felcoslop/LAB_III_Grupo_D_UFMG_2026_2/README.md

# Robô Sumô 1 kg com ESP32









Firmware e painel de telemetria do robô sumô autônomo da classe de 1 kg do **Grupo D**, desenvolvido na disciplina ELE635 Laboratório de Sistemas III da UFMG. O ESP32 lê cinco ou sete sensores de distância VL53L0X e quatro sensores de linha TCRT5000, estima onde está o oponente com um filtro bayesiano em grade, estima onde fica o centro do dojô com um filtro de partículas e decide o movimento com uma máquina de estados de três estratégias, escolhidas na chave DIP. Um painel web, que abre direto no navegador e conversa com o robô pela USB ou, opcionalmente, pelo Wi-Fi do próprio robô, mostra sensores, mapa de probabilidade, rumo e estado em 2D e 3D, e um simulador com o firmware de verdade roda lutas inteiras no GitHub Pages.

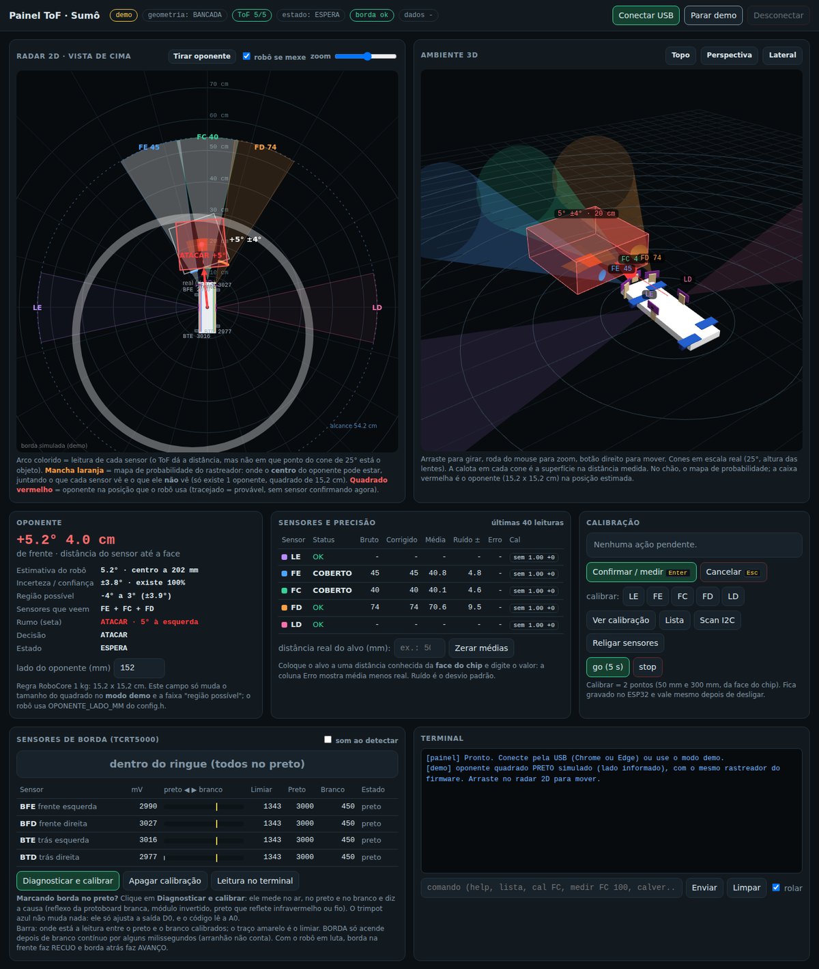
[picture p1: doc/img/painel_demo.jpg]
Painel do robô em modo demo, com radar 2D, ambiente 3D, tabela de precisão e sensores de borda


## Sumário

- [Contexto](#contexto)
- [Funcionalidades](#funcionalidades)
- [Hardware](#hardware)
- [Cinemática das rodas](#cinemática-das-rodas)
- [Estratégias e chave DIP](#estratégias-e-chave-dip)
- [Localização no dojô](#localização-no-dojô)
- [Lutas simuladas](#lutas-simuladas)
- [Combate com dois firmwares](#combate-com-dois-firmwares)
- [Montagem 3D](#montagem-3d)
- [Instalação](#instalação)
- [Uso](#uso)
- [Arquitetura](#arquitetura)
- [Mapa do código](#mapa-do-código)
- [Configuração](#configuração)
- [Estrutura de pastas](#estrutura-de-pastas)
- [Integração contínua](#integração-contínua)
- [Equipe](#equipe)
- [Referências](#referências)

## Contexto

O projeto faz parte da disciplina ELE635 Laboratório de Sistemas III, do curso de Engenharia de Sistemas da UFMG, no semestre 2026/2, com o Prof. Gustavo Medeiros Freitas. A disciplina cobre o ciclo completo de um projeto de engenharia, da concepção até a competição, e o robô segue a classe de 1000 g (Lego/Vex Sumô) das regras de sumô da RoboCore [ROBOCORE, s.d.a]: massa de até 1000 g, base de 15,2 x 15,2 cm, dojô (no código, dohyo) preto de 77 cm de diâmetro com borda branca de 2,5 cm, controle totalmente autônomo e início obrigatório 5 s depois do comando.

A versão atual é o robô montado no chassi de dois andares, sem protoboard: a extensora do ESP32 recebe os sete VL53L0X, os quatro TCRT5000, a ponte H, o botão de início e a chave DIP, a bateria 3S alimenta os motores e uma célula 18650 sozinha alimenta a lógica, com uma chave liga e desliga. A página [Montagem Grupo D](https://felcoslop.github.io/LAB_III_Grupo_D_UFMG_2026_2/montagem.html) mostra cada componente e cada fio, e o CAD final do projeto mecânico está dividido em um STL por peça na pasta [`cad/`](cad/README.md).

O `config.h` vem com `GEOMETRIA_BANCADA 0` (a tabela da bancada só é lida pelos geradores dos PDFs e não é mais usada no robô), `QTD_TOF 5` e `USAR_MOTORES 0`. Com os motores desligados no firmware, o ESP32 fica ligado ao computador pela USB, que alimenta a placa e leva a telemetria, a máquina de estados roda normalmente e o painel mostra o comando que iria para cada roda. Para o robô andar, o `config.h` precisa de `USAR_MOTORES 1` (e `USAR_WIFI 1` para o painel sem cabo). A quantidade de ToF (5 ou 7), o modo autônomo, a posição dos sensores de linha da frente e as outras opções mudam pelo painel e ficam gravadas no robô (seção [Opções do robô](#opções-do-robô-gravadas-pelo-painel)); `QTD_TOF` e `AUTO_START` do `config.h` são só o valor de fábrica. O CI compila o firmware com 5 e com 7 sensores de fábrica, com e sem motores.

## Funcionalidades

- Identificação dos VL53L0X (5 ou 7, escolhidos no painel) pelo pino XSHUT, com endereço I2C próprio para cada sensor e nova tentativa automática quando algum para de responder.
- Leitura escalonada e sem bloqueio dos ToF, com mediana de 3 leituras e calibração de 2 pontos gravada na memória do ESP32.
- Rastreador bayesiano em grade polar, que aproveita também a informação dos sensores que não veem nada e reconhece a arena vazia. A leitura dos ToF e o rastreador rodam no núcleo 0, e o loop com a borda, a localização e a estratégia roda no núcleo 1.
- Perfil de oponente escuro na DIP 4: sensores com mais tempo de medida e limiar de sinal menor para robôs pretos e foscos, e o rastreador com o modelo de ruído desse perfil. O perfil claro continua igual ao de antes.
- Localização no dojô sem encoder: um filtro de partículas estima onde fica o centro do dojô a partir do modelo das rodas e dos sensores de borda. A fuga da borda termina virada para o centro, a busca volta para o meio e leituras de pessoas e objetos fora do dojô não viram oponente.
- Três estratégias na chave DIP (Rush, Flank e Fan out), com resposta de frente a investidas rápidas, empurrão de ré com o oponente colado atrás e reconhecimento do oponente encostado na lateral.
- Rumo (a seta do painel) até o oponente ou até os pontos cegos, usado pela máquina de estados na busca.
- Leitura analógica da linha branca, com confirmação por tempo e calibração guiada em três medidas (ar, preto e branco).
- Máquina de estados com contagem obrigatória de 5 s, busca, mira, ataque, flanco, ataque de ré e fuga da borda em quatro direções, sem nunca girar para trás quando a borda está atrás.
- Reconhecimento de travamento sem encoder: o giro preso pelo oponente encostado na lateral vira uma manobra curta de soltura, e o empurrão longo em contato aparece no painel, reconhecido também pela caixa do rastreador parada, com cinco manobras experimentais de saída que se desligam no `config.h`; um modelo térmico de cada motor limita o PWM das manobras se o motor travado esquentar demais.
- Cinemática das duas rodas com o modelo do motor JGB37-520 e da ponte H: cada estado pede avanço em mm/s e giro em graus/s, a fuga da borda usa a tensão toda na hora e o firmware não compila se a distância de parada não couber na margem até as rodas. Os comandos `pwm` e `mov` testam os motores com o robô parado.
- Painel 2D e 3D em um único arquivo HTML, sem internet, ligado ao robô pela USB ou pelo Wi-Fi, com dados a 50 Hz e comandos pelo navegador.
- WiFi opcional, com a chave `USAR_WIFI` do `config.h` (0 por padrão): com 0 o firmware não tem uma linha do rádio, sem WiFi e sem Bluetooth, o que deixa o núcleo 0 livre para os sensores e o rastreador, e com 1 o painel funciona sem cabo.
- Simulador de lutas (software in the loop): o firmware compilado no computador luta contra seis tipos de oponente, com pessoas paradas em volta do dojô, e o CI roda uma bateria de lutas em todo pull request.
- Combate em 3D com o mesmo firmware nos dois robôs, na física de Belo Horizonte (gravidade e ar do lugar, pneu de silicone na madeira pintada, choque com restituição), e montagem 3D com cada jumper do esquema, as duas em páginas versionadas no repositório.
- Calibração da pista no painel (preto do dojô e faixa branca de 2,5 cm, com pares de sensores) que grava um limiar com margem dos dois lados para cada sensor de linha, contra a borda "alucinada" por arranhão, reflexo ou sujeira.
- Demonstração sem botão, sem chave e sem modo autônomo, só com o painel: "Alinhar com o oponente" (o robô fica no mesmo lugar e só gira, em pulsos, até ficar de frente para o oponente que os sensores da frente veem) e controle remoto WASD, pela USB ou pelo Wi-Fi, valendo com o sensor de linha marcando ou não.
- Opções do robô no painel, gravadas na memória do ESP32 sem regravar o firmware: modo autônomo, sensores de linha da frente de lado, 5 ou 7 sensores de oponente, contagem de 5 s com giro até alinhar (o botão BOOT reinicia a contagem), Wi-Fi ligado na luta e telemetria leve pelo Wi-Fi (só o essencial pelo rádio, para o controle remoto e os ajustes responderem rápido).
- Terminal de comandos pela USB ou pelo painel para teste, calibração e diagnóstico.
- Página de controle dos motores pelo teclado (`site/controle_motores.html`), para o teste do robô parado pela USB, sem os sensores ligados (o mesmo controle também está no painel, pela USB ou pelo Wi-Fi).

## Hardware

| Componente | Qtd. | Uso no projeto |
|---|---|---|
| ESP32 DevKit V1 (ESP32-WROOM-32D, 30 pinos) | 1 | microcontrolador de dois núcleos, com ADC (o rádio só liga com `USAR_WIFI 1`) |
| Extensora (expansion board) do ESP32 de 30 pinos | 1 | recebe o ESP32 e dá um trio S, V e G por GPIO, no lugar da protoboard |
| VL53L0X (placas CJVL53L0XV2 / GY-530) | 7 | distância até o oponente: LE, FE, FC, FD, LD, TE e TD (o firmware também compila com 5, sem TE e TD) |
| TCRT5000 com comparador LM393 | 4 | linha branca da borda, lida pela saída analógica A0 |
| Motor JGB37-520, 12 V, 319 rpm (redução de 18,8:1) | 2 | tração, com pneu StickyMAX S20 de 32 mm [ROBOCORE, s.d.b] |
| Células 18650 (LG 3200) | 3 | bateria 3S, que alimenta os motores pela ponte H |
| BMS 3S de 20 A | 1 | proteção e carga da bateria 3S |
| Célula 18650 sozinha, da lógica | 1 | alimenta o ESP32 e os sensores, pelo regulador TPS63070 |
| Regulador TPS63070 (saída de 3,3 V) | 1 | 3,3 V da lógica, ligado nos pinos V e G da extensora |
| Chave liga e desliga KCD1 | 1 | liga e desliga a célula da lógica (furo C da tampa de trás) |
| Módulo HW-956 de ponte H dupla de 10 A (3 a 18 V, entradas IN1 a IN4) | 1 | ponte H de MOSFET dos dois motores, com PWM de até 2 kHz (desativada na bancada) |
| Botão de início de 12 x 12 mm | 1 | start, ligado entre o GPIO 0 e o GND, em paralelo com o botão BOOT da placa (furo B da tampa de trás) |
| Chave DIP de 4 vias | 1 | ligada nos GPIOs 12, 14, 2 e 15: estratégia (DIP 1 a 3) e perfil do oponente escuro (DIP 4) (furo A da tampa de trás) |
| Jumper fêmea-fêmea | 38 | sensores, ponte H e emendas do I2C (lista completa na página Montagem 3D) |
| Fio soldado com ponta fêmea, com termorretrátil nas emendas | 23 | duas emendas do SDA e do SCL, chave DIP e TPS63070 |
| Fio 22 AWG | 17 | motores, bateria 3S, BMS e alimentação da ponte H, soldados nos bornes e terminais |
| Peças impressas em PLA | 17 | Base, Frente1 e Frente2, Laterais, Hastes, Topo, suportes dos motores e sete suportes de sensor SS_* ([`cad/`](cad/README.md)) |

Os interruptores são três: a chave DIP (estratégia e perfil), a chave liga e desliga KCD1 (só a lógica) e o botão de início. O ramo dos motores não tem chave própria.

| Função | GPIO | Observação |
|---|---|---|
| I2C SDA / SCL | 21 / 22 | barramento comum dos ToF, a 100 kHz |
| XSHUT LE / FE / FC / FD / LD | 17 / 23 / 19 / 18 / 5 | um fio por sensor, define o nome de cada um; o 5 é pino de boot e precisa de nível alto, o mesmo do XSHUT ligado |
| XSHUT TE / TD (só com 7 sensores) | 16 / 4 | sem restrição de boot |
| Borda BFE / BFD (frente) | 34 / 35 | ADC1, pinos só de entrada |
| Borda BTE / BTD (trás) | 32 / 33 | ADC1 |
| Ponte H IN1 / IN2 | 25 / 26 | motor esquerdo, com o PWM de 1 kHz no próprio IN |
| Ponte H IN3 / IN4 | 27 / 13 | motor direito |
| Botão de start | 0 | `INPUT_PULLUP`, nível baixo indica botão apertado; não pode estar apertado na hora de ligar. Sem o botão, o modo autônomo (opção do painel, ou `AUTO_START 1` de fábrica) faz o start sozinho (veja "Teste da máquina de estados") |
| Chave DIP 1 a 4 | 12 / 14 / 2 / 15 | cada via liga o pino no 3V3 |

A pinagem segue o documento de ligação da placa nova (Lab3-Liga) e o esquema do Fritzing. Todos os sensores ficam no 3V3 do ESP32. As placas clone do VL53L0X puxam SDA e SCL para 2,8 V, nível que o ESP32 entende como 1, e o firmware nunca coloca nível alto no XSHUT: para desligar um sensor o pino vira saída em LOW e, para ligar, vira entrada com o pull-up interno. Os sensores de borda usam os pinos 34, 35, 32 e 33 do ADC1 e precisam do fio na saída A0 dos módulos; no esquema atual o fio sai do D0, que só entrega 0 ou 3,3 V e não separa arranhão de linha.

A chave DIP pede três cuidados. A DIP 1, no GPIO 12, precisa estar desligada na hora de ligar o ESP32, porque nível alto nesse pino durante o boot muda a tensão da memória flash e a placa não liga. A DIP 3, no GPIO 2, precisa estar desligada na hora de gravar o firmware. E o GPIO 2 deixou de acender o LED de status (`PINO_LED -1`): com a chave ligada e o pino em LOW, o 3V3 ficaria em curto com o pino. Como o firmware lê a chave o tempo todo e trava a escolha só no start, a DIP 1 pode ser ligada depois do boot, com o robô já no dojô. Outra saída para o GPIO 12 é gravar os eFuses da tensão da flash em 3,3 V (`espefuse.py set_flash_voltage 3.3V` no esptool 4, `espefuse set-flash-voltage 3.3V` no esptool 5), que fazem o ESP32 ignorar o pino no boot; a gravação é permanente e só serve para módulos com flash de 3,3 V, como o ESP32-WROOM-32 do DevKit [ESPRESSIF SYSTEMS, s.d.b].

Na bancada (`GEOMETRIA_BANCADA 1`, que não é mais usada no robô e só alimenta os geradores dos PDFs), a origem do referencial é o centro da protoboard, com x para a frente e y para a esquerda, em milímetros:

| Sensor | XSHUT | Endereço | x | y | Ângulo |
|---|---|---|---|---|---|
| LE | 17 | 0x30 | -1 | 30 | 90° |
| FE | 23 | 0x31 | 73 | 27 | 20° |
| FC | 19 | 0x32 | 87 | -1 | 0° |
| FD | 18 | 0x33 | 73 | -27 | -20° |
| LD | 5 | 0x34 | -2 | -30 | -90° |
| TE (7 sensores, posição prevista) | 16 | 0x35 | -80 | 25 | 160° |
| TD (7 sensores, posição prevista) | 4 | 0x36 | -80 | -25 | -160° |

No robô montado (`GEOMETRIA_BANCADA 0`), a origem fica no meio do eixo das rodas, no chão, e as posições saem do chassi de dois andares do editor 3D v11 (a página `montagem.html` confere esta tabela contra o editor): FE, FC e FD na face inclinada da frente, LE e LD na lateral à frente do eixo, retos, e TE e TD em suportes angulares atrás da roda, a ±160° para trás e para fora:

| Sensor | XSHUT | Endereço | x | y | Ângulo |
|---|---|---|---|---|---|
| LE | 17 | 0x30 | 46 | 70 | 90° |
| FE | 23 | 0x31 | 77 | 32 | 17° |
| FC | 19 | 0x32 | 83 | 0 | 0° |
| FD | 18 | 0x33 | 77 | -34 | -17° |
| LD | 5 | 0x34 | 46 | -70 | -90° |
| TE (7 sensores) | 16 | 0x35 | -30 | 66 | 160° |
| TD (7 sensores) | 4 | 0x36 | -30 | -66 | -160° |

Os PDFs da pasta `doc/pdf/` são da bancada com protoboard: trazem os gabaritos em escala 1:1 da bancada e do robô, o mapa de ligação na protoboard e uma lista de conferência antes de energizar. O `guia_montagem_sensores_7.pdf` faz o mesmo para a versão de 7 sensores e traz também a pinagem completa do ESP32. Para o robô montado, sem protoboard, o guia de ligação é a página Montagem 3D (seção Montagem 3D, abaixo) e a lista de jumpers e fios dela.

### Posição dos sensores: 5 ou 7

A quantidade de ToF em uso (5 ou 7) é uma opção do painel, gravada no robô, que escolhe entre os 5 sensores originais e a versão de 7, com um par atrás do eixo (TE e TD); a constante `QTD_TOF` do `config.h` é só o valor de fábrica, e as duas tabelas do `config.h` sempre trazem os 7 sensores. Na bancada e na previsão do estudo abaixo o par fica nas quinas de trás, a ±160°; no robô montado o par fica atrás das rodas, em suportes angulares (x = -30 mm, y = ±66 mm), também a ±160° (o `config.h` do robô tem essa posição). O LE e o LD continuam retos, a ±90°, na lateral à frente do eixo. A pendência do chassi é a inclinação dos três sensores da frente, que apontam uns 27° para cima (veja a seção Montagem 3D). Os 5 sensores de antes não mudam: FC no centro, que é quem decide o ataque, FE e FD a ±20° na bancada (±17° no robô montado) e LE e LD a ±90°. O par novo fica no fim da tabela, então os 5 sensores de antes mantêm XSHUT, endereço, cor no painel e calibração gravada; com 5 sensores em uso, o XSHUT do TE e do TD fica em LOW e os dois não são usados.

O capítulo 2 do Sumo Robot Blackbook pede número ímpar de sensores, com um no centro para centralizar o oponente, e diz que os sensores precisam vigiar todas as áreas por onde o oponente pode atacar, principalmente os cantos [DEDE, s.d.]. O exemplo de 7 do livro acrescenta duas diagonais na frente, mas o livro não trata de sensores atrás. Com os 5 sensores de hoje, a frente já enxerga bem: o buraco entre FE e LE (de 32,5° a 77,5°) só existe a mais de uns 25 cm, porque os cones se cruzam perto do robô, e o oponente que vem por ali entra em algum cone antes de encostar. A traseira, de 115° a 180°, não tem nenhum sensor. Com o par atrás, o total continua ímpar, o FC continua sozinho no centro e a área sem cobertura passa a ser vigiada.

A escolha saiu de uma simulação com o rastreador do firmware compilado no computador, robô de 152 mm e oponente preto de 15,2 cm: 500 ataques em linha reta a 0,4 a 1,2 m/s com o robô parado, 300 buscas seguindo o rumo do firmware a partir de posições sorteadas dentro do dojô e 240 sequências de rastreio com o oponente andando.

| Robô de 152 mm | 5 (hoje) | 7, par na frente a ±45° | 7, par atrás a ±160° |
|---|---|---|---|
| Ataques que chegam sem ser vistos | 36% | 36% | 8% |
| Ataques por trás que chegam sem ser vistos | 83% | 82% | 9% |
| Tempo médio de busca com o oponente parado (90% dos casos) | 206 ms (700 ms) | 185 ms (660 ms) | 35 ms (140 ms) |
| Tempo médio de busca com o oponente andando (90% dos casos) | 317 ms (922 ms) | 268 ms (880 ms) | 34 ms (120 ms) |
| Erro de ângulo na frente, 90% dos casos | 7,5° | 6,1° | 7,5° |
| Posições do dojô dentro de algum cone | 58% | 64% | 88% |

O par na frente melhora um pouco a mira nas diagonais, mas não muda o que passa sem ser visto. O par atrás reduz os ataques sem aviso de 36% para 8% e deixa a busca cerca de 6 vezes mais rápida, sem mudar a precisão na frente. O ângulo de ±160° veio de uma varredura: com o par a ±140°, ±150°, ±160° e ±170°, os ataques por trás sem aviso ficaram em 17%, 12%, 9% e 8%, e a ±170° o ganho é pequeno e o aviso chega mais tarde. Os pontos sem cobertura que restam são o buraco diagonal a mais de 25 cm e uma faixa estreita bem atrás a mais de 30 cm. Esses números valem para o par a ±160°, que é o do robô montado. Com o par reto a ±90° (a primeira versão do chassi), os dois ToF de cada lado olhavam para a mesma direção e a faixa de trás (de 115° a 180°) ficava sem cobertura, e dois ToF olhando para o mesmo lado somavam a plateia em volta do dojô: na bateria com pessoas em volta, o robô chegou a ficar 45 s mirando uma pessoa e a vitória sobre o oponente parado passou de 2,5 s para 13 s. O par de trás a ±160° também enxerga a plateia: com o alcance inteiro de 600 mm ele mirou uma pessoa por até 53 s em 11 de 540 lutas. O `TOF_ALCANCE_LATERAL_MM` limita o alcance dos laterais (LE e LD) e o `TOF_ALCANCE_TRAS_MM`, o do par de trás (TE e TD). O valor dos laterais saiu da bateria de 540 lutas com pessoas em volta (15 largadas): o maior tempo mirando uma pessoa foi de 49,7 s com 180 mm, 29,8 s com 150 mm, 5,9 s com 120 mm, 29,6 s com 100 mm e 1,0 s com 80 mm, com 347 a 355 vitórias em todos. O padrão ficou em 80 mm: o lado só enxerga o oponente encostado ou quase, e a frente cuida do resto. Para o par de trás, a mesma bateria com o par a ±160° deu 350 vitórias com 80 mm e 352 com 200 mm (351 com o par reto), e o maior tempo mirando uma pessoa foi de 0,5 s e de 0,7 s; o padrão ficou em 200 mm, o que deixa o robô ver por trás o oponente que chega a 20 cm. As vitórias não separam as quatro configurações; o ganho do par a ±160° está na cobertura por trás do estudo acima, que a bateria de lutas não mede sozinha. Esses números são de simulação, e o oponente que passa pela lateral a mais de 8 cm só aparece para os sensores da frente; o teste na bancada com o painel é o que confirma o ganho.

Radar 2D do painel com 7 sensores e o oponente atrás, visto só pelo TE

Com a pinagem da placa nova, os únicos GPIOs livres são o 36 e o 39, que servem só como entrada e não podem acionar um XSHUT. Um 8º sensor precisaria de um pino da chave DIP ou de um expansor I2C, como o PCF8574, e ainda deixaria o número de sensores par, o que o livro desaconselha [DEDE, s.d.].

## Cinemática das rodas

O robô tem duas rodas de tração, uma de cada lado, e anda como um robô diferencial: com as duas rodas na mesma velocidade ele segue reto, com velocidades diferentes ele faz curva e com velocidades opostas ele gira no eixo. A máquina de estados não trabalha com PWM. Cada estado pede um avanço `v`, em mm/s, e um giro `w`, em graus/s (positivo para a esquerda, o mesmo sentido dos ângulos dos sensores), e o módulo `cinematica.cpp` transforma o pedido no PWM de cada lado da ponte H. A origem do referencial fica no meio do eixo das rodas, então o ângulo do oponente que sai do rastreador já é o giro que o robô precisa fazer.

```mermaid
flowchart LR
    EST["estados.cpp<br/>v em mm/s, w em graus/s"] --> DES["desaturação<br/>prioridade para o giro"]
    DES --> LIM["limitador de aceleração<br/>(fora no perfil da borda)"]
    LIM --> CI["cinemática inversa<br/>vE = v - w.B/2<br/>vD = v + w.B/2"]
    CI --> FF["feed-forward<br/>kS + kV.v + kA.a"]
    FF --> MOT["motores.cpp<br/>PWM na ponte H"]
    FF --> EST2["modelo ao contrário<br/>velocidade estimada das rodas"]
    EST2 --> RAS["rastreador<br/>gira o mapa junto"]
    EST2 --> GIR["GIRO_BORDA<br/>mede os 135 graus"]
```

### Simulador na web

A página [https://felcoslop.github.io/LAB_III_Grupo_D_UFMG_2026_2/](https://felcoslop.github.io/LAB_III_Grupo_D_UFMG_2026_2/) roda no navegador as mesmas contas do `cinematica.cpp` e da máquina de estados: o dojô aparece visto de cima, o oponente pode ser arrastado com o mouse e o botão Rodar mostra, a cada instante, o pedido do estado, a desaturação, o limitador, a cinemática inversa, o feed-forward e o PWM de cada roda, junto com o caminho do robô e a fuga da borda. Embaixo, a página refaz a conta da distância de parada para qualquer tensão de bateria e qualquer atrito. O código da página fica em `site/index.html`; o workflow `pages.yml` publica a página no GitHub Pages a cada mudança na `main`, e o CI roda o `ferramentas/confere_site.py` em todo pull request para garantir que as constantes da página continuam iguais às do `config.h`.

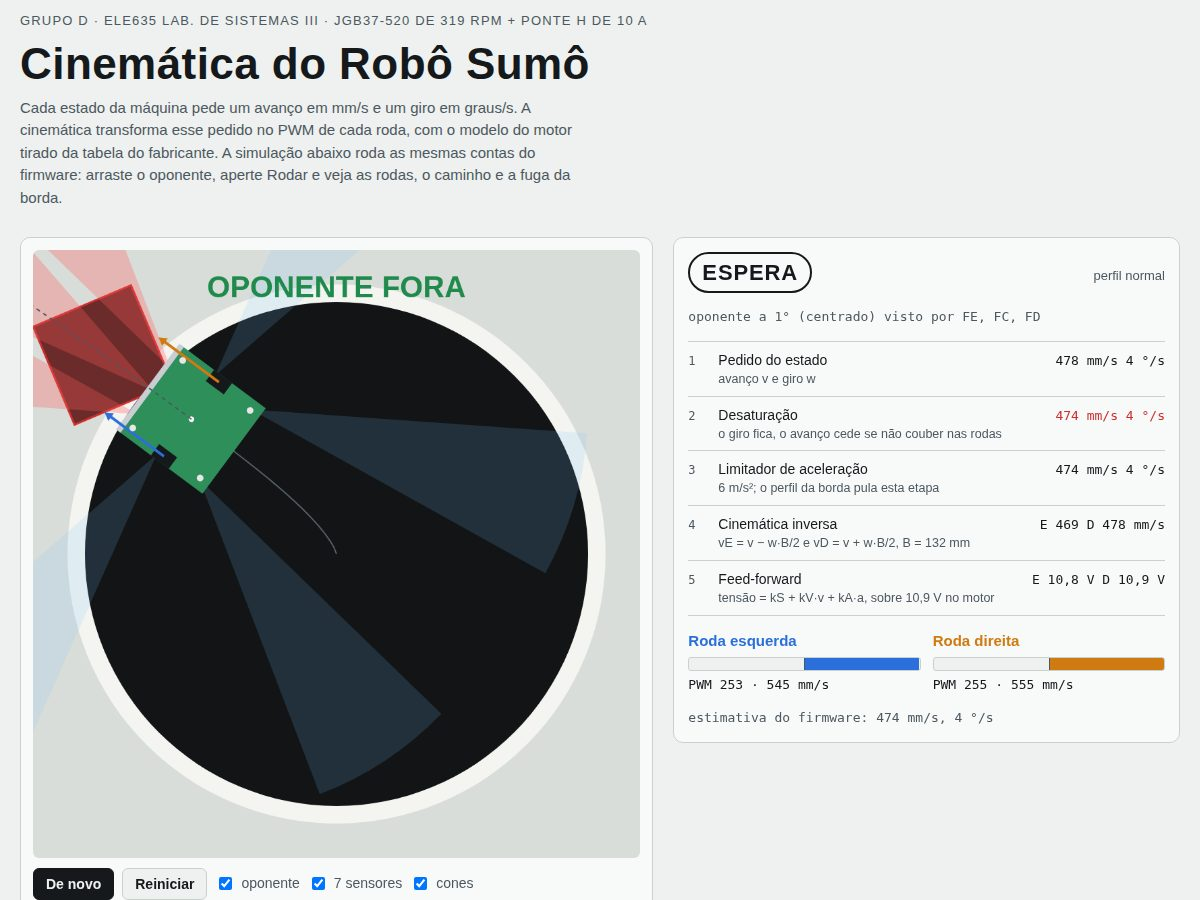
[picture p2: doc/img/simulador_cinematica.jpg]
Simulador da cinemática no navegador, com o robô empurrando o oponente para fora do dojô (https://felcoslop.github.io/LAB_III_Grupo_D_UFMG_2026_2/)


### Modelo do motor

A base do modelo é a tabela do fabricante para a linha de 12 V e 319 rpm do JGB37-520 [RCDRONE, s.d.] e a medida do pneu [ROBOCORE, s.d.b]. O esquema da placa mostra um L298N, mas a ponte usada é um módulo de 10 A com transistores MOSFET, que perde só alguns décimos de volt; um L298N perderia de 1,8 a 3,2 V com 1 A [STMICROELECTRONICS, s.d.a]. O anúncio do motor fala em 21 kgf.cm, valor que não fecha com a corrente de 1,2 A nem com a redução de 18,8:1 e por isso ficou de fora.

| Dado | Valor | Origem |
|---|---|---|
| Rotação livre a 12 V | 319 rpm | tabela do motor |
| Redução | 18,8:1 | tabela do motor |
| Corrente livre e com o eixo travado | 0,1 A e 1,2 A | tabela do motor |
| Torque com o eixo travado | 1,9 kgf.cm (0,19 N.m) | tabela do motor |
| Tensão de partida | 1,5 V | tabela do motor |
| Queda na ponte H | cerca de 0,2 V | estimada para a ponte de MOSFET, precisa de medida |
| Diâmetro da roda | 32 mm | pneu StickyMAX S20 |
| Bitola (centro a centro das rodas) | 126,8 mm | STEP LAB3-Modelagem do projeto mecânico (10/2026); medir no chassi |

O modelo do motor é uma reta de tensão por velocidade que passa pelos dois pontos da tabela: 1,5 V para sair do lugar e 319 rpm livre com 12 V. Com a bateria 3S em 11,1 V e 0,2 V perdidos na ponte H, o motor recebe 10,9 V com PWM de 100%:

| Resultado do modelo | Valor |
|---|---|
| Velocidade máxima em linha reta | 478 mm/s (cerca de 555 mm/s com a bateria cheia) |
| Giro máximo no eixo | 417 graus/s, meia volta em 0,43 s |
| kS, kV e kA de cada roda | 1,5 V; 19,6 mV por mm/s; 1,25 mV por mm/s² |
| Força no chão na partida, por roda | 3,9 N, no limite dos 3,9 N que o atrito permite com atrito 1 |
| Distância de parada na borda, no pior caso | 38 mm |

Esses números corrigem três valores antigos do `config.h`, que estavam marcados como "precisa ser medido". O rastreador girava o mapa a 600 graus/s com PWM máximo, quase 45% acima do giro real, e andava com ele a 1500 mm/s, mais de três vezes a velocidade real. E o giro de fuga da borda, de 250 ms com PWM 200, dava só uns 80 graus, e não os 135 graus do comentário.

### Do pedido ao PWM

Cada volta do loop passa o pedido da máquina de estados por quatro etapas:

1. Desaturação com prioridade para o giro. Quando avanço e giro juntos passam da velocidade máxima de uma das rodas, o avanço diminui e o giro fica. O linorobot2_hardware reduz os dois na mesma proporção [JIMENO, 2021]; no sumô a mira vale mais que a velocidade, porque um robô que chega rápido e torto entrega a lateral para o oponente.
2. Limitador de aceleração, no estilo do SpeedLimiter do diff_drive_controller [ROS-CONTROLS, s.d.], com 6 m/s², perto do limite de tração. O limite segura as reversões bruscas, quando a corrente do motor chega a 2 A e a roda patina, e também a partida, que com a ponte de MOSFET fica no limite da tração. O perfil da fuga da borda não passa por ele.
3. Cinemática inversa do diff_drive_controller [ROS-CONTROLS, s.d.]: a roda esquerda anda `v - w.B/2` e a direita `v + w.B/2`, com B a bitola.
4. Feed-forward do SimpleMotorFeedforward do WPILib [WPILIB, s.d.]: a tensão de cada roda é `kS.sinal(v) + kV.v + kA.a`, dividida pela tensão que chega no motor. O kS vence o atrito de partida; sem ele, um pedido de 5 mm/s viraria PWM 2 e a roda nem sairia do lugar.

O JGB37-520 deste projeto não tem encoder. Por isso o mesmo modelo, rodado ao contrário, estima a velocidade real de cada roda a partir do PWM aplicado, com o atraso de 60 ms do motor. A estimativa entra no rastreador, que gira o mapa de probabilidade junto com o robô, e mede o giro de recuperação na borda.

### Cada estado em avanço e giro

| Estado | Avanço `v` | Giro `w` | Perfil |
|---|---|---|---|
| BUSCA sem pista | 0 | 200 graus/s para o lado do rumo | normal |
| BUSCA com o oponente provável à frente, ou no avanço curto | 240 mm/s | 0 | normal |
| MIRA até 40 graus | `VEL_MAX.cos(ângulo)` | `6.ângulo`, até 370 graus/s | normal |
| MIRA acima de 40 graus | 0 | 370 graus/s para o lado do oponente | normal |
| ATAQUE | `VEL_MAX` | `6.ângulo` (correção) | normal |
| RECUO | `-VEL_MAX` | 0 | borda |
| AVANCO_BORDA | `VEL_MAX` | 0 | borda |
| GIRO_BORDA | 0 | 370 graus/s, até 135 graus estimados | normal |

A mira é proporcional: o giro pedido é 6 graus/s para cada grau de erro, e o erro cai a 37% em cerca de 0,17 s. Com o oponente a 20 graus para a esquerda, por exemplo, a mira pede 120 graus/s de giro e 450 mm/s de avanço. Os dois juntos não cabem nas rodas, então a desaturação baixa o avanço para 340 mm/s e as rodas ficam em 202 mm/s (esquerda) e 478 mm/s (direita): uma curva fechada para o oponente, sem perder a mira. No ataque, a mesma correção mantém o oponente no centro enquanto o robô empurra.

### A borda vem antes de tudo

O RECUO e o AVANCO_BORDA usam o perfil da borda: sem limitador e com a tensão toda no sentido da fuga já na primeira volta do loop. No pior caso, com a bateria cheia e o robô a 555 mm/s, o robô percorre uns 3 mm durante os 6 ms de confirmação da borda e da volta do loop e mais 35 mm freando com a roda patinando para trás (atrito 0,7 e 80% do peso nas rodas), cerca de 38 mm no total. A margem é a faixa branca de 25 mm somada à distância entre o sensor de borda e o eixo das rodas, 60 mm no robô, ou seja, 85 mm. O `cinematica.cpp` faz essa conta durante a compilação (`static_assert`): um motor mais rápido, uma roda maior ou uma bateria com mais tensão que quebrem a margem param a compilação com uma mensagem de erro. Na frenagem mais longa, a ponta da lâmina pode passar da borda do dojô por um instante, mas as rodas ficam sempre a mais de 45 mm dela.

O giro de recuperação (GIRO_BORDA) também mudou. Antes ele durava um tempo fixo e ignorava a borda; agora ele termina quando a cinemática estima 135 graus, com 900 ms como limite de segurança, e continua vigiando a borda: uma quina que volta ao branco no meio do giro, ou um empurrão do oponente, leva o robô de novo ao RECUO ou ao AVANCO_BORDA.

### Acerto do modelo com o robô montado

Os valores marcados com "medir" no `config.h` ficam certos só com o robô montado. O capítulo 11 do Blackbook manda medir as primitivas de movimento antes de montar qualquer tática: a distância percorrida em um tempo fixo e o tempo de uma volta completa no eixo [DEDE, s.d.]. O comando `cin` mostra os números do modelo, e o comando `mov V W MS` faz o robô parado em ESPERA andar com avanço V e giro W por MS milissegundos e, no fim, mostra a distância e o giro estimados. Com `mov 300 0 1000`, a distância medida com a régua, comparada com a estimada, acerta o `MOTOR_RPM_LIVRE` ou a `PONTE_QUEDA_V`; com `mov 0 300 1000`, o giro medido no chão acerta a `BITOLA_MM`. Qualquer borda vista interrompe o teste na hora. Antes disso, o comando `pwm E D MS` confere os fios: cada roda recebe a porcentagem de PWM pedida (de -100 a 100, positivo para a frente), sem passar pela cinemática. Com `pwm 30 0 1000` só a roda esquerda precisa girar, para a frente; roda ao contrário se corrige com `INVERTE_ESQ` ou `INVERTE_DIR` e rodas trocadas com `TROCA_MOTORES`. Os dois testes funcionam com os ToF desligados, porque rodam no estado ESPERA, e durante eles o firmware não tenta religar os ToF.

A página [Controle dos motores](https://felcoslop.github.io/LAB_III_Grupo_D_UFMG_2026_2/controle_motores.html) (`site/controle_motores.html`) faz esses testes com as teclas W, A, S e D ou com as setas, em vez de digitar os comandos, e a barra de espaço para o robô. Ela conversa com o ESP32 pela porta USB (Web Serial, no Chrome ou no Edge do computador) e envia `mov` ou `pwm` a cada 120 ms, cada um válido por 250 ms, e `stop` ao soltar a tecla. Por isso o robô para sozinho quando a página perde o foco ou o cabo sai. A página precisa do firmware com `USAR_MOTORES 1`. Sem os TCRT5000 ligados, `USAR_BORDA` também precisa ficar em 0, porque um pino solto do ADC pode ler abaixo de 600 mV, contar como linha branca e interromper o teste na hora. Na primeira vez, com as rodas fora do chão, o modo PWM acerta `INVERTE_ESQ`, `INVERTE_DIR` e `TROCA_MOTORES`.

## Estratégias e chave DIP

As três estratégias da proposta do Grupo D [GRUPO D, 2026a] ficam nas vias 1 a 3 da chave DIP, e a via 4 escolhe o perfil do oponente. O firmware lê a chave com um filtro de 30 ms contra trepidação e trava a escolha no start: mexer na chave durante a luta não muda nada. Sem nenhuma via de estratégia ligada vale o Rush, e com mais de uma ligada vale a de menor número (o comando `lista` avisa o conflito). Os comandos `estrategia` e `perfil` passam por cima da chave para testes na bancada.

Na simulação de combate com os motores de 319 rpm, a escolha para a competição é o Rush (nenhuma via ligada), com o robô sempre colocado de frente para a metade do oponente: de frente, o Rush fez 119 vitórias, 0 derrotas e 42 empates em 161 lutas, o Fan out 52 vitórias e 0 derrotas em 114, e o Flank 39 vitórias e 28 derrotas em 125 (seção "Otimização do ataque com os motores de 319 rpm").

| DIP 1 | DIP 2 | DIP 3 | Estratégia | Busca sem pista | Chegada no oponente |
|---|---|---|---|---|---|
| ligada | desligada | desligada | Rush | giro no eixo para o lado do rumo, com avanços curtos | mira em curva e ataque com o torque todo |
| desligada | ligada | desligada | Flank | igual ao Rush | na largada, arco largo, mirando 75° ao lado do oponente mesmo com ele vindo rápido; depois, espiral que fecha na lateral dele |
| desligada | desligada | ligada | Fan out | leque: o rumo oscila 45° para cada lado e o robô avança devagar | zigue-zague (estado LEQUE): o rumo vai 30° para cada lado do oponente, trocando a cada 200 ms, e perto dele o ataque é direto |

| DIP 4 | Perfil | Sensores | Rastreador |
|---|---|---|---|
| desligada | oponente claro | o perfil de sempre: 20 ms por medida, limite de sinal 0,25 MCPS | o modelo de sempre |
| ligada | oponente escuro | 33 ms por medida, limite de sinal 0,10 MCPS e pulsos longos (VCSEL 18 e 14), alcance de 700 mm no preto | 15% de chance de não ver o oponente dentro do cone, 2,5 vezes mais leituras falsas, 1,5 vez mais ruído e 180 ms até perder o alvo |

O perfil escuro troca velocidade e limpeza da medida por sensibilidade. Um robô preto e fosco devolve pouca luz ao VL53L0X, e no perfil claro ele some antes do fim do dojô; com mais tempo de medida e um limite de sinal menor, o sensor enxerga mais longe, ao custo de uma medida a cada 33 ms e de mais leituras falsas, que o rastreador absorve com o modelo de ruído do perfil. Nas lutas simuladas contra oponentes escuros e furtivos (240 lutas, Rush, com e sem a DIP 4), o perfil escuro baixou o tempo até achar um oponente furtivo parado de 1,0 s para 0,5 s e o tempo até vencer o oponente errante escuro de 8,6 s para 4,4 s; as 240 lutas terminaram em vitória nos dois perfis.

No dojô de 77 cm, cada robô vê o outro assim que os 5 s acabam, e antes das aberturas as três estratégias faziam a mesma coisa na largada: a investida do outro robô cancelava o flanco, e o leque só valia na busca sem pista. Agora cada uma tem a sua abertura, com o oponente a até 60° da frente quando os 5 s acabam. O Rush vai direto. O Flank sai num arco largo, mirando 75° ao lado do oponente por até 0,7 s, mesmo com ele vindo rápido, e vira para ele quando o oponente fica a 75° da frente. O lado do arco é o que tem mais espaço até a borda pela localização, quando ela já é confiável. O Fan out chega em zigue-zague (estado LEQUE) e ataca direto a 14 cm. No combate com o mesmo firmware nos dois robôs (180 lutas, 10 largadas por combinação, contra os adversários de 1000, 600 e 319 rpm), o Rush venceu 25, perdeu 16 e empatou 19 de 60 lutas; o Flank, 24, 18 e 18; o Fan out, 16, 20 e 24. Com 60 lutas por estratégia, a diferença entre o Rush e o Flank fica dentro do erro da amostra (uns 5 pontos) e só o Fan out aparece atrás. O arco tira o robô da linha da investida, mas o adversário com o mesmo firmware vira para ele e às vezes encontra a lateral exposta. O ângulo do arco saiu de uma comparação com o Flank largando de frente (40 lutas por versão): com 60° e 1 s, 30 derrotas; com 75° e 0,7 s, 12; com 80°, 5, mas numa luta do `teste/sim` o arco deixou o robô na borda de frente para uma pessoa, e ele passou 4,7 s mirando nela, acima do limite de 3 s do CI. Nas lutas do `teste/sim`, o Flank venceu as 48 lutas contra o parado, o pesado e o rápido.

Depois da largada, no Flank, com o oponente à vista a mais de 24 cm e sem investida, o robô mira 35° ao lado dele; com o desvio constante, o caminho vira uma espiral que termina na lateral do oponente. O lado é o que tem mais espaço até a borda, pela localização no dojô. A 18 cm do oponente, com ele aberto mais de 75°, depois de 1,5 s ou se ele investir, o robô ataca direto. No Fan out, o leque só avança com pelo menos 20 cm livres à frente.

Algumas regras valem nas três estratégias. Um oponente que vem de frente a mais de 300 mm/s (investida) é recebido de frente, e o robô empurra com o torque todo: o JGB37-520 tem redução de 18,8:1, e um robô rápido costuma ter pouco torque, então oferecer a lateral numa curva é o pior caso. Com o oponente colado na frente, o ToF pode perder a leitura por estar perto demais, e o ataque continua por 400 ms sem confirmação. Com o oponente colado atrás (versão de 7 sensores), o robô empurra de ré em vez de girar 180° na frente dele. Uma leitura abaixo de 15 mm, o mínimo do VL53L0X, conta como oponente encostado naquele lado: o rastreador recebe essa posição, e o robô vira para ele em vez de perseguir outra coisa. E a busca sem pista começa voltando para o meio do dojô, quando a localização mostra o robô a mais de 15 cm do centro.

### Travamento

Sem encoder e sem medida de corrente, o firmware não vê a roda parada, mas reconhece dois travamentos pelo que a cinemática estima e pelo que os sensores veem.

O giro preso acontece com o oponente encostado na lateral: a mira pede giro, a cinemática estima mais de 90° de giro em 0,6 s, e o ângulo do oponente melhora menos de 15°, porque a quina dele segura a quina do robô. O robô entra no estado DESTRAVA: ré reta por 250 ms quando existe espaço atrás (sem branco atrás há pouco e, com a localização confiável, mais de 14 cm até a borda), ou avanço reto por 250 ms sem espaço atrás, e volta a mirar com a quina livre. Uma ré que termina na borda de trás faz as manobras dos 5 s seguintes usarem o avanço.

O empurrão travado é o ataque em contato que passa de 1,6 s sem a luta acabar. Nesse caso o robô continua empurrando, e o travamento só aparece no log e no painel. A decisão saiu das lutas simuladas: com 360 lutas por versão (3 estratégias, 6 oponentes, claro e escuro, 10 largadas), soltar o empurrão travado com ré e curva derrubou as vitórias contra o errante de 56 para 28 a 33 e transformou 49 empates contra o espelho em derrotas, com o limite de 1,6 s, 2,5 s ou 4 s; girar sob pressão (uma roda no máximo e a outra a 20%), girar no eixo ou dar ré em curva também perderam. Contra um oponente que empurra de volta, qualquer soltura entrega o lugar, e o empurrão mais longo que dá certo nessas lutas, contra o oponente pesado, passa de 5 s.

O módulo `antitrava.cpp` (experimental, fora com `ANTI_TRAVA 0` no `config.h`) reconhece o empurrão travado pela caixa do rastreador bayesiano, sem encoder: a caixa do oponente fica parada no referencial do robô, com a distância dentro de 25 mm e o lado dentro de 12°, por 1,2 s, com o robô no ATAQUE e o oponente encostado (ou a menos de 60 mm). Um salto da estimativa mais curto que 150 ms, comum com a leitura colada no contato, não zera a janela. Um empurrão que funciona também deixa a caixa parada, mas leva o oponente para fora do dojô de 77 cm em pouco mais de 1 s; passado esse tempo, os dois robôs estão empatados na força. Depois da detecção vem a manobra escolhida em `ANTI_TRAVA_MANOBRA`, ou pelo comando `trava N`, sem gravar:

| N | Manobra | O que o robô faz | Contra o robô igual (319 rpm, 60 lutas) | Contra o de 1000 rpm (60 lutas) |
|---|---|---|---|---|
| 0 | nenhuma | só avisa no log e no painel | 12 vitórias, 19 derrotas, 29 empates | 44, 14, 2 |
| 1 | lateral | ré em arco por 200 ms para o lado com mais espaço e volta em arco pela lateral do oponente (sem espaço atrás, vira a 2) | 12, 29, 19 | 45, 14, 1 |
| 2 | torque | 500 ms de empurrão com giro de 150°/s para o lado com mais espaço | 12, 19, 29 | 45, 14, 1 |
| 3 | zigue | o mesmo da 2, trocando o lado a cada 125 ms | 12, 19, 29 | 45, 14, 1 |
| 4 | giro | giro no eixo por 200 ms, com tensão toda desde o primeiro instante (perfil da borda, sem a rampa de aceleração), e volta a mirar | 13, 38, 9 | 44, 14, 2 |
| 5 | pulso | rodas soltas por 20 ms e empurrão de novo, três vezes | 12, 19, 29 | 44, 14, 2 |

Contra o robô igual, que continua empurrando, a ré com volta pela lateral trocou 10 dos 29 empates por derrotas e o giro trocou 20, porque o adversário com o mesmo motor empurrou o Grupo D para fora durante a manobra, como a equipe previa; o giro ganhou uma luta a mais (13 vitórias contra 12), e as outras manobras, nenhuma. Com o chassi novo, o torque, o zigue-zague e o pulso não mudaram nenhuma luta contra o igual. Com o chassi anterior (ponta da rampa a 117,7 mm e os sensores de trás a ±160°), o torque e o zigue-zague tinham trocado 66 e 92 empates por derrotas, então esse resultado depende da geometria e do rastreador, e as três só valem a pena depois do teste no dojô. A versão do pulso com ré de 50 ms perdeu 92 empates no chassi anterior; com as rodas soltas por 20 ms, ela não muda nenhuma luta. Com o oponente empurrando, o giro não passa de uns 10° em 200 ms, com ou sem a rampa de aceleração, e o robô é levado uns 10 cm para trás: sem avanço, as duas rodas em sentidos opostos não resistem ao empurrão. Variantes com solta de 60 a 200 ms, giro de 60 e 100 ms, ré de 60 e 100 ms e curva de 40 a 250°/s também foram testadas contra o igual, no chassi anterior: todas as que soltam por 100 ms ou mais perderam 11 a 12 das 12 lutas de cada teste, as de 60 ms perderam 10 ou 11, e só as que mantêm o empurrão (curva de até 80°/s, solta de até 60 ms) mantiveram o empate, sem nenhuma vitória. Girar o próprio robô também expõe a lateral dele à rampa do oponente. Por isso o firmware sai com `ANTI_TRAVA_MANOBRA 0`, e as manobras ficam para o teste no dojô de verdade, onde a deformação do pneu, a folga das caixas de redução e o piso irregular, que a simulação não tem, podem desempatar. Na página do combate, o seletor "Empurrão travado" liga cada manobra no robô do Grupo D, e um alerta piscante "Robô travado" mostra quem está travado e em que nível: empurrão travado (1,6 s), ré da DESTRAVA ou manobra da caixa parada. Para apagar o módulo de vez: os arquivos `antitrava.h` e `antitrava.cpp`, as linhas com `ANTI_TRAVA` no `estados.cpp` e no `debug.cpp` e o nome `antitrava` nas listas de compilação dos testes.

O cuidado com a sobrecarga fica com o modelo térmico de cada motor no `cinematica.cpp`. A corrente sai da tensão aplicada menos a força contraeletromotriz, sobre a resistência de 10 Ω (12 V e 1,2 A com o eixo travado, pela tabela do motor), e com a roda travada a força contraeletromotriz é zero. O calor entra num modelo de primeira ordem, com capacidade e resistência térmicas estimadas para um motor de 37 mm. Pelo modelo, um round inteiro de 90 s com o motor travado no máximo esquenta o motor uns 22 K, e o limite de 70% do PWM só liga com 60 K, depois de uns 7 minutos travado, como numa bancada com o robô preso contra a parede; a fuga da borda nunca é limitada. A ponte H HW-956 aguenta 10 A por canal, bem acima dos 1,2 A do motor travado, e a bateria 3S entrega os 2,4 A dos dois motores sem esforço. A capacidade e a resistência térmicas do modelo precisam de medida com um termômetro no motor, com o robô montado.

### Fuga da borda

A borda vem antes de qualquer estratégia. Cada sensor de borda confirmado no branco diz de que lado está a faixa, e a manobra depende da combinação:

| Sensores no branco | Estado | Manobra |
|---|---|---|
| só os da frente | RECUO | ré com a tensão toda até o branco sumir, mais 10 ms; um recuo que não tira a frente do branco em 300 ms (robô preso entre a borda e o oponente) vira uma curva de ré que desencaixa a traseira |
| só os de trás | AVANCO_BORDA | avanço com a tensão toda, sem nenhum giro para trás |
| frente e trás do mesmo lado | SAIDA_LATERAL | curva para dentro com a roda de dentro parada, o movimento que menos joga o canto de trás para fora |
| frente e trás em lados opostos | GIRO_BORDA | giro direto para o centro do dojô |

Depois do recuo, o GIRO_BORDA vira o robô de frente para o centro do dojô, pela localização, e a busca leva o robô de volta para o meio, já de frente para a outra metade do dojô; sem localização confiável, o giro é de 135° para longe da borda. O giro continua vigiando o oponente e a borda. Com a borda de trás no branco, girar para olhar para trás não faz sentido, porque atrás da faixa só existe o lado de fora e nenhum oponente: o robô avança, e por 400 ms os ToF de trás ignoram qualquer coisa a mais de 120 mm.

## Localização no dojô

O JGB37-520 não tem encoder e o robô não tem IMU, então a posição no dojô sai do modelo das rodas (`cinematica.cpp`) e dos quatro sensores de borda. O dojô é um círculo: o rumo absoluto não importa, basta saber onde fica o centro do dojô visto do robô. O `arena.cpp` guarda 600 hipóteses desse ponto em um filtro de partículas [THRUN; BURGARD; FOX, 2005]. A cada 5 ms o centro de cada hipótese anda ao contrário do movimento estimado do robô; cada partícula tem o próprio erro de escala do avanço e do giro, porque o erro do modelo das rodas é sistemático (bateria, atrito, pneu). Um sensor no branco diz que ele está na faixa, um sensor no preto diz que ele não está, e as rodas precisam estar dentro do dojô, senão o robô já teria caído. O modelo do branco tem um pico estreito onde o sensor deve estar e uma cauda larga, que puxa a nuvem para a explicação certa quando nenhuma hipótese bate com a borda.

Em contato com o oponente, ou com algo encostado num ToF, o modelo das rodas deixa de valer: o robô pode estar travado, patinando ou sendo empurrado de lado. Nesse caso cada partícula sorteia quanto do movimento pedido aconteceu e uma velocidade de empurrão, e guarda esse sorteio enquanto o contato dura; a borda escolhe as hipóteses certas. O mesmo modelo entra quando o branco que continua aparece onde o filtro confiante esperava preto, sinal de que o movimento real fugiu do modelo.

A localização tem três usos. O GIRO_BORDA termina de frente para o centro e a busca volta para o meio do dojô. O Flank e o Fan out medem o espaço livre até a borda em cada direção. E a percepção descarta o que cai fora do dojô: uma leitura de ToF só é descartada quando as 64 hipóteses da amostra colocam o ponto a mais de 30 mm além da borda, e o mapa do rastreador apaga, em cada direção, só os anéis que ficam fora em todas elas. O alcance dos ToF, de 600 mm, vem do pior caso dentro do dojô (o robô do Grupo D numa borda e o oponente encostado na borda oposta), então o oponente em qualquer ponto do dojô fica dentro do alcance.

O teste `teste/unidade/teste_arena.cpp` roda 150 lutas de um robô de mentira que larga como manda a CoRA, anda até a borda, recua, gira para o centro estimado e repete cinco vezes, com o modelo das rodas certo ou errado em 15%. Com 12 sementes e as duas geometrias (9000 medidas):

| Medida | Resultado |
|---|---|
| Erro do centro depois de 5 toques na borda, mediana | 19 a 23 mm |
| Erro do centro depois de 5 toques, 90% das lutas | 46 a 60 mm |
| Incerteza coerente com o erro (erro abaixo de 2,5 sigma + 2 cm) | 99% a 100% |
| Localização marcada como confiável com erro acima de 10 cm | 1,2% a 4,5% |
| Leitura do oponente a 6 cm da borda descartada como fora | 3 em 9000 (0,03%) |
| Pessoa a 12 cm além da borda descartada | 45% a 51% |

Os três descartes errados aconteceram com o filtro confiante e errado por mais de 30 cm, caso que o motor sem encoder não permite eliminar; uma leitura descartada vira "sem informação", e as leituras seguintes, de outros sensores ou de mais perto, continuam valendo. O descarte das pessoas não precisa ser completo: o que escapa dele bate no alcance de 600 mm, na regra da borda de trás e no rastreador, e nas lutas simuladas o robô mirou objetos de fora do dojô por no máximo 2,5 s numa luta inteira, numa luta de 36 s com o oponente encostado na lateral. O comando `arena` mostra o centro estimado, a incerteza, o espaço livre em 8 direções e o tempo do passo do filtro, que no computador leva uns 20 µs.

## Lutas simuladas

A pasta `teste/sim` compila o firmware de verdade (percepção, ToF, rastreador, localização, borda, estados, cinemática e motores) junto com um mundo simulado: física das rodas com atrito e tração, VL53L0X com cone, sinal, ruído e leituras falsas, TCRT5000 com o analógico do preto, do branco e do chão de fora, e um oponente com inteligência própria. Os robôs largam como manda a CoRA, cada um na sua metade, atrás da linha Shikiri e virado para qualquer lado, e a luta dura até alguém sair do dojô ou 90 s. Com a opção `-f`, pessoas paradas a 12 a 80 cm da borda entram na cena, visíveis para os ToF.

| Oponente | Comportamento |
|---|---|
| parado | caixa parada, com os motores desligados e a redução travada |
| pesado | parado, com pneu mais grudento e lâmina melhor |
| rápido | ataca a 1,3 m/s, com motor de alta rotação e pouco torque |
| lento | ataca a 0,2 m/s, com redução alta, muito torque, pneu grudento e lâmina melhor |
| errante | anda sem rumo pelo dojô e ataca só de perto |
| espelho | o mesmo motor, a mesma roda e a mesma lâmina do robô do Grupo D, atacando do mesmo jeito |

O robô do Grupo D tem as medidas do STEP do projeto mecânico (LAB3-Modelagem): rampa 118 mm à frente do eixo das rodas, traseira 31 mm atrás, 149 mm de largura, 980 g e o centro de massa 26,9 mm à frente do eixo. Na bateria com pessoas em volta do dojô (3 estratégias, 6 oponentes, claro e escuro, 15 largadas cada, 540 lutas), o robô venceu 351 lutas, perdeu 121 e empatou 68, e nunca saiu do dojô sozinho: 90 de 90 contra o parado e contra o pesado, 87 contra o rápido e 84 contra o errante. O lento, com mais torque e uma lâmina melhor, ganhou as 90 lutas, e o espelho, de força igual, terminou empatado em 66 de 90; nos dois casos o robô fica travado empurrando um oponente que não cede, e a seção [Travamento](#travamento) mostra por que soltar o empurrão piora o resultado. Sem as pessoas e com o oponente furtivo, que quase não reflete, a bateria de 810 lutas também terminou sem nenhuma queda própria.

A página [Lutas simuladas](https://felcoslop.github.io/LAB_III_Grupo_D_UFMG_2026_2/lutas.html) mostra as lutas no navegador: escolha de estratégia, oponente, cor e largada, com os dois robôs, o caminho, o dojô que a localização estima, o oponente que o rastreador estima, o estado e o PWM de cada roda a cada instante. O workflow da página gera os rastros e o placar com o firmware da `main` a cada publicação.

Luta simulada na página: Flank contra o oponente errante e escuro, com o dojô estimado pela localização e as pessoas em volta

No computador, a mesma bateria roda com:

```
bash teste/sim/compila.sh
python teste/sim/roda_lutas.py teste/sim/luta --dips 1,2,4 --fora --perfil-pela-cor --sementes 15
```

## Combate com dois firmwares

A pasta `teste/combate` coloca dois robôs com o mesmo firmware no mesmo dojô: o do Grupo D e um adversário igual, com motores de 1000, 600 ou 319 rpm. Cada módulo do firmware entra duas vezes no mesmo programa, uma no namespace `fa` e outra no `fb` (`fw_modulo.cpp`), sem nenhuma linha do firmware mudar, e o Arduino de mentira (`hal_combate.cpp`) atende o robô da vez com o relógio, a chave DIP, o botão de start, os quatro TCRT5000, os sete VL53L0X e o PWM da ponte H. O mesmo código vira um executável para a bateria de lutas e um módulo WebAssembly para a página [Combate Grupo D](https://felcoslop.github.io/LAB_III_Grupo_D_UFMG_2026_2/combate.html), compilado com o Zig 0.14 [ZIG SOFTWARE FOUNDATION, 2025].

A página mostra a luta em 3D com as peças do STL do projeto mecânico (base, corpo, suporte da eletrônica, abraçadeiras, JGB37-520, cubos e pneus), numa sala em Belo Horizonte às 20h00 de 2 de setembro, só com a lâmpada de LED do teto acesa. Na tela entram a estratégia do Grupo D, a cor e os motores do adversário, a estratégia dele e a posição na largada de cada um dos dois robôs; o placar mostra o estado de cada firmware, e a telemetria mostra velocidade, PWM, corrente, bateria e o peso em cada apoio. A camada de detecção mostra só o que o firmware do Grupo D enxerga, como no painel: o cone de cada VL53L0X com a calota na distância medida, o mapa de probabilidade do rastreador, a caixa vermelha do oponente na posição estimada e um círculo embaixo de cada TCRT5000. Cada cone tem o alcance que o firmware aceita para aquele sensor: 600 mm na frente, `TOF_ALCANCE_LATERAL_MM` (80 mm) no LE e no LD e `TOF_ALCANCE_TRAS_MM` (200 mm) no par de trás. Um oponente além do cone curto não é lido, não entra no rastreador e por isso não ganha a caixa vermelha, mesmo que esteja na direção do sensor; o `confere_site.py` compara essas três constantes da página com o `config.h`. No controle manual, as setas (ou W A S D) dirigem o robô do Grupo D ou o adversário depois dos 5 s parados.

### Física

| Item | Valor | Origem |
|---|---|---|
| Massa | 980 g em cada robô | pedido da equipe |
| Centro de massa | 26,9 mm à frente do eixo, 24 mm acima do chão | balanço de massa do projeto mecânico |
| Apoios | pneus com 77% do peso, ponta da rampa com 23% | estática com a ponta a 118 mm do eixo (STEP LAB3-Modelagem) |
| Pneu StickyMAX S20 (silicone de 20 Shore A, pegajoso, 32 x 20 mm, 10 g) na madeira pintada | atrito 1,15 parado e 1,30 escorregando, com a transição em 5 cm/s | borracha macia em superfície lisa: 1,2 a 2,0 parado e atrito escorregando maior que o parado, subindo com a velocidade [ROTH; DRISCOLL; HOLT, 1942; GROSCH, 1963]; perto do mínimo dessas medidas por causa da tinta e do pó; medir com o robô de rodas travadas puxado por um dinamômetro; medidas do pneu [ROBOCORE, 2024] |
| PLA arrastando no dojô e PLA contra PLA | 0,35 e 0,30 | estimativa |
| Choque entre os robôs | modelo contínuo de contato com restituição de 0,4 e rigidez de 30 N/mm | [FLORES et al., 2011]; restituição estimada para corpos de PLA com parafusos e placas, conferida com 0,2 e 0,6 |
| Gravidade | 9,7847 m/s² | gravidade normal do GRS80 na latitude da UFMG (-19,87°) com as correções de ar livre e de Bouguer para 830 m [MORITZ, 2000; HOFMANN-WELLENHOF; MORITZ, 2006] |
| Ar | 1,065 kg/m³, arrasto de caixa (Cd de 1) na frente de 14,9 x 5,15 cm | atmosfera padrão a 830 m (91,7 kPa) com 25 °C e 50% de umidade [ISO, 1975; HOERNER, 1965]; 0,009 N a 1,5 m/s |
| JGB37-520, 319 rpm | 18,8:1, 1,9 kgf.cm e 1,2 A travado | [RCDRONE, s.d.] |
| JGB37-520, 600 rpm | o mesmo motor com redução de 10:1, 1,1 kgf.cm e 1,2 A travado (motor de linha, à venda) | [RCDRONE, s.d.] |
| JGB37-520, 1000 rpm | o mesmo motor com redução de 6:1, 0,6 kgf.cm e 1,2 A travado | [RCDRONE, s.d.] |
| Bateria 3S | 12,0 a 12,5 V sem carga, 0,15 ohm com o BMS e os fios | estimativa |
| Dojô | madeira pintada de 77 cm, 2,5 cm de altura, faixa de 2,5 cm, Shikiri de 1 x 10 cm afastadas 10 cm | [ROBOCORE, s.d.a]; regulamento da CoRA 2026 |

A carga em cada apoio sai do equilíbrio de momentos com o peso, a aceleração e a força do contato, e o pneu sem peso não tem tração. O choque entre os corpos usa a força de Flores e coautores, k.d.(1 + 8(1 - e)/(5e) . d'/v0), com a penetração d, a taxa de penetração d' e a velocidade v0 do começo do choque: a força começa em zero, nunca puxa os robôs um para o outro e tira no choque a energia que o coeficiente de restituição e manda [FLORES et al., 2011]. O ar entra como arrasto no centro de massa de cada robô; na velocidade máxima ele fica abaixo de 0,1% do atrito do pneu, e a gravidade de Belo Horizonte é 0,26% menor que os 9,81 m/s² de antes. Quando a frente de um robô encosta na lateral ou na traseira do outro, a rampa de 17,7 graus transforma o empurrão em força vertical (1,46 vez a horizontal) até o pneu mais próximo do outro ficar sem peso. Com as duas frentes encostadas, entrar por baixo não dá vantagem a quem entra: a ponta da rampa do outro robô sobe e o peso dela passa para os pneus dele, que passam a tracionar mais, enquanto quem levanta carrega o peso tirado na própria ponta, que arrasta no dojô. Os VL53L0X lançam raios no cone de 25 graus contra as faces do outro robô: a face da frente inclinada devolve menos luz, os pneus pretos quase nada e as caixas de redução metálicas aparecem com qualquer cor de PLA [STMICROELECTRONICS, s.d.b]. Na sala à noite, só com a lâmpada de LED, quase não existe infravermelho de fundo, e as leituras falsas ficam na metade do modelo da bancada.

### Resultado

Na bateria de 180 lutas (3 estratégias, adversário preto e branco, 1000, 600 e 319 rpm, 10 largadas sorteadas cada, estratégia do adversário sorteada), com a física de Belo Horizonte e a geometria do chassi de dois andares (posições dos sensores do `config.h`, TE e TD a ±160° olhando para trás), o Grupo D venceu 59, perdeu 56 e empatou 65, sem nenhuma queda própria.

| Adversário | Vitórias | Derrotas | Empates |
|---|---|---|---|
| 1000 rpm | 41 | 10 | 9 |
| 600 rpm | 10 | 22 | 28 |
| 319 rpm, igual | 8 | 24 | 28 |

| Estratégia do Grupo D | Vitórias | Derrotas | Empates |
|---|---|---|---|
| Rush | 22 | 17 | 21 |
| Flank | 19 | 18 | 23 |
| Fan out | 18 | 21 | 21 |

| Largada do Grupo D | Vitórias | Derrotas | Empates |
|---|---|---|---|
| de frente para o adversário | 27 | 1 | 26 |
| de lado | 12 | 14 | 10 |
| de costas | 20 | 41 | 29 |

O motor de 1000 rpm tem um terço do torque: travado, ele empurra com uns 7,4 N (0,6 kgf.cm em cada roda de 16 mm de raio), abaixo dos 8,5 a 9,6 N que os pneus do Grupo D aguentam com 77% dos 980 g em cima deles (atrito de 1,15 parado e 1,30 escorregando). As vitórias contra ele levam 4,5 s, em média. O motor de 600 rpm, de linha e à venda, empurra com 13,5 N travado (1,1 kgf.cm), acima do limite de tração do pneu: ele esbarra no mesmo limite do de 319 rpm e só chega mais rápido, então o resultado fica perto do robô igual. Contra os dois, os robôs encostam 0,6 s depois dos 5 s parados e ficam empurrando de frente até o fim dos 90 s. As derrotas vêm da largada de costas, em que o robô gasta o começo da luta girando e recebe o adversário na traseira, que é o ponto fraco (41 das 56 derrotas); entre as estratégias a diferença é pequena (17 derrotas do Rush, 18 do Flank e 21 do Fan out) e a bateria não mostra o motivo. O motor mais quente chegou a 21,6 K acima do ambiente no modelo térmico do firmware, longe do limite de 60 K.

O atrito do pneu e a restituição do choque são as estimativas com mais incerteza, então a mesma bateria rodou com cada um mudado. A tabela é da rodada anterior à troca do chassi (240 lutas cada, 20 largadas, só 1000 e 319 rpm); com o chassi novo e o atrito 20% menor, as 180 lutas deram 65 vitórias, 53 derrotas e 62 empates (contra o de 1000 rpm, 44 vitórias, 16 derrotas e nenhum empate), e o empurrão de 1000 rpm levou uns 13 s:

| Física | Contra o de 1000 rpm | Tempo da vitória | Contra o de 319 rpm |
|---|---|---|---|
| atrito 1,15 e 1,30, restituição 0,4 (padrão) | 101 V, 18 D, 1 E | 2,2 s | 11 V, 16 D, 93 E |
| atrito 20% menor (pó no dojô) | 93 V, 25 D, 2 E | 20,0 s | 13 V, 13 D, 94 E |
| atrito 20% maior | 95 V, 20 D, 5 E | 2,0 s | 7 V, 14 D, 99 E |
| restituição 0,2 | 101 V, 18 D, 1 E | 2,3 s | 12 V, 18 D, 90 E |
| restituição 0,6 | 100 V, 19 D, 1 E | 2,2 s | 10 V, 16 D, 94 E |
| física antiga (9,81 m/s², sem ar, atrito 1,10, mola amortecida) | 99 V, 19 D, 2 E | 13,5 s | 10 V, 12 D, 98 E |

O resultado contra o robô igual quase não muda com a física: os dois têm o mesmo pneu e o mesmo limite de tração. Contra o de 1000 rpm, o atrito decide o tempo do empurrão: com pó no dojô, a sobra de tração cai e o empurrão leva uns 13 s.

Com as rodas atrás e o centro de massa 26,9 mm à frente do eixo, 23% do peso fica na ponta da rampa, que arrasta no dojô e não traciona; com o centro de massa sobre o eixo, esse peso iria para os pneus e o empurrão máximo subiria uns 30%. A rampa do outro robô que entra por baixo da frente levanta só a ponta: o peso dela passa para os pneus de quem foi levantado, e por isso encaixar a lâmina por baixo da lâmina do adversário, entre robôs de mesmo torque, ajuda o adversário a empurrar e não ajuda quem encaixou. A lateral e a traseira são os pontos fracos: ali a rampa do outro tira o peso do pneu mais próximo. O par de sensores de borda "de trás" fica 54 mm à frente do eixo, então, andando de ré, a roda chega à borda antes do sensor.

No computador:

```
bash teste/combate/compila.sh
python teste/combate/bateria.py teste/combate/combate --sementes 30 --csv combate.csv   # --motores 1000,600,319 por padrão
teste/combate/combate -s 7 -a rush -c preto -m 1000 -v      # uma luta, com o Log dos dois firmwares
python teste/combate/varre.py NOME --def K_ATAQUE=2.0f --base COPIA --n 1000 --tempo 20 --estrategias rush   # varredura (ver Otimização do ataque)
pip install ziglang==0.14.0
ZIG="python -m ziglang" bash teste/combate/compila.sh wasm  # módulo da página
python teste/combate/bateria.py teste/combate/combate --sementes 10 --json doc/combate/bateria.json
python ferramentas/gera_combate.py --wasm teste/combate/combate.wasm  # refaz site/combate.html
```

A página do combate fica no repositório (`site/combate.html`), como o painel: depois de mudar o firmware, o simulador ou a página, rode as três últimas linhas e faça o commit da página e do `doc/combate/bateria.json`. O CI compila o WebAssembly de novo e falha se a página versionada for diferente da gerada. O `--fragmento` gera a mesma página sem o `<head>`, para publicar como artefato.

A física à mão deixa de fora a rampa entrando fundo embaixo do outro robô (o ponto de apoio não anda), o tombamento, a deformação do pneu, a poeira no dojô e o feixe do VL53L0X batendo no chão. O atrito real do pneu e o centro de massa medido na balança (robô apoiado numa régua, até equilibrar) deixam o resultado mais perto da luta de verdade. A seção seguinte traz a segunda física, que resolve em 3D o encaixe da rampa e o tombamento, mas continua dependendo dos mesmos números estimados.

### Otimização do ataque com os motores de 319 rpm

Com os motores mantidos, o que o firmware ainda pode mudar é a estratégia, a colocação do robô na largada e o ganho de alguns parâmetros. O `teste/combate/varre.py` compara uma variante do firmware (o Grupo D) com o firmware atual congelado numa cópia (`FW_B` no `compila.sh`, que compila o adversário do diretório da cópia), nas mesmas lutas sorteadas: cada luta sorteia a estratégia do Grupo D, a cor e o motor do adversário (319, 600 e 1000 rpm), a estratégia e o rumo de largada dele. As lutas da varredura duram 20 s, porque nas 210 vitórias da bateria de referência todas saíram em até 5,7 s depois da contagem (mediana de 1,4 s) e o que passa disso é um impasse de empurrão; as comparações finais usam 90 s. O resultado de cada variante vem com o placar pareado (lutas em que melhorou e em que piorou), porque a diferença entre ajustes é de 1% a 2% e o erro padrão de 1000 lutas é de 1,5%.

```
python teste/combate/varre.py NOME --def K_ATAQUE=2.0f --base COPIA_DO_FIRMWARE --n 1000 --tempo 20 --estrategias rush --largada frente --contra REFERENCIA
```

**A colocação decide mais que qualquer parâmetro.** O regulamento deixa livre o rumo do robô atrás da linha Shikiri. Com 400 lutas sorteadas de 90 s, o Rush largando de frente para o adversário fez 119 vitórias, 0 derrotas e 42 empates (161 lutas); com o rumo sorteado entre frente, lados e costas, 74, 38 e 49. O Flank de frente perdeu 28 de 125 lutas e o Fan out ganhou 52 de 114 sem perder, então a escolha é o Rush (chave DIP toda desligada) e o robô vai sempre de frente. Largando de lado, a esquerda rende bem menos que a direita (Rush, 300 lutas de 20 s: 87 vitórias e 95 derrotas contra 138 e 36): os ToF laterais só leem até 80 mm, o robô só encontra o oponente girando, e o sentido que a busca escolhe favorece a largada virada para a direita: o primeiro contato sai em 0,86 s (mediana) contra 0,61 s. Dar alcance inteiro aos laterais e ao par de trás subiria o saldo de +21% para +51% nas largadas livres, mas com pessoas a 5 a 40 cm da borda o ganho some (362 vitórias com o limite atual, 335 com 600 mm e 342 com 300 mm), então `TOF_ALCANCE_LATERAL_MM` e `TOF_ALCANCE_TRAS_MM` ficam como estão. Colocar o robô torto não custa: com o desvio do rumo sorteado em torno de 8° ou de 15° (no lugar de 1,7°), o Rush de frente fez 555 e 532 vitórias em 800 lutas, contra 704 em 1000 no padrão.

**Parâmetros.** Rush de frente, 1000 lutas de 20 s, referência com 704 vitórias, 1 derrota e 295 empates:

| Variante | Vitórias | Derrotas | Pareado (melhorou / piorou) |
|---|---|---|---|
| velocidade de ataque em 85% da máxima | 688 | 1 | 5 / 21 |
| velocidade de ataque em 70% da máxima | 628 | 1 | 9 / 85 |
| `K_MIRA` 4 / 9 | 697 / 681 | 5 / 1 | 16 / 24 e 7 / 30 |
| `CENTRO_DEG` 4 / 12 | 704 / 703 | 1 / 1 | 2 / 2 e 1 / 2 |
| `ANG_MIRA_CURVA` 25 / 60 | 704 / 704 | 1 / 1 | sem diferença |
| `GIRO_MIRA_MAX_DPS` 300 / 415 | 705 / 704 | 1 / 1 | 1 / 0 e 0 / 0 |
| `APROX_RAPIDA_MMS` 200 / 450 | 704 / 704 | 1 / 1 | sem diferença |
| `ACEL_MAX_MMS2` 4000 / 9000 | 709 / 709 | 1 / 1 | 11 / 6 e 7 / 2 |
| mira do ataque deslocada de +8° / -8° do centro do oponente (K_ATAQUE 3) | 713 / 708 | 2 / 1 | 13 / 4 e 10 / 6 |
| **ganho de giro só no ataque (`K_ATAQUE`)** 10 / 4 / 3 / 2 / 1,5 / 1 / 0 (com `K_MIRA` 6 na mira) | 684 / 708 / 715 / 715 / 712 / 719 / 721 | 1 / 1 / 1 / 1 / 5 / 2 / 3 | 3 / 23, 6 / 2, 14 / 3, 14 / 3, 13 / 7, 18 / 3 e 22 / 5 |

A velocidade máxima de ataque é a melhor (85% dela tira 16 vitórias e 70% tira 76: quem chega primeiro bate antes de o oponente virar). A aceleração maior piora as outras largadas (800 lutas com o rumo livre: 177 derrotas contra 163 com `ACEL_MAX_MMS2` 9000 e `K_ATAQUE` 2), então fica em 6000. A mira não muda com ângulos e limites, porque de frente o oponente quase sempre já está no cone do sensor central. O único ajuste que ganha de forma consistente é o giro de correção menor no ataque: com o oponente centrado, o giro pedido tira avanço das rodas (a cinemática dá prioridade ao giro), e com `K_MIRA` 6 o ataque a 10° de erro sai uns 14% abaixo da velocidade máxima. O `K_ATAQUE` ficou em 2 (a mira continua com `K_MIRA` 6; com 0 o robô não corrige nada e perdeu 3 lutas).

Condições de robustez, Rush de frente, referência contra `K_ATAQUE` 2:

| Condição | Lutas | Referência (V / D) | `K_ATAQUE` 2 (V / D) | Pareado |
|---|---|---|---|---|
| padrão | 1000 | 704 / 1 | 715 / 1 | 14 / 3 |
| rumo desalinhado, desvio de 8° | 800 | 555 / 7 | 558 / 7 | 8 / 5 |
| rumo desalinhado, desvio de 15° | 800 | 532 / 12 | 543 / 12 | 14 / 3 |
| atrito 20% menor (pó) | 800 | 519 / 2 | 528 / 5 | 16 / 7 |
| atrito 20% maior | 800 | 572 / 1 | 593 / 1 | 26 / 5 |
| 90 s, sementes novas | 600 | 418 / 0 | 424 / 1 | 7 / 1 |

O ganho é de 1% a 2%, no limite do que a simulação resolve, e as vitórias ficam uns 6% mais rápidas (contra o de 1000 rpm, 2,65 s para 2,49 s na bateria de 180 lutas), o que ajuda no critério de menor tempo nas partidas vencidas. O placar da bateria padrão de 180 lutas não mudou (59 vitórias, 56 derrotas e 65 empates), porque ela sorteia só 10 cenários e nenhum deles trocou de resultado.

**O que não sai por ajuste.** Dos 295 empates de 1000 lutas, 283 são contra os motores de 319 e 600 rpm: é o impasse com o oponente de força igual. Com os dois robôs largando de frente um para o outro, os 24 casos da bateria de 180 lutas contra esses motores terminam empatados, com os robôs quase parados, porque os dois empurram com a tração toda e a força líquida é zero. As cinco manobras de saída do empurrão travado, o desvio da mira e a velocidade de ataque não quebram esse impasse (seção Travamento). O regulamento da CoRA desempata o round parado ou orbitando por 5 s com um round extra e, se todos os rounds empatarem, dá a vitória ao robô de menor peso aferido na balança: cada grama a menos conta, e o Grupo D está em 980 g. Os adversários da simulação rodam o mesmo firmware, e os da competição vão se comportar de outro jeito; os números valem como comparação entre variantes, e o dojô de verdade é quem confirma.

### Física do MuJoCo

A física do `fisica.cpp` é escrita à mão: cada robô apoia em três pontos e a rampa do outro só tira peso de um deles. O MuJoCo [TODOROV; EREZ; TASSA, 2012] é um motor de física de código aberto que resolve o contato em 3D entre corpos rígidos, e entra como segunda física do mesmo simulador, escolhida pela opção `-F mujoco`. O firmware dos dois robôs, o Arduino de mentira, os sensores (ToF e TCRT5000) e a regra de quem saiu do dojô são os mesmos; muda só quem calcula como os corpos se movem e se tocam. A física à mão continua como padrão, porque roda no CI sem nenhuma dependência, vai para o WebAssembly da página 3D e é mais rápida. O MuJoCo é a ferramenta de validação: a mesma bateria nas duas físicas mostra o que o modelo à mão não enxerga.

```
pip install mujoco==3.16.0
MUJOCO=1 bash teste/combate/compila.sh nativo teste/combate/combate_mj
teste/combate/combate_mj -s 7 -a rush -c preto -m 319 -F mujoco -v           # uma luta
python teste/combate/bateria.py teste/combate/combate_mj --sementes 10 --extra "-F mujoco" --json mj.json
MUJOCO=1 bash teste/combate/compila.sh empurrao                              # só a física, sem firmware
python teste/combate/compara_fisicas.py teste/combate/empurrao --lutas 100   # empurrão nas duas físicas
python teste/combate/mujoco/prepara_malhas.py PASTA_DO_CHASSI teste/combate/mujoco/malhas   # refaz as malhas do STEP
```

| Item | Física à mão | MuJoCo |
|---|---|---|
| Corpo | três apoios (dois pneus e a ponta), carga por equilíbrio de momentos, inclinação só no desenho | corpo rígido de seis graus de liberdade, com as malhas do STEP (base, duas peças da rampa, tampa e duas laterais, cada uma em casca convexa), 980 g, centro de massa 26,9 mm à frente do eixo e 24 mm acima do chão |
| Pneu | curva de Stribeck, 1,15 parado e 1,30 escorregando | cilindro de 32 x 20,2 mm, com um atrito só (o MuJoCo tem um valor por par): a média, 1,225 |
| Ponta da rampa | altura sorteada de 0,1 a 0,6 mm, atrito de 0,35 | a do STEP: a base fica 3 mm acima do dojô e a ponta toca o chão quando o nariz desce uns 1,5°; atrito de 0,35 |
| Choque entre os robôs | força de Flores, restituição 0,4, atrito de 0,30 | contato do MuJoCo (solref de 4 ms, solimp de 0,95 a 0,99), atrito de 0,30 entre os PLA |
| Motor, bateria e ponte H | `forcasRobo` | as mesmas contas (tensão do PWM, força contraeletromotriz, queda da bateria e da ponte H, atrito do rotor), com o torque aplicado nas rodas; inércia do eixo na armadura da junta |
| Passo | 0,125 ms | 0,5 ms (o firmware roda a cada 1 ms) |
| Saída do dojô | roda, centro de massa ou ponta com a quina atrás do centro de massa | roda ou centro de massa fora do círculo de 77 cm, ou corpo 2 cm abaixo do dojô |
| Sensores | `tofMede` e `bordaMv` na pose do Robo | os mesmos, com a pose lida do MuJoCo (posição do eixo e rumo) |

O MuJoCo desempata contatos pela ordem e pela posição dos corpos. Na primeira versão, dois robôs idênticos (319 rpm contra 319 rpm) davam 84 a 16 para o que largava em +x. Agora cada luta gira a cena inteira de um ângulo sorteado (o dojô é redondo) e sorteia qual robô entra primeiro no modelo, voltando ao referencial do mundo na saída; com isso os robôs iguais ficam perto de 50 a 50.

**Empurrão frente a frente** (`empurrao.cpp`, sem firmware, PWM em 100% nos dois, a 40 cm um do outro, com o desalinhamento de até 30 mm, o giro de até 3° e o lado de largada sorteados; 100 empurrões por linha, até 15 s):

| Física | Adversário | Decididos | Tempo médio | Grupo D (319 rpm) vence | Perde o robô levantado |
|---|---|---|---|---|---|
| à mão | 319 rpm | 0 de 100 | sem decisão | 0 | |
| à mão | 600 rpm | 0 de 100 | sem decisão | 0 | |
| à mão | 1000 rpm | 100 de 100 | 1,76 s | 100 | |
| MuJoCo | 319 rpm | 100 de 100 | 0,95 s | 46 | 99 de 100 |
| MuJoCo | 600 rpm | 100 de 100 | 0,90 s | 70 | 99 de 100 |
| MuJoCo | 1000 rpm | 100 de 100 | 0,92 s | 60 | 100 de 100 |

"Levantado" é o robô com a maior arfagem, quando as duas diferem em mais de 5°. Na física à mão, os robôs com o mesmo torque ou com um torque maior que o limite de tração ficam empurrando de frente até o fim: nada quebra a simetria. No MuJoCo a rampa de um robô entra por baixo da do outro, levanta o nariz do outro até uns 12° e o resultado sai em menos de 1 s. O robô que fica levantado perde quase sempre (a explicação em detalhe, com a força em cada pneu, ainda não foi extraída do MuJoCo). Isso vale também quando a altura da ponta muda: com a ponta a 3 mm (STEP), a 1,5 mm e a 0,3 mm, o robô levantado perdeu 59, 60 e 52 de 60 empurrões contra o de 319 rpm (variável de ambiente `CB_PONTA_MM`); com a ponta encostada no chão (0 mm) o levantamento quase não acontece e o empurrão ainda é decidido, em 1,5 s. O resultado não mudou com o atrito do pneu de 1,0 a 1,5, o atrito do PLA de 0,2 a 0,45, a altura do centro de massa de 14 a 34 mm, a rigidez do contato nem o passo de 0,25 ms (varredura de 60 empurrões contra os motores de 319 e 600 rpm, feita na primeira versão do teste, em Python).

**Bateria de combate com o firmware** (180 lutas, 3 estratégias, preto e branco, 1000, 600 e 319 rpm, 10 largadas, mesmo sorteio da bateria à mão):

| Física | Vitórias | Derrotas | Empates | Quedas próprias | Tempo médio da vitória |
|---|---|---|---|---|---|
| à mão | 59 | 56 | 65 | 0 | 3,8 s |
| MuJoCo | 94 | 86 | 0 | 0 | 1,9 s |

A linha do MuJoCo é da rodada anterior à troca do chassi (a linha da física à mão já é a do chassi de dois andares); a física dos dois ainda usa as medidas de massa e de apoio do STEP anterior (o STEP final, dividido em `cad/`, ainda não entrou), e o MuJoCo precisa rodar de novo com as do chassi novo.

Por adversário, no MuJoCo: 32 vitórias e 28 derrotas contra o de 319 rpm, 27 e 33 contra o de 600 rpm, 35 e 25 contra o de 1000 rpm; por largada: de frente 38 e 16, de lado 21 e 15, de costas 35 e 55; por estratégia: Rush 34 e 26, Flank 33 e 27, Fan out 27 e 33. Não há empate, porque todas as lutas se decidem em uns 2 s, a mais longa em 16 s. A física à mão deixa 58 das 180 lutas empatadas por tempo, quase todas contra os motores de 319 e 600 rpm. Nas duas, o robô do Grupo D nunca saiu do dojô sozinho.

O que isso mostra e o que não mostra:

- O MuJoCo desfaz o empate e é robusto aos números que ele usa, mas prevê que **entrar por baixo da lâmina do outro ajuda quem entra**, e o dojô real mostrou o contrário (o de 319 rpm tirava o Grupo D com facilidade). A física à mão concorda com o dojô nesse ponto, mas só porque não tem como representar o encaixe. Então a divergência está aberta, e o que falta é medida: o atrito do pneu na madeira (dinamômetro com as rodas travadas), a altura real da ponta da rampa impressa, o centro de massa pesado (robô apoiado numa régua) e um vídeo de luta no dojô com os dois robôs.
- O teste do empurrão é em malha aberta, sem firmware, e o MuJoCo guarda um único atrito por par de superfícies, sem a curva de Stribeck.
- As malhas são cascas convexas: janelas, rasgos e o suporte dos sensores não entram, e o motor e a caixa de redução ficam como massa no centro de massa, sem forma.
- O CI roda o empurrão (40 por motor) e uma bateria pequena com o MuJoCo, só para o código não quebrar; os números de cima valem para esta versão e mudam se os parâmetros estimados mudarem.

## Montagem 3D

A página [Montagem Grupo D](https://felcoslop.github.io/LAB_III_Grupo_D_UFMG_2026_2/montagem.html) mostra o robô montado em 3D no chassi de dois andares do editor 3D v11, com cada componente no lugar e cada fio do esquema elétrico, e marca a ponta de cada jumper: fêmea nos pinos machos dos módulos e da extensora, soldado nas duas emendas do barramento de I2C. O chassi é o do grupo (base, rampa da frente, laterais, hastes, tampas, suportes dos motores, prateleira, calço em V e suportes de 160°, com os STL em `doc/montagem/modelos/chassi/`), e os componentes são os do editor (ESP32 e extensora, ponte H, BMS, células, TPS63070, chave DIP, chave KCD1, botão, TCRT5000 e os sete VL53L0X em seus suportes). Embaixo ficam a ponte H, os motorredutores, os TCRT5000 e os sensores; na prateleira, a extensora do ESP32 e o ESP32; por cima da tampa de trás, a célula da lógica, o TPS63070, a chave DIP (furo A), o botão de início (furo B) e a chave liga e desliga (furo C); por cima da tampa da frente, as três células da bateria 3S, e o BMS. Não há protoboard. A página vem de quatro arquivos:

- o `config.h`, que dá o GPIO de cada fio e a tabela de posições `TOF` e `BORDA`, que o gerador confere contra a posição e o ângulo de cada sensor no editor (com 2 mm e 1 grau de tolerância; se discordarem, a geração para e mostra a diferença);
- o `doc/montagem/montagem.json`, com as peças, os pinos de cada modelo, as duas emendas do I2C, os passa-fios propostos, o contorno do chassi e as diferenças do esquema;
- o `doc/montagem/pecas.js` e o `doc/montagem/editor.json`, que o `exporta_pecas.py` gera a partir do HTML do editor (malhas com a cor de cada peça e a matriz de cada peça repetida);
- o `doc/montagem/rotas_fios.json`, que o `roteia_fios.py` gera: o caminho de cada fio no volume das peças, com folga de 1,5 mm.

Não há protoboard. O SDA e o SCL dos sete VL53L0X se juntam em duas emendas soldadas, com termorretrátil, no vão atrás da fileira de trás da extensora, e um jumper curto leva cada emenda ao pino S do GPIO 21 ou 22. Todo o resto vai nos trios S, V e G da extensora, um trio por GPIO, e a ponte H, o botão e a chave DIP ligam direto nela ou no ESP32. As ligações seguem o firmware e o documento de ligação (Lab3-Liga):

| Ligação | Jumper | Pontas |
|---|---|---|
| XSHUT, VIN e GND de cada VL53L0X | fêmea-fêmea | pino do sensor e trio S, V e G do GPIO 17, 23, 19, 18, 5, 16 ou 4 |
| A0, VCC e GND de cada TCRT5000 | fêmea-fêmea | pino do módulo e trio S, V e G do GPIO 34, 35, 32 ou 33 (o D0 fica sem fio; com o fio no D0 o sinal é digital e o trimpot azul decide a borda, ver Calibração da pista) |
| SDA e SCL de cada VL53L0X | jumper cortado ao meio, soldado | fêmea no pino do sensor e ponta soldada na emenda do SDA ou do SCL |
| Emenda do SDA e do SCL até o ESP32 | jumper curto, soldado | ponta soldada na emenda e fêmea no pino S do GPIO 21 ou 22 |
| GND, IN1, IN2, IN3 e IN4 da ponte H | fêmea-fêmea | pino da ponte, pino G do GND e pino S do GPIO 25, 26, 27 e 13 |
| Chave DIP | fio soldado com ponta fêmea | quatro pernas do lado A unidas por fio nu e um fio para o pino V; cada perna do lado B no pino S do GPIO 12, 14, 2 e 15 |
| Botão de início | fio soldado | as duas pernas do botão nas do BOOT do DevKit (GPIO 0 e GND) |
| Motores, bateria 3S, BMS e alimentação da ponte H | fio 22 AWG soldado | bornes da ponte H e terminais soldados |
| Bateria 18650 da lógica, chave KCD1 e TPS63070 | fio soldado | o 3,3 V e o GND do TPS63070 vão com ponta fêmea nos pinos V e G da extensora |

São 38 jumpers fêmea-fêmea e 23 fios soldados com ponta fêmea (16 das duas emendas do I2C, 7 da DIP e do TPS63070), mais 17 fios soldados nos bornes e terminais, e a página soma o comprimento de cada caminho para a lista de compra. O start continua no botão BOOT (GPIO 0): o DevKit de 30 pinos não leva o GPIO 0 para a barra, então o botão de início é soldado em paralelo com o BOOT.

O esquema do Fritzing (`SUMO_Esquemático` e `SUMO_bb`) difere do firmware em cinco pontos, e a página mostra os cinco: os sensores de borda saem do D0 nos GPIO 36, 39, 34 e 35, mas o firmware lê o A0 nos 34, 35, 32 e 33; a chave DIP vai nos GPIO 15, 14, 33 e 32 com o comum no GND, mas o firmware lê os 12, 14, 2 e 15 com o pull-down interno e o comum no 3V3 (com o comum no GND a chave nunca muda a leitura); o botão S1 vai no GPIO 2, que é a via 3 da chave; a ponte H aparece como L298N; e o ESP32 vai na extensora, não numa protoboard. O ramo dos motores não tem chave liga e desliga no esquema.

O STEP final do projeto mecânico (`LAB3-Modelagem_2.step`) está dividido em um STL por objeto da árvore do CAD em [`cad/`](cad/README.md), feito pelo `ferramentas/step_por_objeto.py`: as 17 peças para impressão, com os sete suportes de sensor SS_*, e os componentes de referência (rodas com motor, quatro módulos TCRT5000, extensora e ESP32). Ele ainda não alimenta o `config.h` nem esta página, que seguem o chassi do editor 3D v11. Medido nos STL, o CAD final põe o TE e o TD juntos no centro da traseira (y de cerca de ±10 mm, e não ±66 mm), os dois TCRT5000 da frente a 71,4 mm do eixo (e não 96 mm) e as placas dos sete suportes na vertical, e o conjunto tem 149 mm de largura (151 mm no editor v11). A tabela completa está em `cad/README.md`.

O `doc/montagem/README.md` traz o espaço que sobra e o que falta no chassi, com as medidas. Quatro pontos pedem decisão do projeto mecânico: os três VL53L0X da frente apontam uns 27° para cima (a borda de baixo do cone passa a 49 mm de altura a 100 mm de distância), os conectores dos pinos de trás da extensora batem na cunha de apoio da tampa da frente, os fios entre os andares precisam de passa-fios (a página propõe um na tampa da frente), e a largura de 151 mm deixa só 1 mm de folga até o gabarito de 152 mm.

Com um editor 3D novo:

```
python ferramentas/exporta_pecas.py robo_3d_editor.html       # refaz o doc/montagem/pecas.js e o editor.json
python ferramentas/gera_montagem.py                            # confere o config.h contra o editor e refaz a página
python ferramentas/roteia_fios.py                              # refaz o caminho dos fios
python ferramentas/gera_montagem.py --interferencias           # refaz a lista de interferências
```

O `exporta_pecas.py`, o `roteia_fios.py` e a conferência de interferências precisam de `pip install trimesh fast-simplification networkx scipy scikit-image`; o resto do `gera_montagem.py` usa só o Python, com as contas em float do próprio Python, então a página sai igual em qualquer computador.

## Instalação

### Requisitos

| Item | Versão | Observação |
|---|---|---|
| Arduino IDE | 1.8.x ou 2.x | |
| Core ESP32 da Espressif | 2.x ou 3.x | Gerenciador de Placas, pacote "esp32 by Espressif Systems" |
| Biblioteca VL53L0X da Pololu | 1.3.1 | Gerenciador de Bibliotecas |
| Python 3 | 3.x | necessário só para gerar de novo o painel, as páginas e os PDFs |

O firmware usa o core do ESP32 [ESPRESSIF SYSTEMS, s.d.a] e a biblioteca VL53L0X da Pololu [POLOLU, s.d.]. As bibliotecas Preferences e Wire já vêm com o core.

### Passo a passo

1. Download do repositório (botão Code e depois Download ZIP, ou `git clone https://github.com/felcoslop/LAB_III_Grupo_D_UFMG_2026_2`) e extração em qualquer pasta. O firmware fica em `firmware/sumo_esp32/`, uma pasta com o mesmo nome do arquivo `.ino`, como a Arduino IDE exige; o nome da pasta de fora não faz diferença.
2. Abertura do `firmware/sumo_esp32/sumo_esp32.ino` na IDE. Os outros arquivos `.h` e `.cpp` da mesma pasta aparecem como abas.
3. Ajustes no menu Ferramentas, conforme a tabela abaixo.
4. Compilação e gravação pela USB, com o botão Carregar.
5. Monitor Serial em 115200 baud, com a opção "Nova linha".

| Opção em Ferramentas | Valor |
|---|---|
| Placa | ESP32 Dev Module |
| Partition Scheme | padrão (o firmware cabe com folga) |
| Porta | porta COM do ESP32 |

## Uso

### Primeiro teste pela USB

No boot, o terminal mostra a lista de comandos e a tabela de sensores. O comando `lista` deve mostrar todos os ToF como OK; com menos de três, o robô não inicia e o LED azul pisca rápido. O comando `scan` deve encontrar os endereços de 0x30 a 0x34 (até 0x36 com 7 sensores), e um endereço 0x29 indica um sensor sem o fio XSHUT. No modo `id`, a mão cobrindo um sensor por vez faz o terminal escrever o nome dele, o que ajuda a conferir as etiquetas e a cor de cada fio.

### Comandos

Os comandos funcionam no Monitor Serial e no terminal do painel.

| Comando | Descrição |
|---|---|
| `help` ou `?` | lista de comandos |
| `lista` | sensores configurados, calibração e status |
| `id` | modo de identificação: o nome do sensor coberto aparece no terminal |
| `ver` | leitura contínua de sensores, oponente, borda, rumo, estado e motores |
| `scan` | endereços I2C presentes no barramento |
| `cal NOME [P1 P2]` | calibração de 2 pontos do ToF (padrão 50 e 300 mm), gravada no ESP32 |
| `calver` | ganho e offset de cada ToF |
| `calzera NOME` ou `calzera todos` | remoção da calibração gravada |
| `medir NOME MM` | conferência da calibração: média, ruído e erro com o alvo a MM milímetros |
| `borda` | leitura contínua dos sensores de borda (mV e limiar) |
| `calborda` | diagnóstico e calibração da borda em três medidas |
| `bordazera` | remoção da calibração da borda |
| `calpista on` ou `off` | janelas de mínimo, máximo e média de cada sensor de borda (linha `J`) para a calibração da pista do painel; desliga sozinho ao sair da ESPERA |
| `bordalim NOME LIM [PRETO BRANCO]` | grava o limiar da borda (50 a 3300 mV) de um sensor (BFE, BFD, BTE ou BTD), calculado pelo painel; PRETO e BRANCO são os valores típicos |
| `init` | nova tentativa nos ToF que falharam, com o robô parado |
| `tempo` | duração do ciclo do loop, tempo do rastreador e linhas descartadas na USB (e no WiFi, com `USAR_WIFI 1`) |
| `cin` | números do modelo das rodas: velocidade e giro máximos, feed-forward e distância de parada |
| `mov V W MS [F]` | teste com o robô parado: avanço V mm/s e giro W graus/s por MS ms (até 3000), com a estimativa no fim. F opcional: 1 ignora a linha (o teste não para ao ver a borda), 2 não escreve as linhas `# mov` no terminal, 3 os dois (usado pelo controle WASD do painel) |
| `pwm E D MS [F]` | teste dos fios: PWM direto de E% na roda esquerda e D% na direita (-100 a 100) por MS ms; F como no `mov` |
| `alinha on [S]`, `alinha off` | demonstração: com o robô em ESPERA, gira no lugar, em pulsos, até o oponente da frente ficar a menos de `ALINHA_TOL_DEG` da frente, sem andar, sem buscar às cegas, no máximo `ALINHA_GIRO_MAX_DEG` para cada lado e sem olhar a linha; S segundos (padrão 60, máximo 600); `alinha` sozinho mostra o estado |
| `ajuste`, `ajuste NOME VALOR`, `ajuste padrao` | opções do robô gravadas na memória (NVS), só com o robô em ESPERA: `auto`, `linha`, `alinha`, `wifi` e `leve` aceitam 0 ou 1 e `tof` aceita 5 ou 7 (o robô reinicia em 1 s); `padrao` volta ao valor de fábrica; sem argumento mostra os valores. Veja [Opções do robô](#opções-do-robô-gravadas-pelo-painel) |
| `estrategia rush`, `flank`, `fan` ou `chave` | estratégia escolhida pelo terminal; `chave` volta a seguir a DIP |
| `perfil claro`, `escuro` ou `chave` | perfil do oponente pelo terminal; `chave` volta a seguir a DIP 4 |
| `arena` | localização no dojô: centro estimado, incerteza, espaço livre em 8 direções, leituras descartadas e tempo do filtro |
| `trava` ou `trava N` | manobra do empurrão travado (0 nenhuma, 1 lateral, 2 torque, 3 zigue, 4 giro, 5 pulso), sem gravar |
| `cin` | também mostra o aquecimento estimado dos motores e se o limite térmico está ligado |
| `go` e `stop` | início (contagem de 5 s) e parada da máquina de estados |
| `s1` e `s0` | stream de dados para o painel, ligado e desligado |
| `wifi` e `wifi off` | rede, endereço, painéis conectados e linhas descartadas; `wifi off` desliga o rádio na hora (com `USAR_WIFI 1`) |

### Painel pela USB ou pelo Wi-Fi

O arquivo `painel/painel_sumo.html` abre direto no Chrome ou no Edge do computador, sem internet, porque o three.js está embutido nele [THREE.JS, 2022]. Na barra do alto, a caixa de seleção escolhe o meio de conexão. Com "USB", o botão "Conectar" usa a Web Serial do navegador a 115200 baud; logo depois de abrir a porta, o painel envia `s1` e passa a receber os dados a 50 Hz. O Monitor Serial da IDE precisa estar fechado, porque só um programa por vez usa a porta. O botão "Modo demo" simula um oponente preto de 15,2 cm e roda em JavaScript o mesmo rastreador do firmware; o quadrado pode ser arrastado no radar 2D e, com a opção "robô se mexe", o robô simulado obedece à seta.

#### Wi-Fi

O painel funciona sem cabo quando o firmware é compilado com `USAR_WIFI 1` no `config.h`. O ESP32 cria a rede `SUMO-ROBO` (senha `sumo1234`, canais e nomes no `config.h`), o computador entra nela, o painel é aberto do disco (`painel_sumo.html`) e, na barra do alto, a seleção "Wi-Fi" mostra o campo do endereço, que já vem com `192.168.4.1`. O botão "Conectar" confere o robô em `/ping`, abre o fluxo `/stream` (Server-Sent Events, o mesmo protocolo de linhas da USB) e envia `s1`; os comandos digitados, as setas de controle e os botões saem por `/cmd?c=comando`, um por vez e na ordem, e um `mov` ou `pwm` que ainda não saiu é trocado pelo mais novo. Se o ESP32 reiniciar ou o sinal cair, o navegador reconecta sozinho e o painel pede o cabeçalho de novo. O firmware atende no máximo dois painéis ao mesmo tempo, não bloqueia o loop quando a rede engasga (a linha de dados é descartada, e o comando `tempo` conta quantas) e entrega inteiras as linhas de texto, como o resultado de um comando. Se o `config.h` tiver `WIFI_STA_SSID` preenchido, o ESP32 tenta entrar nesse roteador por até 8 s antes de criar a rede própria, e o endereço passa a ser o IP que o terminal mostra (ou `sumo.local`).

Detalhes que importam no uso:

- O painel precisa estar aberto do disco ou por `http`. Aberto por `https` (o GitHub Pages, por exemplo), o navegador bloqueia a conexão com o robô, que só fala `http`, e o painel avisa.
- Conforme a versão, o Chrome pergunta se a página pode acessar dispositivos da rede local; é preciso permitir.
- Com o computador na rede do robô não há internet; o painel não precisa dela.
- O custo do rádio é a pilha do WiFi disputando o núcleo 0 com o rastreador (foi o motivo de o WiFi ter sido removido uma vez). Com `USAR_WIFI 0` o código do rádio nem é compilado, então o firmware de competição fica igual ao que não tem WiFi. Para medir no robô, rode `tempo` com `USAR_WIFI 0` e depois com `USAR_WIFI 1` e compare o pior ciclo e o passo do rastreador.
- **Wi-Fi leve** (opção do painel, `ajuste leve 0|1`, de fábrica ligada): a telemetria completa leva uns 13 KB/s pelo rádio (`D`, `Q` e `A` a 50 Hz, mais o mapa `M` a 4 Hz) e disputa os buffers do lwIP e o ar com cada comando do `/cmd`; em teste no robô, o controle remoto e os ajustes ficaram lentos. No modo leve, só o rádio muda (a USB segue completa): a linha `D` (as leituras de todos os sensores) sai a cada 100 ms (`WIFI_LEVE_D_MS`), a `Q` e a `A` a cada 250 ms (`WIFI_LEVE_QA_MS`) e o mapa de probabilidade `M` a cada 500 ms (`WIFI_LEVE_M_MS`, 2 por segundo; 0 tira o mapa), o que dá uns 2 KB/s sem o mapa e uns 3,6 KB/s com ele. O mapa é uma linha de dados, então é descartada antes de qualquer comando quando a rede enche. Os textos, as linhas do cabeçalho, a `Z` do alinhamento e a `J` da calibração da pista passam como antes (a `J` só existe enquanto o assistente roda). O painel mostra "Wi-Fi leve · 10 Hz", sem a conta de perdas, e o radar e a vista 3D seguem com os cones de todos os sensores a 10 Hz e a mancha laranja do mapa a 2 Hz; para tudo a 50 Hz (mapa a 4 Hz), escolha "Completa" no cartão Opções do robô ou use a USB.
- O ponto de acesso trabalha com canal de 20 MHz (`esp_wifi_set_bandwidth` em HT20), que é mais estável que os 40 MHz numa sala cheia de redes de 2,4 GHz. Se mesmo assim o rádio engasgar, troque `WIFI_AP_CANAL` (1, 6 ou 11, o que estiver menos ocupado na sala), afaste a antena do ESP32 (a ponta da placa) de metal e de baterias e meça com o comando `wifi`, que mostra as linhas descartadas, e com o `tempo`.
- A linha `A` (a 50 Hz) agora conta como dado: antes, com a rede cheia ela era guardada como se fosse texto importante e travava o resto do stream; hoje é descartada como a `D` e a `Q`.
- `WIFI_DESLIGA_SEM_PAINEL 1` (padrão) desliga o rádio sozinho quando a máquina de estados sai da ESPERA (início da luta) sem nenhum painel conectado, e também quando o último painel sai durante a luta. O comando `wifi off` desliga na hora; para ligar de novo é preciso reiniciar o ESP32.
- O `teste/unidade/teste_wifi.cpp` roda o `telemetria.cpp` de verdade sobre sockets reais no CI (`/ping`, `/cmd`, `/stream`, rede cheia, envio parcial, desligamento sem painel, Wi-Fi leve com D a 10 Hz, Q e A a 4 Hz e sem mapa, USB completa e canal de 20 MHz), e o `teste/painel/smoke_wifi.mjs` abre o painel versionado num Chromium sem tela contra um robô de mentira e confere a conexão, os quadros, os comandos em ordem e a reconexão.

| Oponente à vista (rumo ATACAR) | Arena vazia (rumo PROCURAR) |
|---|---|
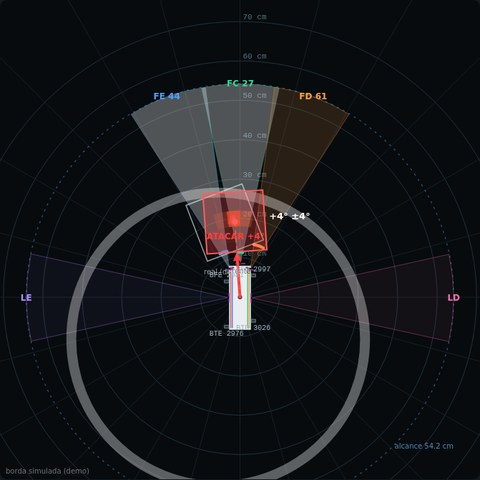
[picture p3: doc/img/radar_atacar.jpg]
Radar 2D com o oponente à frente e a seta vermelha de ataque
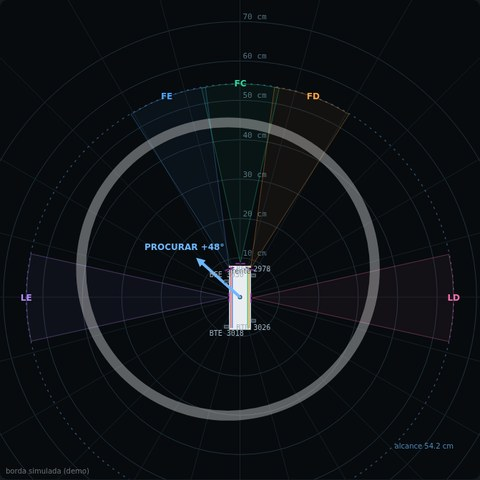
[picture p4: doc/img/radar_procurar.jpg]
Radar 2D sem oponente e a seta azul de busca apontando para o ponto cego
|  |  |

No radar, cada cone colorido é um sensor, a mancha laranja é o mapa de probabilidade do rastreador, o quadrado vermelho é o oponente na posição estimada e a seta é o rumo entregue para a máquina de estados. O comprimento do cone é o alcance daquele sensor, com os limites lateral e de trás que o firmware manda na linha `X`. O círculo cinza é a borda simulada do dojô no modo demo.

### Calibração

A distância do VL53L0X tem um erro fixo de fábrica que a biblioteca não corrige, e nas placas clone esse erro fica entre +10 e +30 mm. O comando `cal FC` pede um alvo plano e fosco a 50 mm e depois a 300 mm da face do chip; o ganho e o offset calculados ficam gravados na memória não volátil do ESP32 e continuam valendo depois de desligar. O comando `medir FC 100` confere o erro que sobrou.

Os sensores de borda passam pelo `calborda`. A medida no ar revela reflexo indesejado, como o da lateral branca da protoboard, e as medidas no preto e no branco definem a polaridade e o limiar. O limiar fica a 35% do caminho entre o branco e o preto, mais perto do branco, para arranhão e poeira não dispararem a borda [DEDE, s.d.]. Sem calibração vale o limiar fixo de 600 mV, e o `lista` avisa quando isso acontece.

#### Calibração da pista (borda que "alucina")

O `calborda` mede só um ponto no preto e um no branco, então um arranhão claro no dojô, um reflexo ou uma faixa estreita demais ainda podem enganar o sensor. A calibração da pista, no painel (cartão "Calibração da pista", pela USB ou pelo Wi-Fi), mede o preto do dojô inteiro e a faixa branca de 2,5 cm de verdade e grava um limiar com margem dos dois lados para cada sensor:

1. Com o robô parado (ESPERA), clique em **Iniciar calibração** (o painel manda `calpista on` e o firmware passa a mandar uma linha `J` a cada 20 ms com o mínimo, o máximo e a média de cada sensor).
2. **Preto**: ponha o robô sobre o preto, clique em **Gravar o preto** e desloque o robô por todo o interior do dojô, arranhões incluídos, por uns 5 s. O mínimo é de 100 janelas (2 s) por sensor.
3. **Faixa branca**: escolha um par de sensores (traseiros, frontais, esquerdos, direitos ou os quatro), ponha só esses dois sobre a faixa branca (os outros ficam no preto), clique em **Gravar um passe** e dê uma ou mais voltas pelo dojô com o par na faixa; depois **Fechar o passe**. Dois passes (traseiros e frontais, ou esquerdos e direitos) cobrem os quatro sensores; sensor sem passe fica sem dados e mantém o limiar que já tinha.
4. Confira a tabela e grave com **Gravar no robô** (o painel manda `bordalim NOME LIM PRETO BRANCO` para cada sensor com resultado; o limiar fica na memória e vale depois de desligar, e um ● marca o limiar vindo da pista na tabela de borda).

A conta (bloco `CAL_PISTA_MATEMATICA` do `painel/painel_src.html`) usa a escala em que o branco é a tensão baixa (módulo invertido é detectado) e acha o **pior preto** (quantil de 0,5% dos mínimos das janelas do preto, a leitura mais branca que o preto já deu) e o **pior branco** (quantil de 97% dos máximos das janelas sobre a faixa, a leitura mais escura que a faixa já deu). O limiar fica a uma fração desse vão, 50% por padrão (as duas margens ficam iguais) e ajustável de 25% a 75%. A tabela mostra, por sensor, o pior preto, o pior branco, o limiar, as margens, quantos trechos do preto ainda leem como branco com esse limiar (falso positivo, um limite superior, porque o firmware ainda exige branco contínuo por `BORDA_CONFIRMA_MS`), quantas janelas da faixa nunca leram branco, um histograma e o nível (boa, aceitável ou ruim). Sem folga entre o branco e o preto (menos de 150 mV) ou com contraste menor que 200 mV o nível é ruim e o painel explica a causa provável: arranhão claro, sujeira, sensor alto demais ou reflexo da protoboard.

**Fio no D0**: o módulo TCRT5000 tem o A0 (analógico) e o D0 (saída do comparador, ajustada pelo trimpot azul). Com o fio no D0 o ESP32 só lê 0 V ou 3,3 V, o painel reconhece o sinal digital e avisa que a calibração não refina nada: quem decide a borda é o trimpot (gire até o LED do módulo acender só sobre a faixa branca). Para a calibração da pista valer, ligue o fio no A0.

### Teste da máquina de estados

O comando `go` (ou o botão de start) inicia a contagem de 5 s e depois a luta, com a estratégia e o perfil da chave DIP naquele momento. Na bancada, com `USAR_MOTORES 0`, nenhum pino de motor muda, mas o modo `ver` e o painel mostram o estado atual, a estratégia, o PWM e a velocidade estimada de cada roda. O teste consiste em mover um objeto em volta dos sensores e acompanhar as trocas entre BUSCA, MIRA, FLANCO e ATAQUE. O comando `stop` volta para ESPERA.

Sem o botão de início, sem a chave DIP e sem a chave liga e desliga, o robô parte sozinho ao ligar com o modo autônomo ligado (opção do painel, que vale na próxima ligada, ou `AUTO_START 1` no `config.h` como valor de fábrica, ou `-DAUTO_START=1`). Depois de `AUTO_START_ESPERA_MS` (1 s) com os sensores de oponente prontos (pelo menos 3 funcionando) e o perfil do oponente já aplicado, a ESPERA pede o start e entra na contagem de 5 s da regra, como se o botão tivesse sido apertado. Só vale uma vez por ligada: depois de um `stop` o robô fica na ESPERA, e o `go` e o botão BOOT continuam funcionando. Sem a chave DIP, os quatro pinos ficam em LOW pelo pull-down interno e valem a estratégia Rush e o oponente claro. O valor de fábrica é `AUTO_START 0`, para o robô não andar sozinho quando liga na USB ou na bancada com os motores ativos; com o robô no chão, o tempo entre conectar a bateria e a primeira roda girar é o da inicialização (o `setup` liga os ToF um por um) mais 1 s de espera e 5 s de contagem. Um fio do GPIO 0 ao GND não serve de start, porque o GPIO 0 em LOW na hora de ligar põe o ESP32 em modo de gravação. O `teste/unidade/teste_autostart.cpp` confere no CI que o robô só parte com os sensores prontos, depois do tempo de espera, uma vez por ligada e nunca depois do `stop`.

### Demonstração com o painel (sem botão, sem chave, sem modo autônomo)

Para mostrar o robô funcionando sem botão de início, sem chave DIP e sem a partida automática, tudo sai do painel (`painel/painel_sumo.html`), pela USB ou pelo Wi-Fi. O robô fica em ESPERA e quem manda é o painel, com quatro cartões:

- **Alinhar com o oponente**: o botão manda `alinha on` (tempo escolhido, padrão 90 s). O robô só gira no eixo, em pulsos curtos de 40 a 220 ms separados por pausas de 160 ms em que os ToF medem sem o robô girando, e o pulso é proporcional ao erro (70% dele, sem passar do ponto). Com o oponente na frente, converge até o erro ficar a menos de `ALINHA_TOL_DEG` (3°) por `ALINHA_SEGURA_MS` (250 ms) e fica parado, **ALINHADO**. Como a linha é ignorada, o robô **não sai do lugar nem sai procurando**: ele só acompanha o oponente que os ToF da frente enxergam (e, por `ALINHA_SEGUE_MS`, 500 ms, a estimativa do rastreador depois de perdê-lo, no máximo um pulso). Com o oponente de lado ou de costas, onde os ToF da frente não veem (com 5 sensores não existe ToF atrás e o lateral só alcança `TOF_ALCANCE_LATERAL_MM`, 80 mm), ele fica parado em "SEM OPONENTE NA FRENTE", sem pulsos de busca. O giro total desde o rumo em que o robô foi colocado e ligado nunca passa de `ALINHA_GIRO_MAX_DEG` (90°) para cada lado: se o oponente passar disso, o robô fica parado e avisa no terminal (o giro é o estimado pelo modelo das rodas, sem encoder). Se o oponente andar dentro do campo, volta a girar. Não anda para a frente nem para trás (as duas rodas sempre com PWM opostos, o que o teste confere) e não consulta a linha. Termina sozinho no tempo escolhido, com **Parar** (`alinha off`), `stop` ou `go`. O painel mostra o estado (sem oponente na frente, virando com o erro em graus, alinhado), a barra com o ângulo do oponente, os pulsos, o tempo restante e o giro desde o rumo inicial com o limite ("giro +12° de ±90°"). O firmware manda a linha `Z` do protocolo. Um giro de verdade pode sair um pouco do lugar se uma roda largar antes da outra (atrito diferente): por isso os pulsos são curtos e o giro é limitado; se ainda sair do lugar, confira o sentido das rodas com `mov 0 300 1000` (tem que girar para a esquerda) e `INVERTE_ESQ`/`INVERTE_DIR`.
- **Controle remoto (WASD)**: **Ligar o teclado** libera `W`, `A`, `S`, `D` (ou as setas; duas juntas fazem a diagonal) e `espaço` para parar, além dos botões da tela (mouse e celular). Manda `mov V W 250 3` a cada 120 ms enquanto a tecla está apertada e `mov 0 0 60 3` ao soltar (o 3 = linha ignorada e terminal calado); `espaço`, o botão PARAR, a janela perder o foco e o painel desconectar mandam `stop`. Há o modo cinemática (velocidade 50 a 450 mm/s e giro 30 a 360 graus/s) e o modo PWM direto (10 a 100%), "inverter o giro" e "ignorar a linha (borda)" (ligado por padrão: o controle vale com o sensor de linha marcando ou não, então o robô pode sair do dojô se for deixado correr; sem esse flag a borda encerra o teste na hora). Digitar no terminal ou nos campos não dirige o robô, e o controle só manda movimento com o robô em ESPERA.
- **Opções do robô**: modo autônomo, linha da frente de lado, 5 ou 7 ToF, contagem de 5 s e Wi-Fi na luta, gravados no robô sem regravar o firmware (seção seguinte).
- **Configuração do robô (config.h)**: lê a linha `F` do firmware e compara cada chave com o que a situação pede (demonstração ou competição autônoma), dizendo o que mudar.

Chaves do `config.h` para cada situação (depois de mudar, grave de novo pela IDE do Arduino):

| Chave | Demonstração | Competição autônoma | Observação |
|---|---|---|---|
| `USAR_MOTORES` | 1 | 1 | com 0 o robô não move as rodas (mov, pwm, alinha e WASD não acionam os motores) |
| `USAR_WIFI` | 1 para usar sem cabo (0 se for pela USB) | 0 | com 1 a rede é `SUMO-ROBO` (senha `sumo1234`), endereço 192.168.4.1; o rádio desliga sozinho ao começar a luta sem painel |
| `AUTO_START` | **0** | **1** | valor de fábrica do modo autônomo, que o painel muda sem regravar (opção "Modo autônomo"); com 1 o robô larga sozinho para a luta 1 s depois de ficar pronto, com 0 espera o painel, o `go` ou o botão |
| `USAR_BORDA` | 1 | 1 | sensores de linha ligados |
| `QTD_TOF` | 5 | 5 | valor de fábrica da quantidade de ToF (5 ou 7); o painel muda sem regravar |
| `GEOMETRIA_BANCADA` | 0 | 0 | sempre 0: posições do robô montado (a tabela da bancada só serve aos geradores dos PDFs) |
| `ALINHA_*` | ajuste fino | não usados | tolerância, giro e pausa do alinhamento, ver a tabela de configuração |

Para voltar ao modo autônomo sem PC: no painel, ligue "Modo autônomo" (sem regravar o firmware), desligue o cabo, ligue a bateria e o robô faz a contagem de 5 s e luta sozinho. Antes disso, vale rodar a calibração da pista com o robô no dojô. O alinhamento também funciona com o modo autônomo ligado (o start automático fica suspenso enquanto ele roda), mas a demonstração pede o modo autônomo desligado para o robô não largar para a luta no meio da conversa.

### Opções do robô (gravadas pelo painel)

O cartão **Opções do robô** do painel muda seis comportamentos sem regravar o firmware. Cada botão manda `ajuste NOME VALOR` (só com o robô em ESPERA), e o robô grava o valor na memória não volátil do ESP32 (NVS, namespace `ajustes`), então ele continua valendo depois de desligar a bateria e de desconectar o cabo. O botão "Voltar ao padrão de fábrica" manda `ajuste padrao`. As chaves `QTD_TOF` e `AUTO_START` do `config.h` ficam como valor de fábrica, e `GEOMETRIA_BANCADA` fica sempre em 0.

| Opção do painel | Comando | Efeito | Quando vale |
|---|---|---|---|
| Modo autônomo | `ajuste auto 0\|1` | liga o `AUTO_START`: ao ligar a bateria, o robô espera os sensores ficarem prontos, faz a contagem de 5 s e luta sozinho, com os sensores de linha ativos desde o primeiro instante | na próxima vez que o robô for ligado (para largar agora, use **Iniciar** ou `go`) |
| Sensores de linha da frente | `ajuste linha 0\|1` | 0 = BFE e BFD como no CAD, virados para a frente; 1 = colados de lado, a 90° anti-horário do encaixe (BFE no lado esquerdo e BFD no lado direito do robô) | na hora |
| Sensores de oponente (ToF) | `ajuste tof 5\|7` | 5 (FE, FC, FD, LE e LD) ou 7 (com TE e TD atrás); o XSHUT dos que não estão em uso fica em LOW | o robô reinicia sozinho em 1 s, porque os ToF são configurados na inicialização, e o painel volta a conectar e pede `s1` de novo |
| Contagem de 5 s | `ajuste alinha 0\|1` | 0 = parado; 1 = "Gira até alinhar": durante a contagem o robô só gira em pulsos, sem andar, até ficar de frente para o oponente (a mesma rotina de pulsos da demonstração, mas, sem ver o oponente, ela procura em pulsos de 30°; a demonstração não procura) | na hora |
| Telemetria pelo Wi-Fi: completa ou leve | `ajuste leve 0\|1` | 0 = completa (`D`, `Q` e `A` a 50 Hz e o mapa); 1 = leve: pelo rádio, `D` a 10 Hz, `Q` e `A` a 4 Hz e o mapa a 2 Hz, para o controle remoto e os ajustes terem pouca latência; a USB é sempre completa | na hora; de fábrica leve (`WIFI_LEVE`) |
| Wi-Fi durante a luta | `ajuste wifi 0\|1` | 0 = o rádio desliga ao começar a luta sem painel (`WIFI_DESLIGA_SEM_PAINEL`); 1 = continua ligado, e o painel acompanha a luta, mesmo conectando depois do start | na hora; precisa de `USAR_WIFI 1` no `config.h` |

**Modo autônomo completo.** Com o modo autônomo ligado, os sensores de linha já estão ativos na contagem e na luta, o robô procura e derruba o oponente sozinho, e o painel continua monitorando pelo Wi-Fi (opção "Fica ligado"; `USAR_WIFI 1`). O botão BOOT da placa de extensão (GPIO 0) reinicia a contagem de 5 s, tanto na contagem quanto no meio da luta; com "Gira até alinhar", o robô fica girando sem se mover para o centro até apontar para o oponente à frente, e a luta só começa quando os 5 s terminam. O `go` do painel faz o mesmo que o BOOT. Sem o modo autônomo, o BOOT continua dando o start na ESPERA e reiniciando a contagem de 5 s, mas não interrompe uma luta em andamento.

**Regulamento da CoRA.** O robô precisa ficar parado nos 5 s depois do start, e a comunicação por rádio (Wi-Fi) é proibida durante as lutas. Por isso a contagem girando e o Wi-Fi na luta começam desligados, o painel mostra um aviso em amarelo ao ligar cada um e o uso deles é só para demonstração e testes; na competição, deixe "Parado" e "Desliga ao largar".

**Sensores de linha de lado.** A posição que o painel e a localização no dojô usam para o BFE e o BFD com a opção ligada vem do módulo TCRT5000 de 38 mm girado 90° em torno do centro da placa, e é uma estimativa: `BORDA_LATERAL_X_MM` 77 (para a frente do eixo) e `BORDA_LATERAL_Y_MM` 81 (para a esquerda no BFE e para a direita no BFD). Para ajustar, meça no robô a distância do centro do par infravermelho de cada sensor até o meio do eixo das rodas, na frente e para o lado, e mude as duas constantes no `config.h`. Essa opção só muda onde o painel e o filtro de partículas supõem o sensor; a leitura da linha e a fuga da borda não dependem dela. Com os sensores de lado, "borda de frente" passa a ser um sensor que enxerga a faixa um pouco antes da lateral do robô; vale conferir no dojô.

**Valor de fábrica e `F`.** Sem nenhum ajuste gravado, valem `QTD_TOF`, `AUTO_START` e as demais opções desligadas. A linha `F` do protocolo traz o que está valendo, e o painel atualiza o cartão ao recebê-la: `F,motores,wifi,auto,borda,tof,bancada,radio,linhaLateral,alinhaContagem,wifiLuta,wifiLeve`. Depois de `ajuste`, o robô reenvia o cabeçalho; depois de `ajuste tof`, o painel espera o reinício pela USB (o robô avisa com "o robô reinicia em 1 s" e o banner de inicialização) ou pelo Wi-Fi (reconexão do fluxo) e pede `s1` sozinho.

O `teste/unidade/teste_ajustes.cpp` confere a validação dos valores, a gravação na NVS de mentira, o reinício do ToF e o valor de fábrica; o `teste/unidade/teste_contagem.cpp` confere a contagem de 5 s com a máquina de estados de verdade (BOOT na contagem e na luta, giro sem andar, `go`, luta só depois dos 5 s e o modo autônomo ligado ou desligado); e o `teste/painel/smoke_opcoes.mjs` percorre o cartão no navegador contra o robô de mentira.

Antes do start, um ToF que lê menos de 15 mm com o robô parado aparece como OBSTRUIDO no `lista` (fio, lâmina ou poeira na frente da lente), e essa leitura deixa de contar como oponente encostado até o sensor ler normal de novo.

## Arquitetura

O firmware segue uma regra simples: a máquina de estados só conhece a struct `P` (percepção). Os módulos de sensores escrevem em `P`, a estratégia lê `P` e manda nos motores, e o debug e a telemetria mostram tudo. Com essa separação, um sensor novo entra sem mexer na estratégia, e a estratégia pode ser testada com `P` preenchida à mão.

```mermaid
flowchart LR
    subgraph N0["núcleo 0"]
        OPO["oponente.cpp<br/>leitura dos ToF"] <--> RAS["rastreador.cpp<br/>filtro bayesiano"]
    end
    TOF["5 ou 7 x VL53L0X<br/>I2C e XSHUT"] --> OPO
    TCRT["4 x TCRT5000<br/>ADC1"] --> BOR["borda.cpp<br/>limiar e confirmação"]
    DIP["chave DIP"] --> CHA["chave.cpp<br/>estratégia e perfil"]
    BOT["botão de start"] --> PER
    OPO --> PER["percepcao.cpp<br/>struct P e rumo"]
    BOR --> PER
    PER <--> ARE["arena.cpp<br/>centro do dojô"]
    ARE -. "hipóteses do centro" .-> OPO
    CHA --> EST
    PER --> EST["estados.cpp<br/>máquina de estados"]
    RAS -. "caixa do oponente" .-> ANT["antitrava.cpp<br/>empurrão travado"]
    ANT --> EST
    EST --> CIN["cinematica.cpp<br/>v e w para cada roda"]
    CIN --> MOT["motores.cpp<br/>ponte H"]
    CIN -. "giro e avanço estimados" .-> RAS
    CIN -. "giro e avanço estimados" .-> ARE
    PER --> DEB["debug.cpp<br/>comandos e stream"]
    DEB --> TEL["telemetria.cpp<br/>Log pela USB e pelo WiFi"]
    TEL --> USB["Monitor Serial"]
    TEL --> PAI["painel_sumo.html"]
    PAI -- "comandos pela USB ou pelo WiFi" --> TEL
```

Nenhum módulo usa `delay()` dentro do loop. Cada volta chama os módulos na ordem abaixo, e cada um faz uma parte pequena do trabalho e devolve o controle.

| Ordem | Chamada | Arquivo | Papel |
|---|---|---|---|
| 1 | `percepcao_atualiza()` | percepcao.cpp | chave DIP, estimativa do oponente, rumo, borda, localização no dojô e montagem de `P` |
| 2 | `estados_passo()` | estados.cpp e cinematica.cpp | decisão, cinemática das rodas e comando dos motores |
| 3 | `percepcao_manutencao()` | percepcao.cpp | nova tentativa nos ToF que caíram, só em ESPERA |
| 4 | `debug_passo()` | debug.cpp | comandos e envio de dados para o painel |

O ESP32 tem dois núcleos, e o trabalho fica dividido entre eles. No núcleo 0, uma tarefa do FreeRTOS lê os ToF, descarta as leituras de fora do dojô e roda o rastreador bayesiano, que leva alguns milissegundos por passo. No núcleo 1, o loop do Arduino lê a borda a cada volta, roda a localização no dojô, decide o estado e comanda os motores, então a reação à borda nunca espera um sensor I2C nem o rastreador. Com `USAR_WIFI 0` (padrão) o firmware não liga o rádio, e a pilha do WiFi não disputa o núcleo 0; com `USAR_WIFI 1` ela disputa, e o `tempo` mostra o custo. A troca de dados entre os núcleos acontece dentro de travas curtas (spinlock), e o I2C tem um mutex para os comandos do terminal que mexem nos sensores.

O referencial é o mesmo em todo o código: origem no centro de giro do robô, x para a frente, y para a esquerda e ângulo positivo para a esquerda. Com isso, o ângulo do oponente já é o quanto o robô precisa girar.

## Mapa do código

Todos os arquivos desta seção ficam em `firmware/sumo_esp32/`, a pasta do sketch. Os módulos ficam juntos, sem subpastas, porque a Arduino IDE só mostra como abas os arquivos da própria pasta do sketch e só compila, além dela, a subpasta `src/`.

### `sumo_esp32.ino`

Arquivo principal. O `setup()` configura primeiro os motores, para o robô nascer parado, cria um buffer de 4 KB na serial, lê as opções gravadas na NVS (`ajustes_carrega()`, antes de qualquer módulo usar a quantidade de ToF ou a posição dos sensores de linha) e inicializa percepção, máquina de estados e debug. O `loop()` apenas chama os módulos na ordem da tabela de arquitetura.

### `config.h`

Este arquivo concentra tudo o que depende do hardware: pinos, posição dos sensores, limiares, velocidades e tempos. As tabelas `TOF[]` e `BORDA[]` descrevem os sensores, e o tamanho delas sai de `sizeof`, então um sensor a mais é só uma linha a mais na tabela (até 16 ToF). A chave `GEOMETRIA_BANCADA` fica em 0 (a tabela da bancada só é lida pelos geradores dos PDFs), e a `QTD_TOF` é o valor de fábrica da quantidade de sensores (5 ou 7; qualquer outro valor interrompe a compilação). As duas tabelas `TOF[]` sempre trazem os 7 sensores: `TOF_MAX` é o tamanho delas, usado nos vetores, e `N_TOF` é a quantidade em uso, uma das opções do painel (`ajustes().tof`). A struct `Ajustes` (tof, autônomo, linha da frente de lado, contagem girando e Wi-Fi na luta) e as posições `borda_x(i)` e `borda_y(i)`, que trocam as dos sensores da frente quando a linha está de lado (`BORDA_LATERAL_X_MM` e `BORDA_LATERAL_Y_MM`), também ficam aqui. O alcance `TOF_ALCANCE_MM` vem da geometria do dojô: no pior caso, o centro do robô chega a uns 340 mm do centro do dojô (sensor de borda na faixa, que começa a 360 mm, mais a distância de parada), e o oponente, inteiro dentro do dojô, tem o centro a até 385 − 76 = 309 mm do centro. Em lados opostos, a face do oponente fica a 340 + 309 − 76 = 573 mm do centro do robô, e com 27 mm de folga o alcance fica em 600 mm. Qualquer leitura mais longe é parede, mesa ou pessoa e vale como "nada"; o que fica mais perto, mas cai fora do dojô pela localização, também não vira oponente.

### `percepcao.h` e `percepcao.cpp`

Estes arquivos definem a struct `P` e as partes dela: `op` (oponente), `rumo`, `borda`, `arena` (localização no dojô), `saude`, o evento `start` e o instante `t_ms`. A função `percepcao_atualiza()` mede a duração do ciclo, lê a chave DIP, pega a estimativa do oponente, calcula o rumo, lê a borda, atualiza a localização no dojô, atualiza a saúde dos sensores e trata o botão de start com debounce de 30 ms. O campo `op.aproximacao` dá a velocidade com que o oponente se aproxima (usada na resposta à investida), o `op.contato` indica o oponente colado na frente e o `op.colados` marca os ToF com algo encostado; com contato, oponente perto ou borda vista por mais de 150 ms, a localização trata o movimento das rodas como incerto. A `percepcao_manutencao()` tenta religar os ToF que falharam a cada 2 s, somente com o robô parado, porque essa operação bloqueia por alguns milissegundos.

O rumo é a direção que o robô deve seguir agora e aparece no painel como uma seta:

| Modo | Quando | Ângulo | Cor da seta |
|---|---|---|---|
| ATACAR | oponente visto e centrado | até o oponente | vermelha |
| MIRAR | oponente visto fora do centro | até o oponente | laranja |
| PROVÁVEL | oponente perdido há pouco, mapa ainda concentrado | até onde ele provavelmente está | amarela |
| PROCURAR | sem pista | giro que leva os cones aos pontos cegos | azul |

### `oponente.h` e `oponente.cpp`

Módulo dos VL53L0X, com quatro tarefas. A primeira é a inicialização: todos os sensores começam desligados pelo XSHUT, e cada um é ligado sozinho, responde no endereço de fábrica 0x29 e recebe o endereço da tabela. A segunda é a leitura, numa tarefa do FreeRTOS no núcleo 0: os sensores medem em modo contínuo (a cada 20 ms no perfil claro e 33 ms no escuro) e a tarefa só consulta cada um perto da hora de ter medida nova; a leitura passa pela calibração `ganho * bruto + offset`, pela mediana das 3 últimas medidas e pelo alcance de cada sensor. Uma leitura abaixo de 15 mm durante a luta vira o oponente encostado naquele lado; com o robô parado antes da luta, ela marca o sensor como obstruído. A terceira é o descarte: a leitura cujo ponto cai fora do dojô em todas as hipóteses da localização vira "sem informação", e por 400 ms depois da borda de trás os ToF de trás ignoram o que passa de 120 mm. A quarta é a fusão: com `FUSAO_BAYES 0` as leituras do mesmo objeto viram um ponto médio, e com `FUSAO_BAYES 1` (padrão) as medidas vão para o rastreador, rodado na mesma tarefa. A troca de perfil pedida pela DIP 4 também acontece nessa tarefa. Um sensor só é marcado como FALHOU depois de erros repetidos de I2C, então uma pausa longa não derruba um sensor bom.

### `rastreador.h` e `rastreador.cpp`

Filtro bayesiano em grade (filtro de histograma) para um único oponente quadrado de 15,2 cm [THRUN; BURGARD; FOX, 2005]. O mapa guarda a probabilidade de o centro do oponente estar em cada célula de uma grade polar de 120 direções de 3° por anéis de 20 mm, a partir de 150 mm do centro do robô. Tudo o que depende só da geometria (o que cada sensor deveria ler para cada célula) é calculado uma vez no boot, então durante a luta sobram multiplicações com tabelas, sem trigonometria. A cada medida nova o filtro passa por quatro etapas:

1. Predição: o mapa espalha um pouco, porque o oponente pode ter andado até 1,5 m/s e o robô pode ter girado; com o giro conhecido pelos motores, o mapa também gira junto.
2. Correção: cada sensor confirma as células em que a face do oponente ficaria na distância lida, e um sensor sem leitura desmente as células no meio do próprio cone (informação negativa).
3. Regra: células dentro do corpo do robô valem zero, células que ficam fora do dojô em todas as hipóteses da localização perdem a probabilidade (um oponente fora do dojô já perdeu a luta), e uma pequena mistura uniforme permite reencontrar o oponente se o mapa errar.
4. Existência: uma probabilidade separada indica se existe oponente no alcance, e ela só sobe quando as leituras aparecem repetidas e coerentes. Por isso a arena vazia quase nunca gera oponente falso.

A estimativa final traz ângulo, distância, posição, incerteza (sigma), concentração do mapa, chance de existir e o giro de busca. O giro de busca sai de uma avaliação de vários giros possíveis, de 6 em 6 graus para cada lado: para cada um, o código soma quanto do mapa os cones vão varrer e divide pelo tempo de girar, e o melhor vira o rumo PROCURAR. O resultado é que o robô olha primeiro os pontos cegos onde o oponente pode estar.

### `arena.h` e `arena.cpp`

Localização no dojô por filtro de partículas, descrita na seção [Localização no dojô](#localização-no-dojô). A `arena_atualiza()` roda no loop, no núcleo 1, com o avanço e o giro estimados pela cinemática, a borda crua e a confirmada e o aviso de movimento incerto; a `arena_le()` entrega uma cópia protegida para o outro núcleo. A `arena_limite()` dá, em cada direção, a distância além da qual um ponto fica fora do dojô em todas as hipóteses, e a `arena_fora()` usa esse limite no descarte das leituras. A `arena_livre()` dá o espaço até a borda numa direção, usado pelo Flank e pelo Fan out.

### `chave.h` e `chave.cpp`

Leitura da chave DIP de 4 vias, com `INPUT_PULLDOWN` nos quatro pinos e filtro de 30 ms. As vias 1 a 3 escolhem a estratégia e a via 4 o perfil do oponente escuro; os comandos `estrategia` e `perfil` passam por cima da chave.

### `borda.h` e `borda.cpp`

Leitura dos quatro TCRT5000 pela saída analógica, em milivolts, seguindo a recomendação de leitura analógica com limiar de tempo do Blackbook [DEDE, s.d.]. Cada sensor tem um limiar calculado a partir da calibração (o do `calborda`, o da calibração de pista gravado por `bordalim` ou o valor fixo do `config.h`) e um contador de leituras seguidas no branco. Com o `calpista` ligado, cada leitura também alimenta as janelas de mínimo, máximo e média que viram a linha `J`. A borda só é confirmada com branco contínuo por pelo menos 3 ms e duas leituras, o que descarta arranhões; a linha de 2,5 cm passa em uns 25 ms com o robô a 1 m/s, então sobra margem. No final, a máscara de sensores confirmados vira as informações de lado, frente e trás usadas pela máquina de estados.

### `estados.h` e `estados.cpp`

Máquina de estados da estratégia. Em ESPERA também ficam os testes `mov` e `pwm` (com os flags de linha ignorada e texto calado) e a demonstração de alinhamento (`alinha`, só giro no lugar em pulsos, sem busca às cegas e com limite de giro). Na CONTAGEM de 5 s, com a opção "Gira até alinhar", a mesma rotina de pulsos gira o robô até ficar de frente para o oponente, sem andar; o BOOT (ou o `go`) reinicia a contagem, também no meio da luta quando o modo autônomo está ligado, e o robô só luta quando os 5 s terminam. A borda tem prioridade sobre tudo durante a luta, e o ataque só acontece com o sensor central vendo o oponente centrado (até 7°), como recomenda o Blackbook [DEDE, s.d.]. A estratégia e o perfil saem da chave DIP e ficam travados no start, junto com o começo da localização, que usa o oponente visto na contagem para saber de que lado fica o centro. As regras da fuga da borda e de cada estratégia estão nas seções [Estratégias e chave DIP](#estratégias-e-chave-dip) e [Fuga da borda](#fuga-da-borda). Cada estado pede avanço e giro para a cinemática, como mostra a seção [Cinemática das rodas](#cinemática-das-rodas).

```mermaid
stateDiagram-v2
    [*] --> ESPERA
    ESPERA --> CONTAGEM: start com sensores OK
    CONTAGEM --> LUTA: 5 s
    state LUTA {
        [*] --> BUSCA
        BUSCA --> MIRA: oponente visto
        BUSCA --> ATAQUE: oponente centrado
        BUSCA --> FLANCO: Flank, oponente longe ou largada
        BUSCA --> LEQUE: Fan out, oponente à vista
        BUSCA --> ATAQUE_RE: oponente colado atrás
        MIRA --> ATAQUE: centrado
        MIRA --> BUSCA: perdido
        FLANCO --> ATAQUE: perto, aberto ou investida
        LEQUE --> ATAQUE: perto ou aberto
        ATAQUE --> MIRA: fora do centro
        ATAQUE --> BUSCA: perdido
        ATAQUE_RE --> MIRA: saiu de trás
        MIRA --> DESTRAVA: giro preso
        DESTRAVA --> MIRA: quina solta
    }
    LUTA --> RECUO: borda na frente
    LUTA --> AVANCO_BORDA: borda atrás
    LUTA --> SAIDA_LATERAL: borda num lado
    LUTA --> GIRO_BORDA: borda na frente e atrás
    RECUO --> GIRO_BORDA: branco sumiu ou traseira na borda
    RECUO --> ATAQUE_RE: recuo empurrando o oponente
    SAIDA_LATERAL --> GIRO_BORDA: lado limpo
    AVANCO_BORDA --> GIRO_BORDA: frente na borda
    AVANCO_BORDA --> LUTA: branco sumiu
    GIRO_BORDA --> LUTA: oponente visto ou de frente para o centro
    GIRO_BORDA --> RECUO: borda de novo na frente
    GIRO_BORDA --> AVANCO_BORDA: borda de novo atrás
    LUTA --> ESPERA: stop
```

No diagrama, LUTA agrupa BUSCA, MIRA, FLANCO, LEQUE, ATAQUE, ATAQUE_RE e DESTRAVA. A saída de GIRO_BORDA cai em ATAQUE_RE, FLANCO, LEQUE, ATAQUE, MIRA ou BUSCA, conforme a posição do oponente, e a saída de AVANCO_BORDA cai em BUSCA. O comando `stop` leva qualquer estado para ESPERA.

Na BUSCA, longe do centro do dojô, o robô volta para o meio procurando no caminho. Perto do centro, no Rush e no Flank, o robô gira no eixo a 200 graus/s para o lado do rumo; depois de 1,5 s girando sem pista (rumo PROCURAR), avança a 240 mm/s por 0,25 s para mudar o ponto de vista e volta a girar. No Fan out, o rumo oscila em leque. Quando o rumo é PROVÁVEL e o oponente deve estar bem à frente (até 12°), o robô avança em vez de girar. Com `MODO_DEFENSIVO 1`, o robô só gira e mira, sem avançar.

### `antitrava.h` e `antitrava.cpp`

Detecção do empurrão travado pela caixa do rastreador parada e manobras para sair dele, descritas em [Travamento](#travamento). O `estados_passo()` chama o `antitrava_passo()` depois da borda e do giro preso; quando uma manobra está em andamento, ela comanda as rodas e a máquina de estados não manda nada naquela volta, e a borda cancela a manobra. Com `ANTI_TRAVA 0` o módulo fica vazio.

### `motores.h` e `motores.cpp`

Controle do módulo HW-956 (ponte H dupla de 10 A), com valores de -255 a 255 por roda. O PWM vai no próprio pino IN: para a frente o IN1 recebe o PWM e o IN2 fica em LOW, e para trás o contrário. Com comando 0 os dois pinos ficam em LOW e o motor para. O PWM sai do periférico LEDC do ESP32 a 1 kHz (`PWM_MOTOR_HZ`), abaixo do limite de 2 kHz do módulo. A configuração do LEDC acontece uma vez só no `motores_init()`, e depois disso cada comando só troca o duty. O `analogWrite` ficou de fora porque, no core 2.x, cada chamada dele zera o contador do PWM, e com o loop rodando em microssegundos o sinal no pino deixa de seguir o comando. O anúncio do módulo pede parada antes de inverter o sentido, por causa do pico de corrente; com o JGB37-520 esse pico fica perto de 2,4 A por motor na inversão em velocidade máxima, bem abaixo dos 10 A do módulo, e a fuga da borda inverte na hora. As chaves `INVERTE_ESQ` e `INVERTE_DIR` corrigem um motor ligado ao contrário e a `TROCA_MOTORES` corrige os dois motores trocados de saída, sem mexer nos fios. Com `USAR_MOTORES 0`, o módulo só guarda o último comando, que aparece no debug.

### `cinematica.h` e `cinematica.cpp`

Cinemática das rodas e modelo do acionamento, descritos na seção [Cinemática das rodas](#cinemática-das-rodas). A função `cinematica_comanda(v, w, perfil)` recebe o avanço em mm/s e o giro em graus/s e manda o PWM para o `motores.cpp`; o perfil `PERFIL_BORDA` pula o limitador e usa a tensão toda. As funções `cinematica_v_mms()` e `cinematica_w_dps()` devolvem a velocidade estimada pelo modelo, usada pelo rastreador, e a `cinematica_giro()` devolve o giro acumulado, usado no GIRO_BORDA e no comando `mov`. As constantes derivadas do `config.h` (velocidade e giro máximos, kS, kV, kA e distância de parada) ficam no `cinematica.h`, e a conta da distância de parada é conferida na compilação.

### `ajustes.h` e `ajustes.cpp`

Opções do painel gravadas na NVS (namespace `ajustes`, chaves `tof`, `auto`, `blat`, `alin` e `wifi`). `ajustes_carrega()` lê tudo no começo do `setup`, `ajustes_define(nome, valor)` valida (`tof` só 5 ou 7, as outras 0 ou 1), aplica e grava, e devolve `AJUSTE_REINICIA` quando a quantidade de ToF muda, e `ajustes_padrao()` apaga tudo e volta ao valor de fábrica. O módulo só mexe na struct `Ajustes` do `config.h`; quem reinicia o robô é o `debug.cpp`, 1 s depois do comando, para a resposta chegar ao painel. Não entra nas listas de compilação do simulador de combate, que usa os valores de fábrica.

### `telemetria.h` e `telemetria.cpp`

Saída de texto e entrada de comandos pela USB e, com `USAR_WIFI 1`, também pelo WiFi. O objeto `Log` substitui o `Serial` em todo o projeto: cada linha sai inteira, o que deixa o painel ler sem pedaços misturados. As linhas de dados (`D`, `Q`, `A`, `M`, `J` e `Z`) são descartadas quando o buffer da serial (ou do socket do WiFi) está cheio, então o robô nunca fica esperando a USB nem a rede; o comando `tempo` mostra quantas linhas foram descartadas. A função `entrada_le()` entrega ao debug os caracteres que chegam do Monitor Serial ou do painel (USB, ou `/cmd` do WiFi, por um anel de 256 bytes). Com `USAR_WIFI 1`, `telemetria_init()` cria a rede e o servidor HTTP da porta 80 (`/stream`, `/cmd`, `/ping`, com CORS liberado e resposta ao `OPTIONS`), `telemetria_passo()` atende a rede a cada 3 ms no máximo e, com `WIFI_DESLIGA_SEM_PAINEL 1` (e a opção "Wi-Fi durante a luta" desligada), desliga o rádio na luta sem painel; no modo Wi-Fi leve filtra as linhas de dados que vão para o rádio (`D` a 100 ms, `Q` e `A` a 250 ms, sem `M`), e fixa o ponto de acesso em 20 MHz; com 0 as mesmas funções existem e não fazem nada.

### `debug.h` e `debug.cpp`

Comandos de teste e calibração, os modos contínuos (`ver`, `id`, `borda`) e o stream para o painel. Este módulo conversa com todos os outros, porque precisa mostrar tudo. Os dados para o painel seguem um protocolo de texto simples, com uma letra no início de cada linha:

| Linha | Conteúdo | Quando |
|---|---|---|
| `G`, `I`, `C` | geometria, status e calibração de cada ToF | comando `s1`, enviado pelo painel ao conectar |
| `R` | posição, limiar, preto, branco, calibração gravada, sentido do branco e se o limiar veio da calibração de pista, de cada sensor de borda | comando `s1` e depois de cada calibração |
| `B`, `E`, `K`, `X` | corpo do robô, nomes dos estados, alcance e parâmetros do rastreador (a `X` traz também `TOF_ALCANCE_LATERAL_MM` e `TOF_ALCANCE_TRAS_MM`) | comando `s1` |
| `F` | chaves em uso: `USAR_MOTORES`, `USAR_WIFI`, modo autônomo, `USAR_BORDA`, quantidade de ToF em uso, `GEOMETRIA_BANCADA`, se o rádio está ligado e as opções linha de lado, contagem girando, Wi-Fi na luta e Wi-Fi leve | comando `s1` e depois de cada `ajuste` |
| `D` | leituras, oponente, estado, saúde, incerteza, existência e rumo | a cada 20 ms |
| `Q` | borda confirmada, borda crua e mV de cada sensor | a cada 20 ms |
| `M` | mapa de probabilidade comprimido | a cada 250 ms |
| `J` | janela da calibração de pista: número, leituras e, por sensor de borda, mínimo, máximo e média em mV | a cada 20 ms, só com `calpista on` |
| `Z` | demonstração de alinhamento: fase (0 desligado, 1 sem oponente ao alcance, 2 virando, 3 alinhado), erro em décimos de grau (positivo à esquerda), segundos restantes, pulsos, giro desde o rumo inicial em décimos de grau e limite do giro de cada lado em graus (0 na contagem de 5 s, que busca em pulsos) | a cada 100 ms, só com `alinha on` |

### Painel

O `painel/painel_sumo.html` é o painel completo, com o three.js e o OrbitControls embutidos. O código fonte fica em `painel/painel_src.html`, e o script `ferramentas/gera_painel.py` junta o fonte com as bibliotecas de `painel/vendor/` e gera o `painel/painel_sumo.html`. Qualquer mudança no painel exige rodar `python ferramentas/gera_painel.py` e fazer o commit dos dois arquivos; o CI confere se eles estão iguais.

### Documentos de montagem

A pasta `doc/pdf/` traz o `gabarito_bancada.pdf` (bancada em escala 1:1, vista lateral, cotas e montagem dos sensores de borda), o `guia_montagem_sensores.pdf` (gabarito 1:1 do robô montado, com o corpo do chassi do STEP e a origem no eixo das rodas, mapa de ligação na protoboard e lista de conferência) e o `guia_montagem_sensores_7.pdf`, com a mesma estrutura para 7 sensores mais o gabarito da bancada com o par novo, a pinagem completa do ESP32 e o estudo de cobertura de 08/10. Os scripts `ferramentas/gera_bancada.py` e `ferramentas/gera_guia.py` geram esses PDFs a partir das tabelas do `config.h` com a biblioteca ReportLab (`python ferramentas/gera_guia.py --sensores 7` gera a versão de 7). Depois de qualquer mudança na posição de um sensor no `config.h`, os guias precisam sair de novo.

## Configuração

Os ajustes principais ficam no `config.h`:

| Constante | Valor | Efeito |
|---|---|---|
| `GEOMETRIA_BANCADA` | 0 | sempre 0 (posições do robô montado); 1 só para os geradores dos PDFs |
| `QTD_TOF` | 5 | valor de fábrica da quantidade de sensores de oponente, 5 ou 7; o painel muda sem regravar (também aceita `-DQTD_TOF=7` na compilação) |
| `BORDA_LATERAL_X_MM` e `BORDA_LATERAL_Y_MM` | 77 e 81 | posição estimada dos sensores de linha da frente quando a opção "de lado" está ligada; medir no robô |
| `I2C_CLOCK_HZ` | 100000 | velocidade do I2C; 400000 só com fios curtos |
| `TOF_TIMING_US` | 20000 | tempo de cada medida do ToF no perfil claro |
| `TOF_ALCANCE_MM` | 600 | alcance máximo a partir do centro do robô (pior caso dentro do dojô) |
| `TOF_ALCANCE_LATERAL_MM` | 80 | alcance dos ToF laterais (LE e LD, ângulo de 80° a 120°): evita que dois sensores do mesmo lado somem a plateia em volta do dojô; aumente para 100 a 150 se perder o oponente que passa pela lateral, diminua para 50 a 60 se ainda mirar a plateia (1000 ou mais desliga o limite) |
| `TOF_ALCANCE_TRAS_MM` | 200 | alcance do par que olha para trás (TE e TD, ângulo de 120° ou mais): com 600 mm o par de trás mirou a plateia por até 53 s; aumente se perder o oponente que chega por trás, diminua se mirar a plateia |
| `TOF_MINIMO_PARA_LUTAR` | 3 | quantidade mínima de ToF para o robô iniciar |
| `CENTRO_DEG` | 7 | ângulo máximo para o oponente contar como centrado |
| `FUSAO_BAYES` | 1 | 1 usa o rastreador e 0 a fusão simples |
| `OPONENTE_LADO_MM` | 152 | lado do oponente, pela regra da classe |
| `ALCANCE_PRETO_MM` | 550 | distância até onde o ToF vê um robô preto sem falhar |
| `OP_VEL_MAX_MMS` | 1500 | velocidade máxima considerada para o oponente |
| `SENSORES_NUCLEO` | 0 | núcleo da tarefa dos ToF e do rastreador; -1 roda dentro do loop |
| `PINO_DIP1` a `PINO_DIP4` | 12, 14, 2 e 15 | chave DIP: estratégia nas vias 1 a 3 e perfil escuro na via 4 |
| `ESCURO_TIMING_US`, `ESCURO_SINAL_MCPS` e `ESCURO_ALCANCE_MM` | 33000, 0,10 e 700 | perfil do oponente escuro nos ToF |
| `ESCURO_PD_MAX`, `ESCURO_FALSA_FATOR`, `ESCURO_RUIDO_FATOR` e `ESCURO_PERDE_MS` | 0,85, 2,5, 1,5 e 180 | modelo do rastreador no perfil escuro |
| `ARENA_N` e `ARENA_PASSO_MS` | 600 e 5 | partículas e intervalo do filtro da localização |
| `ARENA_SIGMA_OK` e `ARENA_MARGEM_MM` | 70 e 30 | incerteza abaixo da qual a localização guia o robô e folga além da borda no descarte |
| `APROX_RAPIDA_MMS` e `APROX_RAPIDA_DEG` | 300 e 45 | investida: velocidade e ângulo a partir dos quais o robô recebe de frente |
| `DIST_RE_MM` e `ANG_RE_DEG` | 260 e 35 | oponente colado atrás: distância e ângulo do ataque de ré |
| `RETORNO_DIST_MM` e `VEL_RETORNO_MMS` | 150 e 320 | volta ao centro na busca |
| `FLANCO_DESVIO_DEG`, `FLANCO_FECHA_MM` e `T_FLANCO_MAX_MS` | 35, 180 e 1500 | Flank: desvio da mira, distância de fechar e tempo máximo |
| `FAN_AMPL_DEG`, `FAN_GIRO_DPS` e `FAN_VEL_MMS` | 45, 260 e 140 | Fan out: amplitude, giro e avanço do leque |
| `T_RECUO_BLOQ_MS` | 300 | recuo preso no branco por esse tempo vira curva de ré |
| `T_GIRO_TRAVA_MS`, `GIRO_TRAVA_DEG` e `GIRO_TRAVA_GANHO_DEG` | 600, 90 e 15 | giro preso: janela, giro estimado e melhora mínima do ângulo do oponente |
| `T_DESTRAVA_RE_MS` e `T_DESTRAVA_AVANCO_MS` | 250 e 250 | ré (com espaço atrás) ou avanço da manobra DESTRAVA |
| `T_TRAVA_MS` | 1600 | empurrão em contato a partir do qual o travamento aparece no painel |
| `ANTI_TRAVA` | 1 | 1 liga o reconhecimento do empurrão travado pela caixa do rastreador; 0 apaga o módulo |
| `ANTI_TRAVA_MANOBRA` | 0 | o que fazer ao detectar o empurrão travado: 0 só avisa, 1 lateral, 2 torque, 3 zigue, 4 giro, 5 pulso (cada opção está comentada no `config.h`: descomente uma) |
| `PINO_LED_TRAVA` | -1 | GPIO de um LED que acende no empurrão travado; -1 sem LED (um LED com resistor de 330 ohms em qualquer GPIO livre de saída, que o DevKit de 30 pinos não deixa muitos) |
| `MOTOR_C_TERM_JK` e `MOTOR_R_TERM_KW` | 40 e 6 | capacidade (J/K) e resistência (K/W) térmicas de cada motor (estimadas; medir) |
| `MOTOR_QUENTE_K`, `MOTOR_FRIO_K` e `MOTOR_PWM_QUENTE` | 60, 45 e 0,7 | limite térmico: liga, desliga e PWM máximo das manobras normais |
| `BORDA_LIMIAR_MV` | 600 | limiar fixo da borda antes da calibração |
| `BORDA_FRACAO` | 0,35 | posição do limiar calibrado entre o branco e o preto |
| `BORDA_CONFIRMA_MS` | 3 | tempo mínimo de branco contínuo para confirmar a borda |
| `USAR_BORDA` e `USAR_MOTORES` | 1 e 0 | liga e desliga cada parte do hardware |
| `STREAM_MS` | 20 | intervalo dos dados enviados ao painel (USB e WiFi) |
| `USAR_WIFI` | 0 | 1 liga o WiFi opcional (rede própria ou roteador, painel sem cabo); 0 não compila nada do rádio (também aceita `-DUSAR_WIFI=1`) |
| `WIFI_AP_SSID`, `WIFI_AP_SENHA` e `WIFI_AP_CANAL` | "SUMO-ROBO", "sumo1234" e 6 | rede criada pelo ESP32 (senha com no mínimo 8 caracteres) |
| `WIFI_STA_SSID`, `WIFI_STA_SENHA` e `WIFI_NOME_MDNS` | vazios e "sumo" | roteador a procurar primeiro (vazio usa só a rede própria) e nome `sumo.local` |
| `WIFI_DESLIGA_SEM_PAINEL` | 1 | 1 desliga o rádio quando a luta começa (ou continua) sem nenhum painel conectado |
| `WIFI_LEVE`, `WIFI_LEVE_D_MS`, `WIFI_LEVE_QA_MS` e `WIFI_LEVE_M_MS` | 1, 100, 250 e 500 | valor de fábrica do Wi-Fi leve (o painel muda sem regravar) e o intervalo, em ms, das linhas `D`, das linhas `Q` e `A` e do mapa `M` pelo rádio nesse modo (`WIFI_LEVE_M_MS` 0 tira o mapa) |
| `MOTOR_RPM_LIVRE`, `MOTOR_V_PARTIDA` e `MOTOR_KA` | 319, 1,5 e 1,25 | modelo do motor (tabela do JGB37-520; o kA precisa de medida) |
| `BATERIA_V` e `PONTE_QUEDA_V` | 11,1 e 0,2 | tensão que chega no motor com PWM de 100% |
| `RODA_DIAMETRO_MM` e `BITOLA_MM` | 32 e 132 | roda e distância entre as rodas (a bitola precisa de medida) |
| `ACEL_MAX_MMS2` e `FREIO_MIN_MMS2` | 6000 e 4400 | limite de aceleração das manobras e pior frenagem na borda |
| `VEL_BUSCA_MMS` e `GIRO_BUSCA_DPS` | 240 e 200 | avanço curto e giro da busca |
| `K_MIRA`, `ANG_MIRA_CURVA` e `GIRO_MIRA_MAX_DPS` | 6, 40 e 370 | ganho da mira, ângulo até onde a mira é curva e giro máximo da mira |
| `K_ATAQUE` | 2 | ganho de giro no ataque, menor que o da mira para o robô não perder avanço (ver "Otimização do ataque") |
| `GIRO_BORDA_DPS`, `ANG_GIRO_BORDA` e `T_GIRO_BORDA_MAX_MS` | 370, 135 e 900 | giro de recuperação na borda (135° só sem localização) e limite de segurança |
| `T_CONTAGEM_MS` | 5000 | contagem obrigatória antes da luta |
| `AUTO_START` e `AUTO_START_ESPERA_MS` | 0 e 1000 | valor de fábrica do modo autônomo (o painel muda sem regravar): 1 faz o start sozinho, depois de 1 s com os sensores prontos, uma vez por ligada (robô sem botão de início) |
| `ALINHA_TOL_DEG` e `ALINHA_SEGURA_MS` | 3,0 e 250 | demonstração de alinhamento: erro máximo e tempo dentro dele para valer como alinhado (se oscilar, aumente a tolerância) |
| `ALINHA_W_MIN_DPS`, `ALINHA_W_MAX_DPS` e `ALINHA_K_DPS_GRAU` | 70, 180 e 5,0 | giro do pulso de acerto: mínimo (as rodas precisam vencer o atrito), máximo e graus/s por grau de erro |
| `ALINHA_PULSO_MIN_MS`, `ALINHA_PULSO_MAX_MS`, `ALINHA_FRACAO_PULSO` e `ALINHA_PAUSA_MS` | 40, 220, 0,7 e 160 | duração do pulso, fração do erro que cada pulso gira e pausa para os ToF medirem |
| `ALINHA_GIRO_MAX_DEG` e `ALINHA_SEGUE_MS` | 90 e 500 | demonstração: giro máximo para cada lado desde o rumo inicial (0 tira o limite) e quanto tempo segue a estimativa do rastreador depois de perder o oponente de vista |
| `ALINHA_BUSCA_W_DPS` e `ALINHA_BUSCA_PULSO_MS` | 130 e 230 | pulso de busca da contagem de 5 s com "Gira até alinhar", com o oponente fora da vista (30° por pulso); a demonstração não busca |
| `ALINHA_TEMPO_PADRAO_S` e `ALINHA_TEMPO_MAX_S` | 60 e 600 | duração do `alinha on` sem tempo e o máximo |
| `T_BUSCA_GIRO_MS` e `T_BUSCA_AVANCO_MS` | 1500 e 250 | tempo girando na busca e tempo do avanço curto |
| `MODO_DEFENSIVO` | 0 | 1 faz o robô só mirar, sem avançar |

### Distância da plateia ao dojô

Quanto o dojô precisa estar afastado da plateia para nenhum ToF ler uma pessoa depende do alcance de cada sensor, e por isso muda com `TOF_ALCANCE_MM`, `TOF_ALCANCE_LATERAL_MM` e `TOF_ALCANCE_TRAS_MM`. A conta (`python ferramentas/alcance_plateia.py`, que lê o `config.h`) trata a plateia como um plano paralelo à borda do robô que encosta na linha, e conta a distância a partir da ponta do robô, encostada na borda de fora da faixa branca. Um sensor lê o plano quando algum raio do cone (eixo mais ou menos 12,5°) chega nele dentro da leitura máxima do sensor, a mesma do `rastreador_alcance_sensor`: o círculo de 600 mm em volta do eixo das rodas, limitado a 80 mm nos laterais e a 200 mm no par de trás. Com os valores padrão:

| Robô na linha | Sensor que chega mais longe | Plateia fora do alcance a mais de |
|---|---|---|
| Ponta da rampa na linha, olhando para fora | FC (FE e FD: 47 cm) | 48 cm |
| Traseira na linha, de costas para a plateia | TE e TD | 13 cm |
| De lado, com o lado esquerdo ou direito na linha | FE ou FD, que apontam 17° para fora (TE: 11 cm, LE e LD: 8 cm) | 21 cm |

Os números são do desenho do cone, sem medida no dojô. Uma pessoa, mais estreita que um plano, é lida de menos longe, e um robô torto em relação à linha lê menos para fora. O regulamento da CoRA não foi conferido quanto a uma distância mínima da plateia. Com a localização do dojô válida, o firmware ainda ignora a leitura que cai mais de `ARENA_MARGEM_MM` (30 mm) além do raio do dojô, então esses números valem de verdade na largada, antes de a localização convergir, e se a incerteza passar de `ARENA_SIGMA_DESCARTE` (150 mm). Na bateria com pessoas em volta, elas ficam de 0,9 a 1,3 m da borda.

## Estrutura de pastas

```
LAB_III_Grupo_D_UFMG_2026_2/
  README.md                 este documento
  firmware/sumo_esp32/      firmware: abrir o sumo_esp32.ino na Arduino IDE
    sumo_esp32.ino          arquivo principal (setup e loop)
    config.h                pinos, sensores, limiares, velocidades e tempos
    percepcao.h / .cpp      struct P, rumo, saúde e botão de start
    oponente.h / .cpp       VL53L0X: endereço, leitura, calibração e fusão
    rastreador.h / .cpp     filtro bayesiano em grade (núcleo 0)
    arena.h / .cpp          localização no dojô: filtro de partículas do centro
    chave.h / .cpp          chave DIP: estratégia e perfil do oponente
    borda.h / .cpp          TCRT5000: leitura analógica, limiar e confirmação
    estados.h / .cpp        máquina de estados com as três estratégias
    antitrava.h / .cpp      empurrão travado pela caixa do rastreador e manobras (experimental)
    ajustes.h / .cpp        opções do painel gravadas na NVS (modo autônomo, linha de lado, 5 ou 7 ToF, contagem e Wi-Fi na luta)
    motores.h / .cpp        ponte H dupla de 10 A
    cinematica.h / .cpp     cinemática das rodas e modelo do motor
    telemetria.h / .cpp     Log e entrada de comandos pela USB e, com USAR_WIFI 1, pelo WiFi
    debug.h / .cpp          comandos, calibração e stream para o painel
  painel/
    painel_sumo.html        painel completo para abrir no computador (gerado, versionado)
    painel_src.html         código fonte do painel
    vendor/                 three.js r147, OrbitControls e licença MIT
  site/                     páginas publicadas no GitHub Pages
    index.html              simulador da cinemática
    lutas.html              lutas simuladas com o firmware (os rastros saem no workflow pages.yml)
    combate.html            combate 3D com o firmware nos dois robôs (gerado, versionado, conferido no CI)
    montagem.html           montagem 3D com os jumpers (gerado, versionado, conferido no CI)
    controle_motores.html   controle dos motores pelo teclado (Web Serial), para o teste do robô parado
  cad/                      CAD final do projeto mecânico
    README.md               objetos, referencial, correspondência com o firmware e diferenças para o config.h
    stl/                    um STL por objeto da árvore do CAD (STEP LAB3-Modelagem_2) e o indice.json
  doc/
    img/                    imagens deste README
    pdf/                    gabarito_bancada.pdf, guia_montagem_sensores.pdf e guia_montagem_sensores_7.pdf
    combate/                modelo da página do combate (combate_src.html), malhas do STL, textos e bateria.json
    montagem/               modelo da página da montagem, montagem.json, pecas.js, editor.json, rotas_fios.json, interferencias.json, os STL do chassi e README.md
      modelos/              suporte do VL53L0X (STL e .scad) e módulo CJVL53L0XV2
  ferramentas/              scripts em Python que geram os arquivos versionados
    gera_painel.py          painel/painel_src.html e painel/vendor/ -> painel/painel_sumo.html
    gera_combate.py         WebAssembly, doc/combate/ -> site/combate.html
    gera_montagem.py        config.h, doc/montagem/ -> site/montagem.html (e a lista de interferências)
    confere_site.py         confere as constantes do site/index.html e os alcances dos ToF da página do combate com o config.h
    alcance_plateia.py      distância da plateia ao dojô para nenhum ToF a ler (lê o config.h)
    gera_bancada.py         config.h -> doc/pdf/gabarito_bancada.pdf
    gera_guia.py            config.h -> doc/pdf/guia_montagem_sensores(_7).pdf
    step_para_stl.py        STEP do projeto mecânico -> um STL por peça (a montagem aberta até os parafusos)
    step_por_objeto.py      STEP final -> um STL por objeto da árvore do CAD (cad/stl/)
    exporta_pecas.py        HTML do editor 3D -> doc/montagem/pecas.js e editor.json
    roteia_fios.py          peças e ligações -> doc/montagem/rotas_fios.json (caminho de cada fio)
    exporta_malhas.py       STL do robô -> doc/combate/malhas.js
    gera_modulo_cj.py       módulo CJVL53L0XV2 -> doc/montagem/modelos/cj_vl53l0x.stl
  teste/
    unidade/                testes no computador (g++), com um Arduino.h de mentira em stub/
      teste_cinematica.cpp  cinemática das rodas
      teste_estados.cpp     máquina de estados com a cinemática, a localização e a chave
      teste_autostart.cpp   partida automática (AUTO_START 1), sem botão de início
      teste_arena.cpp       testes estatísticos da localização no dojô
      teste_motores.cpp     PWM da ponte H (API do LEDC dos cores 2.x e 3.x)
      teste_wifi.cpp        servidor WiFi (USAR_WIFI 1) sobre sockets reais, com o WiFi.h de mentira em stub_wifi/
      teste_alinha.cpp      demonstração de alinhamento (comando alinha) e flags de linha ignorada e texto calado do mov e do pwm, com um mundo mínimo em volta
      teste_ajustes.cpp     opções do robô: validação, NVS de mentira e reinício da quantidade de ToF
      teste_contagem.cpp    contagem de 5 s: BOOT, giro sem andar até alinhar e modo autônomo, com a máquina de estados de verdade
      teste_borda.cpp       borda: limiar explícito da calibração de pista, janelas de mínimo e máximo e a NVS de mentira (stub/Preferences.h)
    painel/                 painel no navegador (Chromium sem tela) contra um robô de mentira pelo WiFi
      robo_falso.mjs        servidor que imita /ping, /stream e /cmd do firmware
      smoke_wifi.mjs        conexão, quadros, comandos em ordem e reconexão do painel versionado
      teste_calibracao.mjs  conta da calibração de pista (pior preto, pior branco, limiar, polaridade, D0, dados de menos), sem navegador
      smoke_calibracao.mjs  o assistente de calibração no navegador: preto, passes, tabela, histogramas, bordalim, D0, cancelar e desconectar
      smoke_demo.mjs        os cartões Alinhar com o oponente, Controle remoto (WASD) e Configuração do robô, contra o robô de mentira
      smoke_opcoes.mjs      o cartão Opções do robô: cada botão, o reinício do ToF, os avisos do regulamento e o padrão de fábrica
    sim/                    simulador de lutas com o firmware de verdade
      compila.sh            compila o simulador (teste/sim/luta)
      luta.cpp              uma luta: firmware, mundo e oponente, com resultado em CSV e rastro em JSON
      mundo.h / .cpp        física, dojô, ToF, TCRT5000 e oponentes
      hal.h / .cpp          Arduino, I2C, VL53L0X e pinos de mentira ligados ao mundo
      roda_lutas.py         bateria de lutas em paralelo, com tabela e falha no CI
      gera_rastros.py       rastros das lutas para a página
      stub/                 cabeçalhos de mentira do simulador
    combate/                combate com o mesmo firmware nos dois robôs
      compila.sh            compila o executável (nativo, com MUJOCO=1 também a física do MuJoCo), o módulo WebAssembly (wasm) ou o empurrão (empurrao)
      fisica.h / .cpp       dojô da RoboCore, apoios, rampa, pneus, motores, bateria, ToF e TCRT5000
      hal_combate.h / .cpp  Arduino de mentira para dois robôs
      fw_pre.h              cabeçalhos incluídos fora do namespace de cada robô
      fw_modulo.cpp         um módulo do firmware dentro do namespace de um robô
      ponte.h / ponte_robo.cpp  funções de cada firmware chamadas pelo simulador
      combate.h / .cpp      largada, botões, loop dos firmwares e fim do round
      main_nativo.cpp       linha de comando (resultado em CSV e rastro em JSON)
      wasm_api.cpp          funções exportadas para a página 3D
      bateria.py            bateria de lutas em paralelo, com tabela e falha no CI
      varre.py              varredura de parâmetros: variante do firmware contra o firmware atual congelado, lutas sorteadas e placar pareado
      fisica_mujoco.cpp     segunda física (MuJoCo): malhas do STEP, pneus, motores e saída do dojô (só com MUJOCO=1)
      empurrao.cpp          empurrão frente a frente, sem firmware, nas duas físicas
      compara_fisicas.py    tabela do empurrão nas duas físicas, com limites no CI
      mujoco/               malhas convexas do chassi (malhas/*.stl) e prepara_malhas.py, que as refaz do STEP
      stub/                 Preferences.h de mentira para os dois robôs
  .github/workflows/
    compilacao.yml          CI: firmware, testes no computador, lutas simuladas, combate e conferência do painel e das páginas
    pages.yml               publicação da pasta site/ no GitHub Pages, com os rastros das lutas
```

A divisão segue o que cada pasta entrega: o firmware que vai para o ESP32, o painel que abre no computador, o site que vai para o GitHub Pages, a documentação, os scripts que geram os arquivos versionados e os testes. Os arquivos gerados que ficam no repositório (painel, páginas do combate e da montagem) são conferidos pelo CI, que gera cada um de novo e falha se o versionado estiver diferente.

## Integração contínua

O workflow `.github/workflows/compilacao.yml` roda em todo pull request, inclusive os empilhados sobre outro pull request, e em todo push na `main`. Ele compila o firmware para o ESP32 Dev Module na linha 2.x (2.0.17) e na linha 3.x (3.3.0) do core da Espressif, com a biblioteca VL53L0X 1.3.1, nas versões de 5 e de 7 sensores, com os motores desligados como na bancada e também ligados e, em mais duas compilações, com o WiFi opcional ligado (`USAR_WIFI 1`), e publica o uso de flash e RAM no resumo da execução. Um segundo teste compila no computador, com o g++ e um `Arduino.h` de mentira (`teste/unidade/stub`), o `cinematica.cpp`, o `estados.cpp`, o `arena.cpp`, o `chave.cpp`, o `borda.cpp` e o `motores.cpp` do firmware e roda os testes da pasta `teste/unidade/`: os números do modelo, a prioridade para o giro, o limitador, o PWM de -255 na primeira volta da fuga da borda, o giro de recuperação, as trocas de estado com a borda aparecendo no meio do ataque e do giro, a escolha da estratégia pela chave, a fuga em cada combinação de sensores de borda, a localização no dojô nas duas geometrias (erro, coerência da incerteza e descarte) e, nos motores, o duty certo em cada pino IN com o PWM configurado uma vez só (com a API do LEDC dos cores 2.x e 3.x); o servidor WiFi também roda aqui, com o `telemetria.cpp` de verdade falando com um cliente TCP real, e a borda com o limiar da calibração de pista gravado e lido de volta; a demonstração de alinhamento roda com a máquina de estados de verdade e um mundo mínimo (oponente de lado e atrás, onde o robô tem que ficar parado, oponente dando a volta com o giro limitado, rodas girando demais ou de menos, linha marcando o tempo todo, tempo esgotado, `go` e `stop`); as opções do robô (`ajustes.cpp`, com a NVS de mentira, inclusive o Wi-Fi leve) e a contagem de 5 s (BOOT reiniciando na contagem e na luta, giro sem andar, modo autônomo ligado e desligado) rodam do mesmo jeito. Um terceiro teste compila o simulador de lutas e roda 288 lutas (3 estratégias, 6 oponentes, claro e escuro, 8 largadas) com pessoas em volta do dojô; ele falha com qualquer queda própria ou com mais de 2 s mirando algo fora do dojô numa luta, e guarda a tabela no resumo da execução e o CSV como artefato. Um quarto teste compila o simulador de combate e roda 48 lutas com o mesmo firmware nos dois robôs (3 estratégias, adversário preto e branco, 1000 e 319 rpm), falhando com qualquer queda própria, compila o mesmo código para WebAssembly e falha se o `site/combate.html` versionado for diferente da página gerada com esse WebAssembly e a bateria do `doc/combate/bateria.json`. Um quinto teste abre o `painel/painel_sumo.html` num Chrome sem tela, conecta pelo Wi-Fi num robô de mentira, confere os quadros, os comandos e a reconexão e percorre o assistente de calibração da pista (preto, dois passes, tabela, gravação por `bordalim`, aviso de D0, cancelar) e os cartões da demonstração (alinhar, WASD com teclado, botões e flags, o guia da configuração e as opções do robô, com o Wi-Fi leve cortando o stream para uns 10 quadros por segundo); a conta da calibração também roda sozinha, com dados sintéticos. Um sexto teste gera o painel de novo a partir do `painel/painel_src.html` e a página da montagem a partir do `config.h` e do `doc/montagem/montagem.json`, falha se o `painel/painel_sumo.html` ou o `site/montagem.html` versionados estiverem diferentes, e confere se as constantes da página do simulador (`site/index.html`) são as mesmas do `config.h`. Um sétimo teste instala o MuJoCo 3.16.0, compila o simulador de combate e o empurrão com ele, falha se o MuJoCo não decidir 95% dos 40 empurrões por motor em 3 s, se dois robôs iguais ficarem fora de 30% a 70% de vitórias ou se o robô levantado não perder em 85% dos empurrões, e roda uma bateria de 54 lutas com o firmware, falhando com qualquer queda própria. O workflow `pages.yml` publica as páginas no GitHub Pages a cada push na `main`, com os rastros e o placar das lutas gerados na hora; o combate e a montagem vão como estão no repositório. O GitHub Pages precisa estar ligado uma vez em Settings > Pages, com a fonte GitHub Actions.

As mudanças entram na `main` por pull request ligado a uma issue, depois dos testes passarem, sempre com merge commit. Com isso, o botão Revert de cada pull request no GitHub desfaz só aquela mudança, por meio de um pull request novo, sem reescrever o histórico. Quando vários pull requests foram empilhados, um em cima do outro, a reversão segue a ordem contrária à do merge, do mais novo para o mais antigo, porque cada um parte do anterior.

## Equipe

**Grupo D**

| Integrante | Matrícula |
|---|---|
| Ana Amantea Leal Marques Afonso | 2022055599 |
| Felipe Costa Lopes | 2018019648 |
| Luan Borges Teodoro Reis Sena | 2023060510 |
| Nathan Caldeira Silva Ramos | 2020098940 |

## Referências

DEDE, Fırat Faris. **Sumo Robot Blackbook**: robot sumo strategies, tactics to win! Istambul: JSumo, [s.d.]. E-book.

ESPRESSIF SYSTEMS. **Arduino core for the ESP32**. [S.l.]: Espressif Systems, [s.d.a]. Disponível em: https://github.com/espressif/arduino-esp32. Acesso em: 13 out. 2026.

ESPRESSIF SYSTEMS. **Set Flash Voltage**: espefuse, esptool documentation (ESP32). [S.l.]: Espressif Systems, [s.d.b]. Disponível em: https://docs.espressif.com/projects/esptool/en/latest/esp32/espefuse/set-flash-voltage-cmd.html. Acesso em: 14 out. 2026.

FLORES, Paulo; MACHADO, Margarida; SILVA, Miguel T.; MARTINS, Jorge M. On the continuous contact force models for soft materials in multibody dynamics. **Multibody System Dynamics**, v. 25, n. 3, p. 357-375, 2011. DOI: 10.1007/s11044-010-9237-4.

GROSCH, K. A. The relation between the friction and visco-elastic properties of rubber. **Proceedings of the Royal Society of London A**, v. 274, n. 1356, p. 21-39, 1963.

GRUPO D. **Slides sobre máquinas de estados**: estratégias Rush, Flank e Fan out. Belo Horizonte: UFMG, ELE635 Laboratório de Sistemas III, 2026a. Apresentação.

GRUPO D. **Projeto mecânico**: robô de sumô autônomo da classe Lego/Vex Sumô. Belo Horizonte: UFMG, ELE635 Laboratório de Projetos III, 2026b. Relatório, com os modelos 3D dos componentes eletrônicos.

HOERNER, Sighard F. **Fluid-dynamic drag**: practical information on aerodynamic drag and hydrodynamic resistance. Midland Park: Hoerner, 1965.

HOFMANN-WELLENHOF, Bernhard; MORITZ, Helmut. **Physical geodesy**. 2. ed. Viena: Springer, 2006.

INTERNATIONAL ORGANIZATION FOR STANDARDIZATION. **ISO 2533**: standard atmosphere. Genebra: ISO, 1975.

JIMENO, Juan Miguel. **linorobot2_hardware**: firmware for linorobot2 compatible robots. [S.l.]: Linorobot, 2021. Disponível em: https://github.com/linorobot/linorobot2_hardware. Acesso em: 13 out. 2026.

MORITZ, Helmut. Geodetic Reference System 1980. **Journal of Geodesy**, v. 74, n. 1, p. 128-133, 2000.

POLOLU. **VL53L0X library for Arduino**. [S.l.]: Pololu, [s.d.]. Disponível em: https://github.com/pololu/vl53l0x-arduino. Acesso em: 13 out. 2026.

RCDRONE. **JGB37-520 DC gear motor**: tabela de especificações. [S.l.]: RCDrone, [s.d.]. Disponível em: https://rcdrone.top/products/jgb37-520-dc-gear-motor. Acesso em: 13 out. 2026.

ROBOCORE. **Regras de Sumô**. São Paulo: RoboCore, [s.d.a]. Documento das regras da competição.

ROBOCORE. **Pneus S20 32 mm para roda StickyMAX (par)**. São Paulo: RoboCore, [s.d.b]. Disponível em: https://www.robocore.net/pneus-s20-32mm-para-roda-stickymax-par. Acesso em: 13 out. 2026.

ROBOCORE. **Desenho técnico do pneu StickyMAX 32 mm**: borracha de silicone amarela de 20 Shore A, versão 1.1. São Paulo: RoboCore, 2024. Desenho em PDF.

ROS-CONTROLS. **ros2_controllers**: diff_drive_controller. [S.l.]: ros-controls, [s.d.]. Disponível em: https://github.com/ros-controls/ros2_controllers. Acesso em: 13 out. 2026.

ROTH, F. L.; DRISCOLL, R. L.; HOLT, W. L. Frictional properties of rubber. **Journal of Research of the National Bureau of Standards**, v. 28, p. 439-462, 1942.

STMICROELECTRONICS. **L298**: dual full-bridge driver. Genebra: STMicroelectronics, [s.d.a]. Folha de dados.

STMICROELECTRONICS. **VL53L0X**: world's smallest time-of-flight ranging and gesture detection sensor. Genebra: STMicroelectronics, [s.d.b]. Folha de dados.

THREE.JS. **three.js r147**. [S.l.]: three.js authors, 2022. Disponível em: https://github.com/mrdoob/three.js. Acesso em: 13 out. 2026.

THRUN, Sebastian; BURGARD, Wolfram; FOX, Dieter. **Probabilistic Robotics**. Cambridge: MIT Press, 2005.

TODOROV, Emanuel; EREZ, Tom; TASSA, Yuval. MuJoCo: a physics engine for model-based control. In: IEEE/RSJ INTERNATIONAL CONFERENCE ON INTELLIGENT ROBOTS AND SYSTEMS, 2012, Vilamoura. **Anais** [...]. Piscataway: IEEE, 2012. p. 5026-5033. DOI: 10.1109/IROS.2012.6386109.

WPILIB. **WPILib**: SimpleMotorFeedforward. [S.l.]: FIRST e WPILib, [s.d.]. Disponível em: https://github.com/wpilibsuite/allwpilib. Acesso em: 13 out. 2026.

ZIG SOFTWARE FOUNDATION. **Zig 0.14.0**: compilador C e C++ para WebAssembly (wasm32-wasi). [S.l.]: Zig Software Foundation, 2025. Disponível em: https://ziglang.org. Acesso em: 14 out. 2026.
