felcoslop/LAB_III_Grupo_D_UFMG_2026_2/cad/stl/esp32_wroom_32D_kitV1.stl

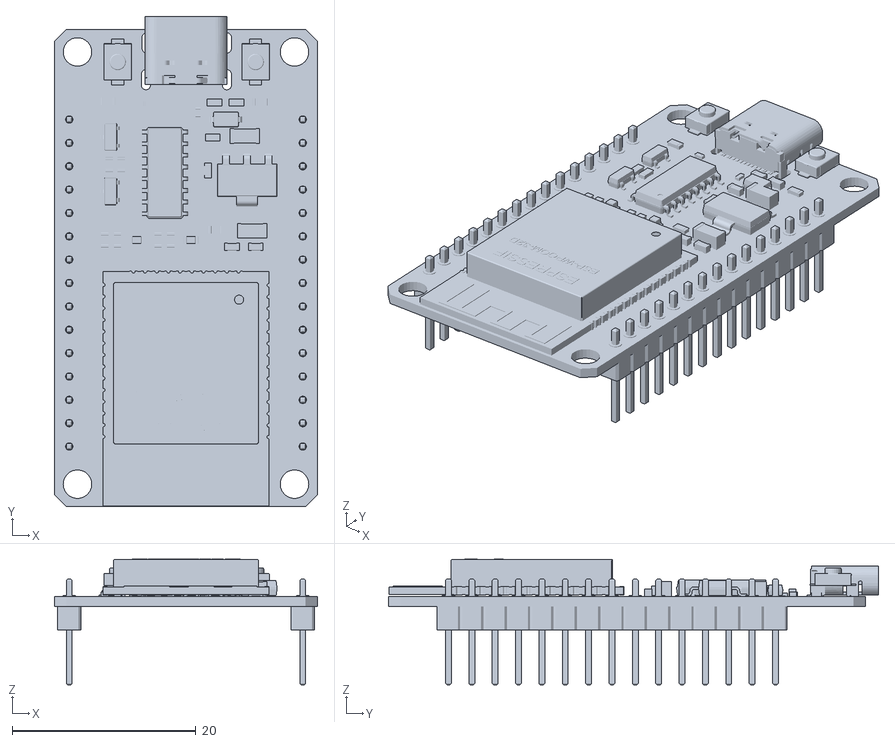
[picture p6: CAD file, 2026-10-20]
cad/stl/esp32_wroom_32D_kitV1.stl
28.6 x 53.3 x 13.7
