felcoslop/LAB_III_Grupo_D_UFMG_2026_2/doc/montagem/modelos/chassi/Lateral_R.stl

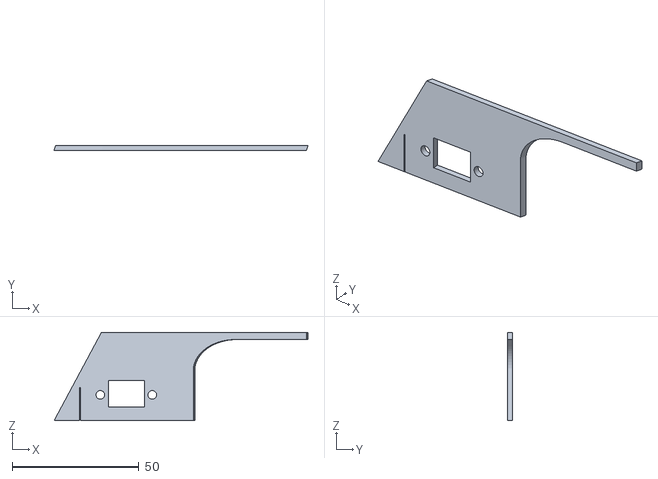
[picture p7: CAD file, 2026-10-20]
doc/montagem/modelos/chassi/Lateral_R.stl
100.2 x 2.00 x 34.9
