felcoslop/LAB_III_Grupo_D_UFMG_2026_2/cad/stl/Haste_R.stl

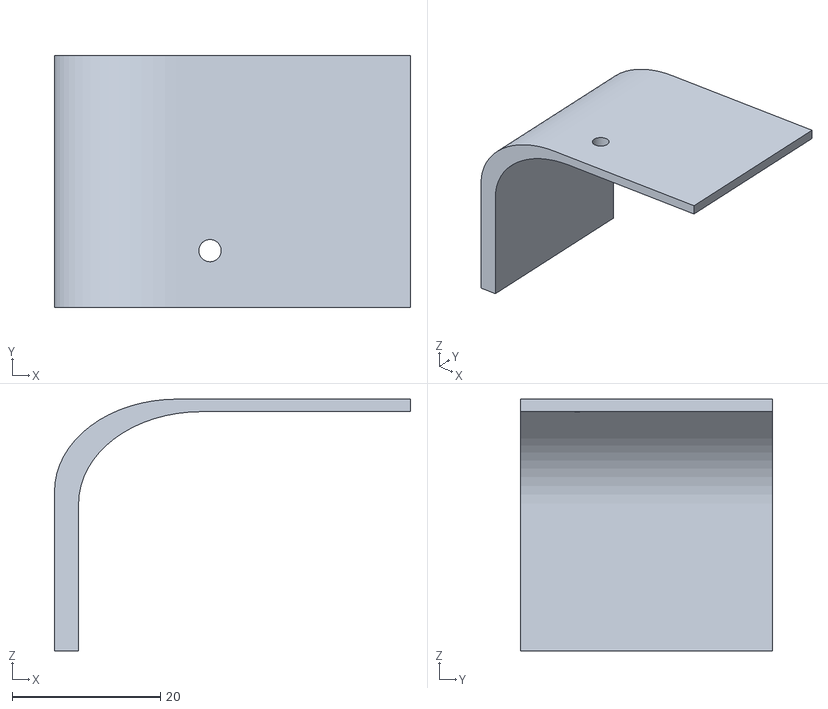
[picture p9: CAD file, 2026-10-20]
cad/stl/Haste_R.stl
48.0 x 34.0 x 33.9
