felcoslop/LAB_III_Grupo_D_UFMG_2026_2/doc/montagem/modelos/chassi/Suporte_160_R.stl

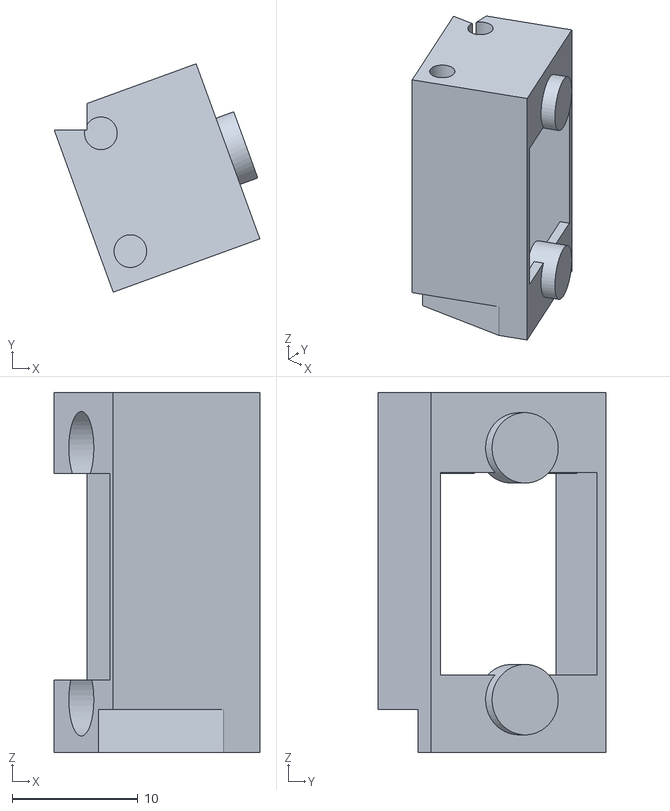
[picture p10: CAD file, 2026-10-20]
doc/montagem/modelos/chassi/Suporte_160_R.stl
16.3 x 18.1 x 28.6
