felcoslop/LAB_III_Grupo_D_UFMG_2026_2/teste/combate/mujoco/malhas/rampa2.stl

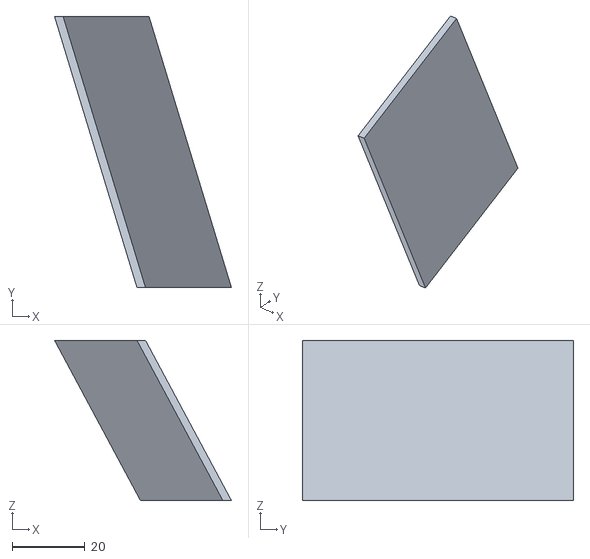
[picture p11: CAD file, 2026-10-16]
teste/combate/mujoco/malhas/rampa2.stl
48.6 x 74.5 x 44.0
