felcoslop/LAB_III_Grupo_D_UFMG_2026_2/cad/stl/SS_TR.stl

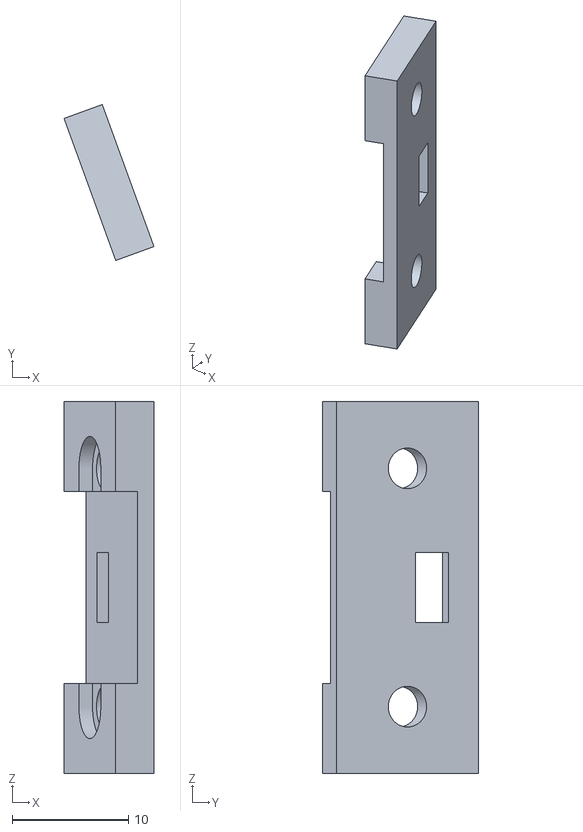
[picture p12: CAD file, 2026-10-20]
cad/stl/SS_TR.stl
7.74 x 13.4 x 32.0
