felcoslop/LAB_III_Grupo_D_UFMG_2026_2/doc/montagem/modelos/chassi/Suporte_L.stl

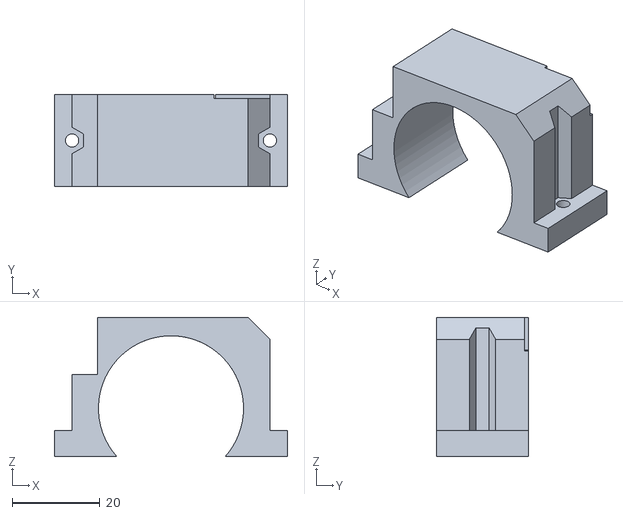
[picture p13: CAD file, 2026-10-20]
doc/montagem/modelos/chassi/Suporte_L.stl
53.0 x 21.0 x 31.7
