felcoslop/LAB_III_Grupo_D_UFMG_2026_2/teste/combate/mujoco/malhas/latR.stl

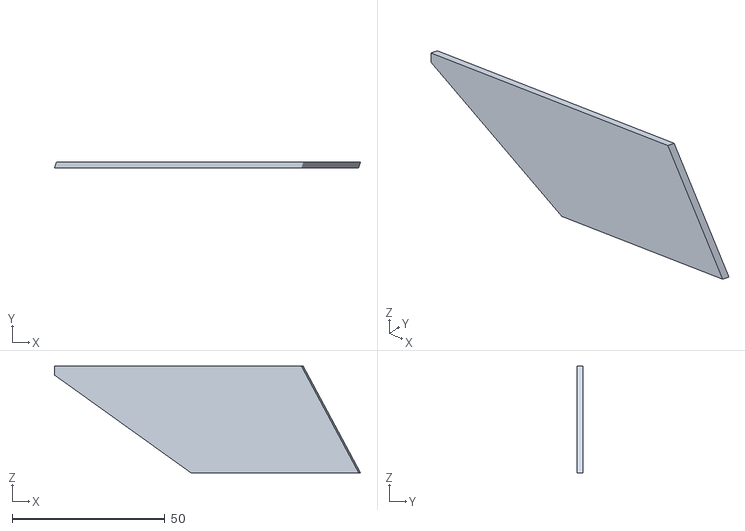
[picture p14: CAD file, 2026-10-16]
teste/combate/mujoco/malhas/latR.stl
100.2 x 2.00 x 34.9
