felcoslop/LAB_III_Grupo_D_UFMG_2026_2/doc/montagem/modelos/chassi/Frente1.stl

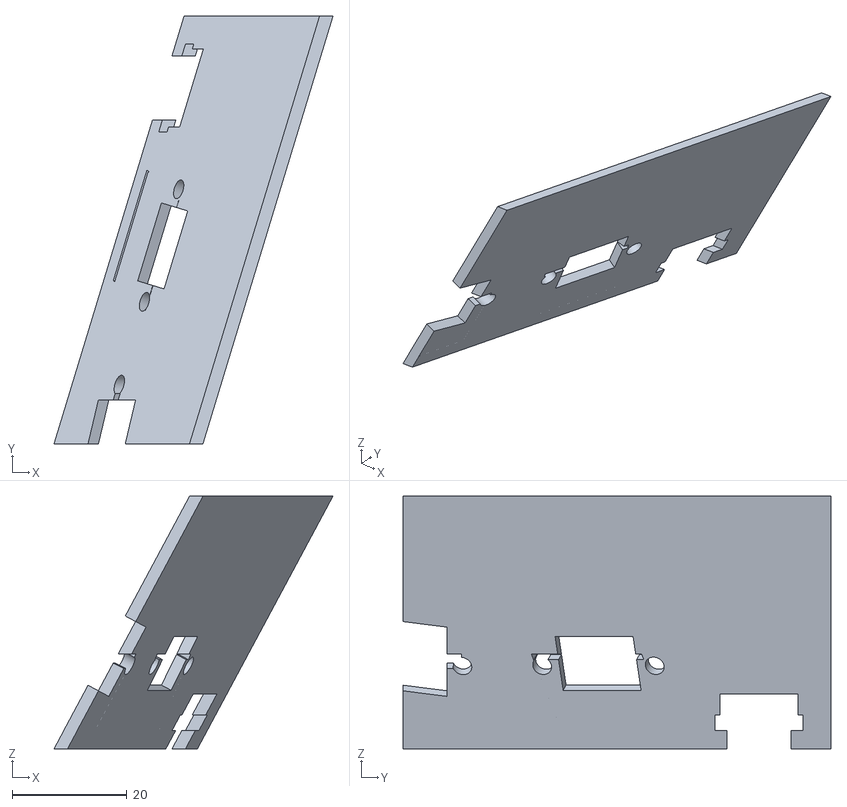
[picture p15: CAD file, 2026-10-20]
doc/montagem/modelos/chassi/Frente1.stl
48.6 x 74.5 x 44.0
