felcoslop/LAB_III_Grupo_D_UFMG_2026_2/cad/stl/expansion_board_esp_32_shield_CAD211.stl

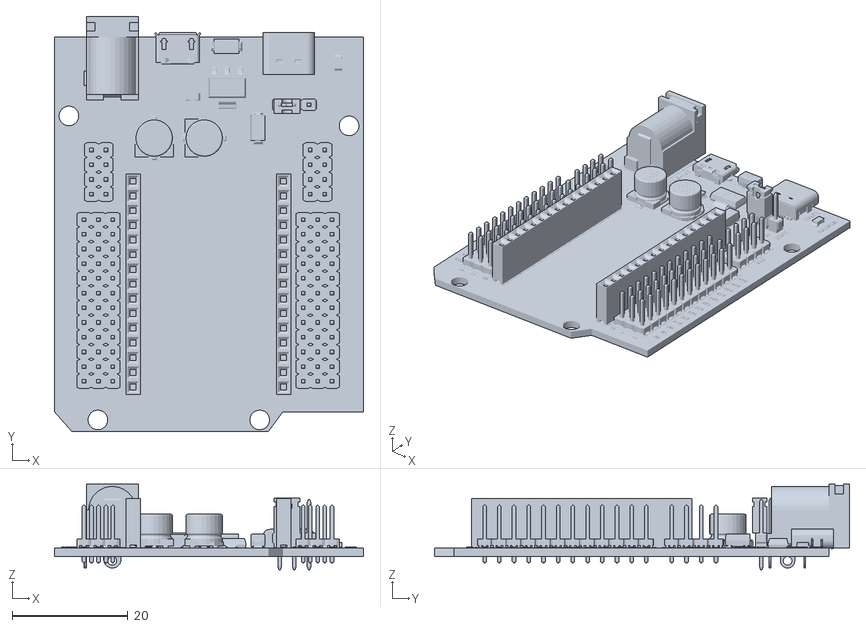
[picture p16: CAD file, 2026-10-20]
cad/stl/expansion_board_esp_32_shield_CAD211.stl
53.4 x 71.7 x 14.8
