felcoslop/LAB_III_Grupo_D_UFMG_2026_2/doc/montagem/modelos/chassi/Haste_R.stl

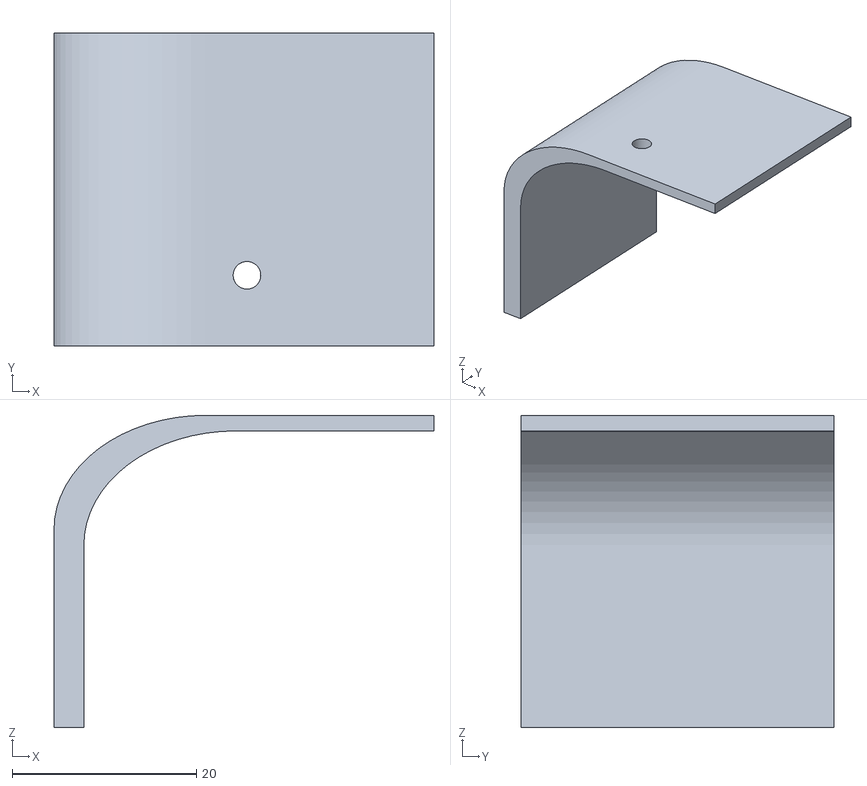
[picture p18: CAD file, 2026-10-20]
doc/montagem/modelos/chassi/Haste_R.stl
41.3 x 34.0 x 33.9
