felcoslop/LAB_III_Grupo_D_UFMG_2026_2/cad/stl/SS_FL.stl

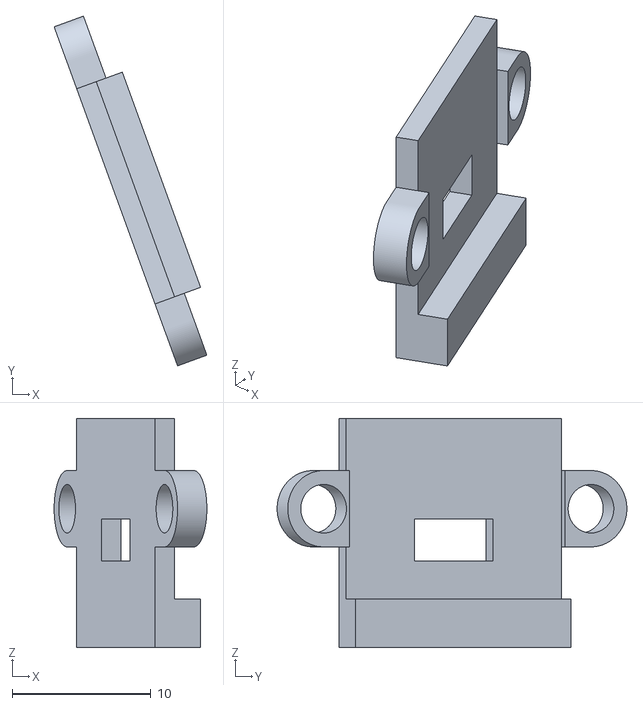
[picture p20: CAD file, 2026-10-20]
cad/stl/SS_FL.stl
11.0 x 25.2 x 16.5
