felcoslop/LAB_III_Grupo_D_UFMG_2026_2/doc/montagem/modelos/chassi/Calco_V.stl

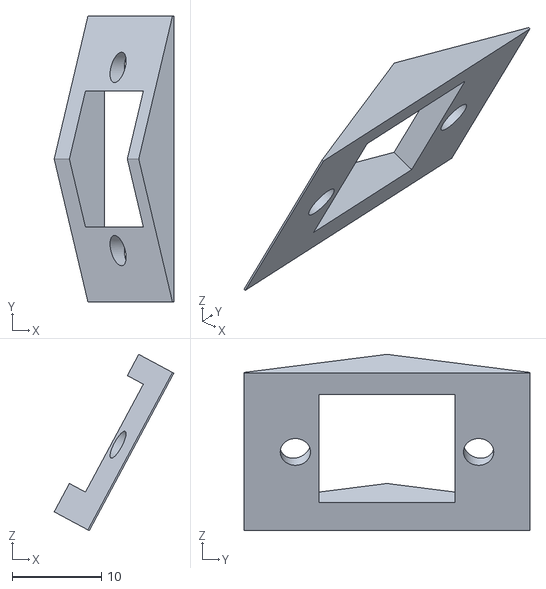
[picture p21: CAD file, 2026-10-20]
doc/montagem/modelos/chassi/Calco_V.stl
13.4 x 32.0 x 19.7
