felcoslop/LAB_III_Grupo_D_UFMG_2026_2/cad/stl/Roda_Motor_D.stl

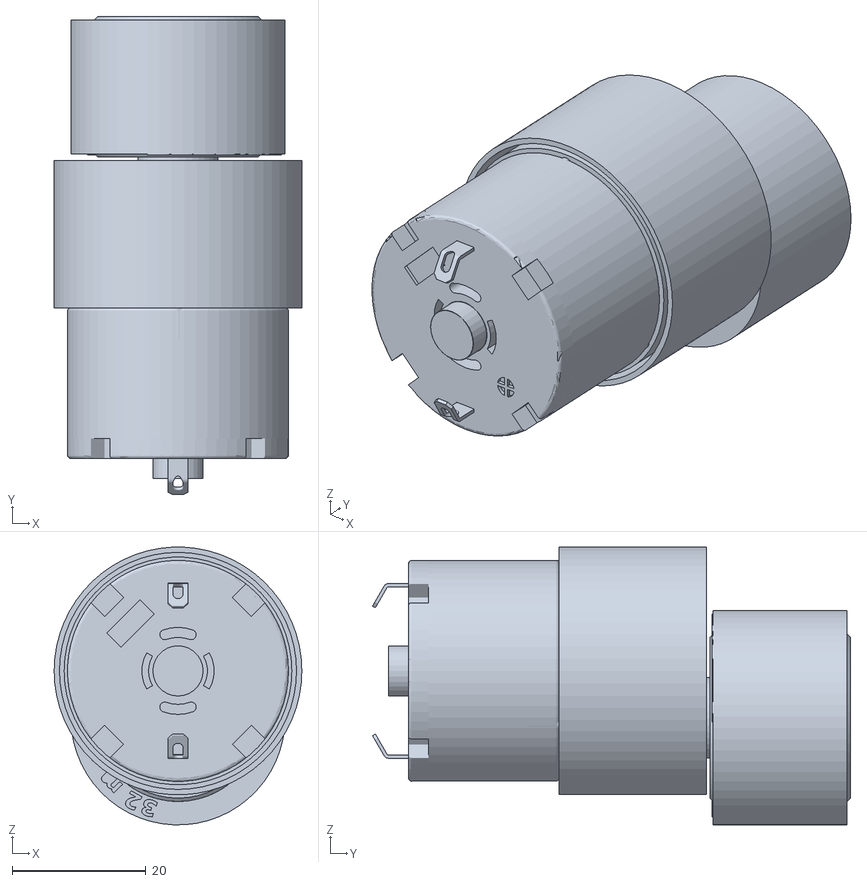
[picture p22: CAD file, 2026-10-20]
cad/stl/Roda_Motor_D.stl
37.0 x 71.4 x 41.5
