felcoslop/LAB_III_Grupo_D_UFMG_2026_2/cad/stl/Base.stl

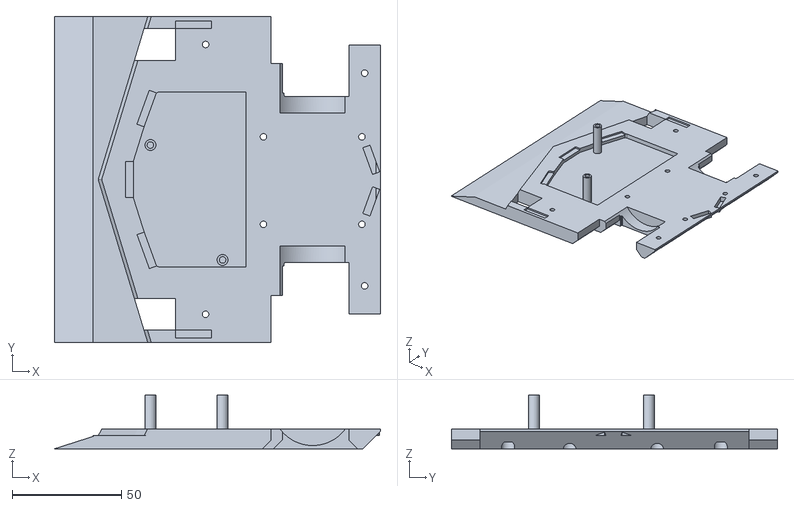
[picture p23: CAD file, 2026-10-20]
cad/stl/Base.stl
149.0 x 149.0 x 24.5
