felcoslop/LAB_III_Grupo_D_UFMG_2026_2/cad/stl/Lateral_L.stl

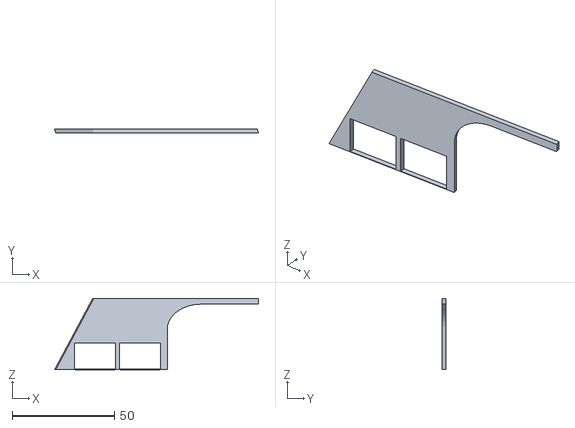
[picture p24: CAD file, 2026-10-20]
cad/stl/Lateral_L.stl
100.0 x 2.00 x 35.0
