felcoslop/LAB_III_Grupo_D_UFMG_2026_2/cad/stl/Suporte_R.stl

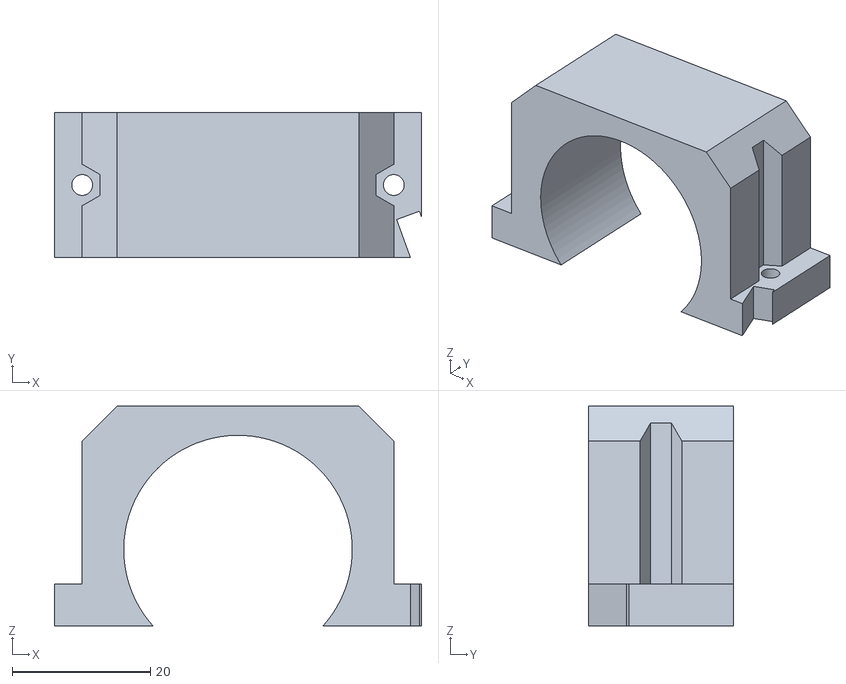
[picture p25: CAD file, 2026-10-20]
cad/stl/Suporte_R.stl
53.0 x 21.0 x 31.7
