felcoslop/LAB_III_Grupo_D_UFMG_2026_2/cad/stl/SS_R.stl

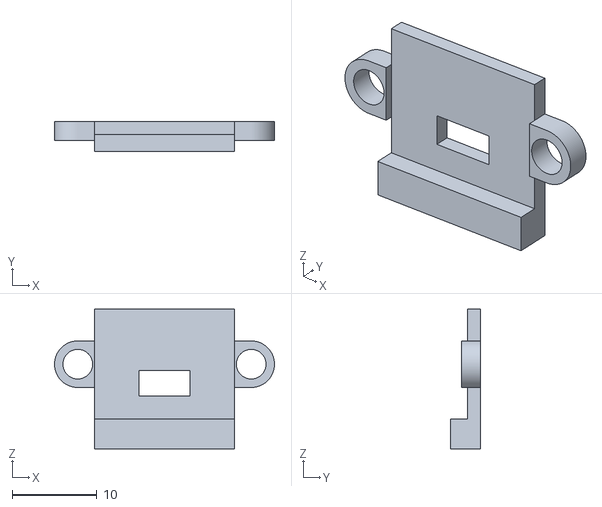
[picture p26: CAD file, 2026-10-20]
cad/stl/SS_R.stl
26.0 x 3.50 x 16.5
