felcoslop/LAB_III_Grupo_D_UFMG_2026_2/cad/stl/Topo.stl

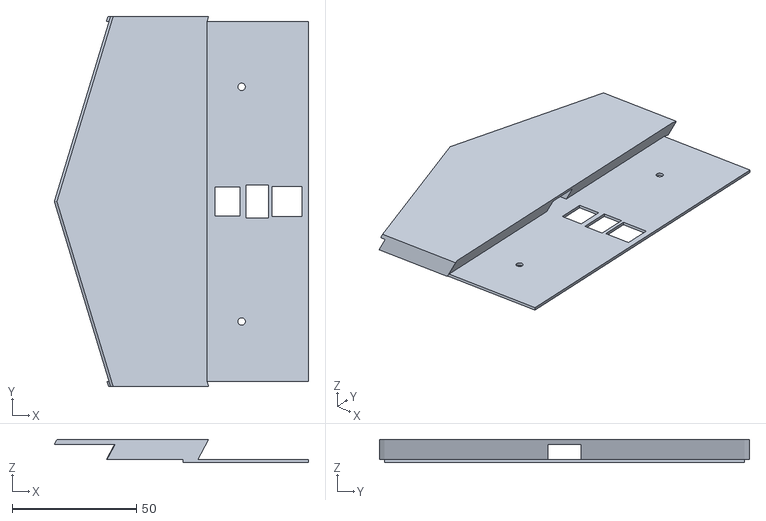
[picture p27: CAD file, 2026-10-20]
cad/stl/Topo.stl
102.5 x 149.0 x 9.30
