felcoslop/LAB_III_Grupo_D_UFMG_2026_2/cad/stl/Lateral_R.stl

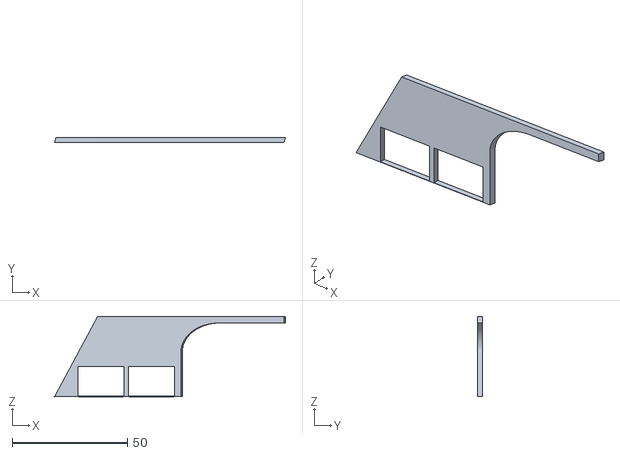
[picture p29: CAD file, 2026-10-20]
cad/stl/Lateral_R.stl
100.2 x 2.00 x 34.9
