felcoslop/LAB_III_Grupo_D_UFMG_2026_2/cad/stl/Linha_RF.stl

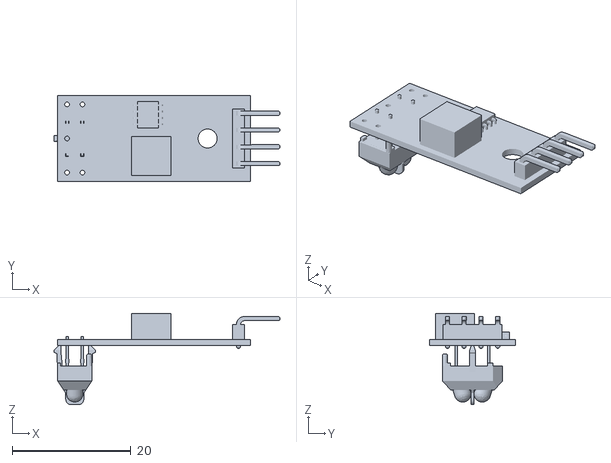
[picture p30: CAD file, 2026-10-20]
cad/stl/Linha_RF.stl
38.1 x 14.5 x 15.4
