felcoslop/LAB_III_Grupo_D_UFMG_2026_2/(list of files, cad)

Other CAD files:
cad/stl/SS_TL.stl
doc/montagem/modelos/chassi/Suporte_160_L.stl
doc/montagem/modelos/chassi/Lateral_L.stl
cad/stl/SS_FR.stl
cad/stl/Roda_Motor_L.stl
cad/stl/SS_FM.stl
cad/stl/Linha_R.stl
cad/stl/SS_L.stl
cad/stl/Linha_L.stl
cad/stl/Suporte_L.stl
cad/stl/Haste_L.stl
