felcoslop/LAB_III_Grupo_D_UFMG_2026_2/doc/montagem/modelos/LEIA-ME.md

# Modelos 3D usados só na montagem

- `vl53l0x-bracket.stl` e `vl53l0x-bracket.scad`: suporte de PLA para o módulo VL53L0X, de TOBI
  (Cults3D, "Mounting bracket for VL53L0X module", 2022). Placa de 32 x 20 x 3,5 mm, rebaixo de
  16,5 x 13 mm para o módulo CJVL53L0XV2, furos M3 e janela de 6 x 3 mm. Os 7 sensores de oponente
  usam este suporte na página da montagem, que segue o editor 3D v11. O arquivo é de terceiros: antes
  de publicar o repositório, confirmar a licença na página do modelo e manter o crédito. O CAD final
  do projeto mecânico traz suportes próprios para os sete sensores (`SS_*`, em `cad/stl/`); quando a
  página migrar para o CAD final, este suporte de terceiros deixa de ser usado.
- `cj_vl53l0x.stl`: modelo simplificado do módulo dentro do suporte, gerado por `ferramentas/gera_modulo_cj.py`.
