felcoslop/LAB_III_Grupo_D_UFMG_2026_2/site/montagem.html

### UFMG · ELE635 · Grupo D · robô de sumô de 1 kg

# Montagem do robô com os jumpers

Cada componente encaixado no chassi e cada fio do esquema elétrico, com a ponta de cada jumper: fêmea nos pinos machos dos módulos, macho nos furos da protoboard de 81 x 55 mm onde o ESP32 está encaixado; a chave DIP e o botão de ligar ficam nos furos da tampa de trás. Os sete VL53L0X vão no suporte de PLA Mounting Bracket for VL53L0X Module. Os sensores ficam nas posições do config.h e os GPIOs de cada fio também saem dele, então a página acompanha o firmware.

grade de 10 mm

### Jumpers e fios

### Fio escolhido

Passe o mouse ou toque num fio, ou numa linha da tabela.

### Pontas dos jumpers

### Fios

### Peças

## Ligações

Ordem do esquema elétrico, agrupada por função. O comprimento é o do caminho desenhado, com as pontas; a compra arredonda para o tamanho comercial com 15% de folga.

## Jumpers para comprar

## Interferências

Peças que ocupam o mesmo lugar (sobreposição de mais de 3 mm, em voxels de 1,5 mm). Encostar uma na outra não conta.

## Diferenças entre o Fritzing e o firmware

O esquema do Fritzing (SUMO_Esquemático e SUMO_bb) e o documento de ligação (Lab3-Liga) não dizem a mesma coisa em alguns pontos. A montagem segue o firmware, que segue o Lab3-Liga.

## Quando os STL finais chegarem

1. Coloque os STL do chassi numa pasta e os dos componentes em outra (os nomes ficam no doc/montagem/montagem.json, bloco modelos).
2. Rode python ferramentas/exporta_pecas.py PASTA_DO_CHASSI PASTA_DOS_COMPONENTES, que refaz o doc/montagem/pecas.js.
3. Ajuste pos e rot de cada peça no bloco pecas do mesmo arquivo; os sensores saem sozinhos do config.h.
4. Rode python ferramentas/gera_montagem.py e confira a tabela de interferências até ela ficar vazia.
