felcoslop/LAB_III_Grupo_D_UFMG_2026_2/firmware/sumo_esp32/estados.h

// estados.h
// Máquina de estados do robô. A estratégia lê somente a percepção P (percepcao.h) e
// manda comandos para a cinemática (cinematica.h); não existe acesso direto a sensor aqui.
#pragma once
#include <Arduino.h>
#include "chave.h"

enum Estado : uint8_t {
  ESPERA,        // parado, aguardando o start
  CONTAGEM,      // 5 s parado, como manda a regra
  BUSCA,         // ninguém à vista: volta ao centro do dojô e procura (giro ou leque, conforme a estratégia)
  MIRA,          // oponente visto fora do centro: correção do ângulo
  ATAQUE,        // oponente centrado: o robô empurra com o torque todo
  FLANCO,        // estratégia Flank: curva para chegar pela lateral do oponente
  ATAQUE_RE,     // oponente colado atrás: o robô empurra de ré, sem gastar tempo girando na frente dele
  DESTRAVA,      // giro preso pelo oponente encostado: o robô solta a quina e volta a mirar
  RECUO,         // borda na frente: o robô recua enquanto vê branco e mais uma folga
  GIRO_BORDA,    // giro para o centro do dojô sem deixar de vigiar o oponente
  AVANCO_BORDA,  // borda atrás (robô sendo empurrado): o robô avança enquanto vê branco e mais uma folga
  SAIDA_LATERAL, // borda em um lado inteiro: curva para dentro apoiada na roda de dentro
  LEQUE,         // estratégia Fan out: chegada no oponente em zigue-zague, com o rumo indo de um lado para o outro
  N_ESTADOS      // quantidade de estados, usada no tamanho do vetor de nomes
};

void        estados_init();
void        estados_passo();          // uma chamada por volta do loop, depois de percepcao_atualiza()
void        estados_iniciar();        // mesmo efeito do botão de start (comando "go")
void        estados_parar();          // retorno para ESPERA (comando "stop")
// flags dos testes mov e pwm (4º número do comando): TESTE_IGNORA_BORDA 1 não encerra o teste ao ver a linha branca
// (controle remoto do painel, que vale com a linha marcando ou não); TESTE_QUIETO 2 não escreve as linhas "# mov" e
// "# pwm" (o controle por teclado manda um teste a cada 120 ms)
enum : uint8_t { TESTE_IGNORA_BORDA = 1, TESTE_QUIETO = 2 };
void        estados_teste_mov(float v_mms, float w_dps, uint16_t ms, uint8_t flags = 0);   // movimento de teste em ESPERA (comando "mov")
void        estados_teste_pwm(int8_t esq_pct, int8_t dir_pct, uint16_t ms, uint8_t flags = 0); // PWM direto em cada roda (comando "pwm")
bool        estados_teste_ativo();    // true durante um teste mov ou pwm
// Demonstração de alinhamento (comando "alinha", config.h ALINHA_*): em ESPERA, só gira no lugar em pulsos até o oponente
// ficar centrado; não anda, ignora a linha, não busca às cegas e gira no máximo ALINHA_GIRO_MAX_DEG para cada lado.
// Fase: 0 desligado, 1 sem oponente ao alcance (a contagem de 5 s busca em pulsos; a demonstração fica parada), 2 virando,
// 3 alinhado.
void        estados_alinha(bool liga, uint16_t segundos);
bool        estados_alinha_ativo();
uint8_t     estados_alinha_fase();
float       estados_alinha_erro();    // graus até o oponente na última decisão (positivo é esquerda)
uint16_t    estados_alinha_restante_s();
uint16_t    estados_alinha_pulsos();  // pulsos de giro dados desde que ligou
float       estados_alinha_giro();    // giro estimado desde que ligou, graus (positivo é esquerda)
uint16_t    estados_alinha_limite();  // limite do giro de cada lado na demonstração (ALINHA_GIRO_MAX_DEG); 0 na contagem (que busca)
Estado      estado_atual();
const char* estado_nome(Estado e);
Estrategia  estados_estrategia();     // estratégia em uso (travada no start)
bool        estados_escuro();         // perfil de oponente em uso (travado no start)
// Travamento: 0 livre, 1 empurrão em contato há mais de T_TRAVA_MS, 2 giro preso (DESTRAVA),
// 3 manobra do empurrão travado em andamento (antitrava.h)
uint8_t     estados_travado();
uint16_t    estados_destravas();      // manobras DESTRAVA nesta luta
