felcoslop/LAB_III_Grupo_D_UFMG_2026_2/(commit log)

2026-10-08 ci: adiciona compilação do firmware e conferência do painel
    Compila o sketch para o ESP32 Dev Module nas linhas 2.x e 3.x do core
    da Espressif, com a biblioteca VL53L0X 1.3.1, e publica o uso de flash
    e RAM no resumo da execução. Um segundo job gera o painel a partir do
    doc/painel_src.html e falha se o painel_sumo.html estiver desatualizado.
2026-10-08 refactor(telemetria): remove WiFi, servidor HTTP e painel embutido
    O robô compete de forma autônoma, então o firmware deixa de ligar o
    rádio. Saem o servidor HTTP, o stream por Server-Sent Events, o mDNS,
    o comando wifi e o src/painel_gz.h com o painel comprimido. A
    telemetria passa a sair só pela USB, com o mesmo protocolo de linhas.
    Com isso a pilha do WiFi não disputa mais o núcleo 0 com o rastreador,
    e a flash e a RAM usadas por ela ficam livres.
2026-10-08 refactor(painel): remove a conexão WiFi do painel
    O painel passa a conectar só pela USB (Web Serial) ou a rodar no modo
    demo. O gera_painel.py deixa de criar o src/painel_gz.h e grava o HTML
    sempre com fim de linha LF, para o CI poder comparar o arquivo.
2026-10-08 feat(sensores): permite escolher entre 5 e 7 sensores de oponente
    A constante QTD_TOF do config.h (padrão 5) liga um par de sensores nas
    quinas de trás, TE e TD, apontando a ±160 graus. A frente continua com
    FE, FC e FD e as laterais com LE e LD, sem nenhuma mudança, e o FC segue
    sozinho no centro decidindo o ataque. O total continua ímpar, como pede
    o capítulo 2 do Sumo Robot Blackbook.
    O par novo usa os XSHUT nos GPIOs 33 e 15 e os endereços 0x35 e 0x36,
    e fica no fim da tabela para os 5 sensores antigos manterem pino,
    endereço, cor no painel e calibração gravada. Outro valor de QTD_TOF
    interrompe a compilação.
    Com QTD_TOF 5 os objetos compilados são idênticos aos da main,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
2026-10-08 ci: compila também a versão de 7 sensores
    A matriz do job de firmware passa a cruzar as linhas 2.x e 3.x do core
    com QTD_TOF 5 e 7, usando compiler.cpp.extra_flags.
2026-10-08 docs(montagem): guia de montagem com 7 sensores
    O gera_guia.py aceita --sensores 5 ou 7 e lê as tabelas do config.h
    pela pasta do próprio script. A versão de 7 mantém as três páginas do
    guia original (gabarito do robô, mapa de ligação e tabela fio a fio com
    conferência) e acrescenta o gabarito 1:1 da bancada com TE e TD e uma
    página com a pinagem completa do ESP32, os diagramas de cobertura das
    três opções estudadas e a tabela da simulação que justifica o par atrás.
    O guia de 5 sensores foi gerado de novo com o mesmo script, que agora
    segue o padrão de texto do projeto; os desenhos e as ligações não
    mudam. O gera_bancada.py também passa a usar caminhos relativos e a
    ig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
2026-10-08 docs: README com a escolha entre 5 e 7 sensores
    A seção de posição dos sensores explica o critério do Blackbook, o
    ponto cego que existia atrás e compara, na mesma simulação, os 5
    sensores de hoje, o par nas diagonais da frente e o par nas quinas de
    trás. A tabela de pinos e a da bancada ganham TE e TD.
2026-10-13 ci: roda em pull request empilhado e compila com os motores ligados
    O workflow passa a rodar em todo pull request, e não só nos que vão
    para a main, para cobrir pull requests empilhados sobre outro. A matriz
    ganha duas combinações com USAR_MOTORES 1, uma em cada linha do core,
    para o código da ponte H também passar pela compilação. O USAR_MOTORES
    do config.h aceita o valor vindo da compilação.
2026-10-13 feat(pinagem): pinagem da placa nova com a ponte H L298N
    Os pinos seguem o documento de ligação da placa nova (Lab3-Liga) e o
    esquema do Fritzing:
    - XSHUT LE/FE/FC/FD/LD nos GPIOs 17/23/19/18/5 e TE/TD nos 16/4;
    - borda BTE/BTD nos GPIOs 32/33 (BFE/BFD continuam no 34/35);
    - L298N com IN1/IN2 nos GPIOs 25/26 (motor esquerdo) e IN3/IN4 nos
    27/13 (motor direito), com os jumpers de ENA e ENB no lugar.
    O motores.cpp passa a acionar o L298N com o PWM no próprio pino IN, no
    modo acionar e frear. A chave TROCA_MOTORES corrige os motores trocados
    de saída sem mexer nos fios.
    O botão de start vai para o GPIO 0, o mesmo do botão BOOT, porque o 32
    agora é da borda. O LED de status fica desli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
2026-10-13 docs(pinagem): README e guias com a pinagem da placa nova
    A tabela de pinos do README, a tabela da bancada e o diagrama passam
    para a placa nova com o L298N, com os cuidados da chave DIP no boot
    (DIP 1 no GPIO 12 desligada ao ligar e DIP 3 no GPIO 2 desligada ao
    gravar) e o aviso de que a borda precisa do fio no A0 dos módulos.
    Os PDFs dos guias e do gabarito da bancada foram gerados de novo.
2026-10-13 feat(cinematica): cinemática das rodas com o modelo do JGB37-520 e do L298N
    A máquina de estados passa a pedir avanço em mm/s e giro em graus/s, e
    o módulo novo cinematica.cpp transforma o pedido no PWM de cada roda:
    - desaturação com prioridade para o giro (a mira nunca se perde);
    - limitador de aceleração de 6 m/s² nas manobras normais, no estilo do
    SpeedLimiter do diff_drive_controller (ros2_controllers);
    - cinemática inversa vE = v - w.B/2 e vD = v + w.B/2;
    - feed-forward kS + kV.v + kA.a do SimpleMotorFeedforward do WPILib,
    com kS e kV tirados da tabela do motor (1,5 V de partida e 319 rpm
    livre a 12 V), bateria 3S e 1,5 V de queda no L298N.
    O modelo ao contrário estim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
2026-10-13 test: testes da cinemática e da máquina de estados no computador
    A pasta teste/ tem um Arduino.h de mentira e dois programas que o g++
    compila junto com o cinematica.cpp e o estados.cpp do firmware. Os
    testes conferem os números do modelo, a prioridade para o giro, o
    limitador, o PWM de -255 já na primeira volta da fuga da borda, o giro
    de 135 graus na recuperação, as trocas de estado com a borda aparecendo
    no meio do ataque e do giro e o comando mov. O CI ganha um job que roda
    os dois programas com -Werror.
2026-10-13 docs: README com a cinemática das rodas e as referências
    Seção nova com o modelo do motor, as etapas do pedido até o PWM, a
    tabela de cada estado em avanço e giro, a conta da parada na borda e o
    acerto do modelo com o robô montado (comandos cin e mov). O README
    ganha também a lista de referências de todas as citações.
2026-10-13 feat(motores): ponte H dupla de 10 A e comando pwm para conferir os fios
    O esquema da placa mostra um L298N, mas o módulo usado é uma ponte H
    dupla de 10 A (3 a 18 V, entradas GND e IN1 a IN4), de MOSFET, que
    aceita PWM de até 2 kHz. O acionamento continua o mesmo (PWM no IN do
    sentido e o outro em LOW), com o PWM de 1 kHz padrão do analogWrite nos
    cores 2.x e 3.x.
    A queda na ponte cai de 1,5 V para cerca de 0,2 V, então o modelo sobe
    para 478 mm/s e 415 graus/s, e a parada na borda no pior caso vai para
    38 mm (a margem continua 85 mm). Os giros da mira e da borda sobem para
    370 graus/s e a busca para 200 graus/s e 240 mm/s, mantendo as mesmas
    proporções do giro e da velocidade máxi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
2026-10-14 fix(motores): PWM do LEDC configurado uma vez só
    No core 2.x, cada analogWrite refaz a configuração do timer do LEDC, e essa
    configuração zera o contador do PWM. O loop roda em microssegundos (sem
    sensores, mais rápido ainda), bem abaixo do período de 1 ms do PWM, e com o
    contador zerado em toda volta o sinal nos pinos IN deixava de seguir o
    comando: no teste pwm 30 30 1000 um motor girava e o outro quase não andava.
    O motores_init() agora configura o LEDC uma vez (ledcSetup e ledcAttachPin no
    core 2.x, ledcAttach no core 3.x), e cada comando só troca o duty, e só
    quando ele muda. A frequência fica no config.h (PWM_MOTOR_HZ, 1 kHz).
    O teste teste/teste_motores.cpp confere no com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
2026-10-14 docs(motores): módulo HW-956, limite de 2 kHz e inversão de sentido
    O módulo da ponte H é o HW-956 (v0.0.2). O anúncio dele aceita sinal de
    3,3 V, limita o PWM a 2 kHz e pede parada antes de inverter o sentido, por
    causa do pico de corrente. Com o JGB37-520 esse pico fica perto de 2,4 A
    por motor na inversão em velocidade máxima, bem abaixo dos 10 A do módulo,
    e a fuga da borda continua invertendo na hora. Um static_assert no
    motores.cpp para a compilação se o PWM_MOTOR_HZ passar de 2 kHz.
2026-10-14 feat(site): simulador da cinemática no GitHub Pages
    A página do simulador, que roda no navegador as mesmas contas do
    cinematica.cpp e da máquina de estados, entra no repositório em
    doc/site/index.html. O workflow pages.yml publica a página no GitHub Pages
    a cada push na main que mexa em doc/site, e o doc/confere_site.py, rodado
    no CI em todo pull request e antes de cada publicação, falha quando alguma
    constante da página fica diferente do config.h. O README ganha a seção
    "Simulador na web", com o link e uma imagem da página.
2026-10-14 feat: estratégias na chave DIP, perfil escuro e localização no dojô
    Chave DIP (chave.cpp): as vias 1 a 3 escolhem Rush, Flank ou Fan out e
    a via 4 escolhe o perfil do oponente escuro. A leitura tem filtro de
    30 ms e a escolha fica travada no start; os comandos "estrategia" e
    "perfil" passam por cima da chave na bancada.
    Perfil escuro: 33 ms por medida, limite de sinal de 0,10 MCPS e pulsos
    longos nos VL53L0X, com o modelo de ruído do rastreador ajustado. O
    perfil claro continua igual ao de antes.
    Localização no dojô (arena.cpp): filtro de partículas do centro do
    dojô com o modelo das rodas e a borda, 600 partículas com erro de
    escala próprio, modelo do branco com cauda larga e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
2026-10-14 feat(painel): estratégia, perfil e localização no painel
    O painel recebe a linha A do stream (estratégia, perfil, chave DIP,
    localização, aproximação e contato), mostra a estratégia em uso e
    desenha o dojô estimado no radar. Alcance de 600 mm no radar.
2026-10-14 test(sim): simulador de lutas com o firmware de verdade
    teste/sim compila os módulos do firmware com um mundo simulado (física
    das rodas, VL53L0X com cone e sinal, TCRT5000 e seis tipos de
    oponente) e roda lutas inteiras com a largada da CoRA, com ou sem
    pessoas paradas em volta do dojô.
    compila.sh gera teste/sim/luta; roda_lutas.py roda baterias em
    paralelo, mostra a tabela por estratégia e oponente e falha com queda
    própria ou perseguição de objeto fora do dojô (--exige);
    gera_rastros.py grava os rastros das lutas para a página.
2026-10-14 ci: bateria de lutas no CI e página das lutas no GitHub Pages
    O job "Lutas simuladas" roda 288 lutas (3 estratégias, 6 oponentes,
    claro e escuro, 8 largadas) com pessoas em volta do dojô e falha com
    queda própria ou mais de 2 s mirando algo fora do dojô numa luta.
    A página lutas.html mostra as lutas com o firmware: robôs, caminho,
    dojô estimado, oponente estimado, estado e PWM. O pages.yml gera os
    rastros e o placar na publicação e passa a rodar em todo push na main.
    A página da cinemática ganha o alcance de 600 mm e os estados novos.
2026-10-14 feat: giro preso, empurrão travado e modelo térmico dos motores
    Giro preso: na mira com o oponente aberto, a cinemática estima mais de
    90 graus de giro em 0,6 s e o ângulo do oponente melhora menos de 15
    graus (quina do oponente encostado na lateral segurando a do robô). O
    estado novo DESTRAVA dá ré reta por 250 ms com espaço atrás, ou avanço
    reto sem espaço, e volta à mira; uma ré que bate na borda de trás faz
    as manobras dos 5 s seguintes usarem o avanço.
    Empurrão travado: ataque em contato por mais de 1,6 s aparece no log,
    no comando A do stream e no painel, sem soltura. Nas lutas simuladas,
    soltar o empurrão (ré e curva, pivô sob pressão, giro no eixo ou ré em
    curva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
2026-10-14 feat(painel): travamento, manobras e aquecimento do motor no painel
    A linha A do stream ganha o travamento (empurrão travado ou giro preso),
    a quantidade de manobras DESTRAVA e o aquecimento estimado do motor, e o
    painel mostra os três junto da estratégia.
2026-10-14 ci: limite de 3 s mirando objeto de fora na bateria de lutas
    Com o giro preso resolvido, uma luta da bateria que antes empatava em
    90 s passa a durar 36 s com o oponente encostado na lateral e chega a
    2,5 s mirando pessoas fora do dojô; a média por luta continua abaixo de
    0,4 s.
2026-10-14 docs: README e página com o travamento e o modelo térmico
    Seção "Travamento" com o giro preso, o empurrão travado, os números das
    manobras testadas nas lutas simuladas e o modelo térmico dos motores;
    configuração, comandos e diagrama de estados atualizados. A página da
    cinemática ganha o estado DESTRAVA.
2026-10-14 fix(cinematica): roda abaixo de 2 mm/s fica parada na fuga da borda
    Na SAIDA_LATERAL a roda de dentro recebe v - w.B/2, que dá zero só no
    papel. Com a bitola de 127,3 mm do STL, o arredondamento do float deixava
    um resto de -0,00001 mm/s, e o sinal disso mandava a roda inteira para
    trás: o robô girava no eixo em vez de fazer a curva apoiado na roda de
    dentro. O teste da máquina de estados pegou a falha com a bitola nova.
2026-10-14 feat(config): geometria do robô montado a partir do STL
    A geometria do robô (GEOMETRIA_BANCADA 0) era um quadrado de 152 mm com
    o eixo no meio. O STL do projeto mecânico tem as rodas atrás: a ponta da
    rampa fica 117,7 mm à frente do eixo e a traseira 25 mm atrás, com 149 mm
    de largura. FE, FC e FD ficam nas janelas da face inclinada, LE e LD nas
    aberturas das laterais, TE e TD na face de trás do berço dos motores, e
    os quatro TCRT5000 nas janelas da base (o par de trás 54 mm à frente do
    eixo). A bitola passa a 127,3 mm, com o corte de 2 mm na ponta dos eixos.
    O mundo do teste/sim usa o mesmo contorno e o centro de massa 26,9 mm à
    frente do eixo, a página das lutas desenha o cont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
2026-10-14 feat(teste): combate com o mesmo firmware nos dois robôs
    Cada módulo do firmware entra duas vezes no mesmo programa, nos
    namespaces fa e fb, sem nenhuma linha do firmware mudar, e o Arduino de
    mentira atende o robô da vez. A física tem os três apoios de cada robô
    (pneus e ponta da rampa), o atrito do pneu na madeira laminada parado e
    escorregando, a rampa entrando por baixo da lateral e da traseira do
    outro, os JGB37-520 de 319 e de 1000 rpm, a bateria 3S e os sensores
    numa sala à noite. O mesmo código compila para o computador (bateria de
    lutas) e para WebAssembly (página 3D).
2026-10-14 feat(doc): página 3D do combate com as peças do STL
    combate.html roda os dois firmwares em WebAssembly e mostra a luta em 3D
    com a base, o corpo, o suporte da eletrônica, as abraçadeiras, os
    JGB37-520, os cubos e os pneus do STL, no dojô da RoboCore, numa sala em
    Belo Horizonte às 20h00 de 2 de setembro. A tela escolhe a estratégia e
    a largada do Grupo D e a cor, os motores e a estratégia do adversário, e
    mostra o estado de cada firmware, a telemetria e a bateria de lutas.
2026-10-14 ci: bateria de combate e página 3D no GitHub Pages
    O job novo compila o simulador de combate, roda 48 lutas com o mesmo
    firmware nos dois robôs e falha com qualquer queda própria do Grupo D;
    depois compila o mesmo código para WebAssembly com o Zig 0.14. O
    workflow da página gera o combate.html com uma bateria de 120 lutas.
2026-10-14 docs: README com o combate e a geometria do STL
2026-10-14 fix(teste): motor de 1000 rpm com um terço do torque e pneu sem perder atrito ao patinar
    O adversário de 1000 rpm usava a linha de 10000 rpm (1,6 kgf.cm), quase o
    torque do motor do Grupo D, e segurava o empurrão. Agora é o mesmo motor
    da linha de 6000 rpm com redução de 6:1 (0,6 kgf.cm, um terço do torque),
    como na tabela do JGB37-520. O pneu de borracha macia passa a ter o mesmo
    atrito parado e patinando: o atrito da borracha cresce com a velocidade
    de escorregamento até um pico acima de 1 m/s (Grosch, 1963), e o modelo
    antigo, com 14% a menos patinando, entregava o empurrão a quem estava
    com a roda parada.
2026-10-14 feat(teste): detecção do Grupo D e controle manual no simulador de combate
    A ponte de cada firmware entrega a leitura de cada VL53L0X, a borda crua
    e o mapa comprimido do rastreador, o mesmo da linha M do painel. O
    controle manual troca o PWM do firmware pelo das teclas no robô escolhido,
    depois dos 5 s parados dele, com o firmware rodando e lendo os sensores.
    A bateria passa a guardar o tempo médio de vitória por motor.
2026-10-14 feat(doc): detecção como no painel e controle manual na página 3D
    Só o robô do Grupo D mostra sensores: cone de cada VL53L0X com a calota
    na distância medida, mapa de probabilidade do rastreador, caixa vermelha
    do oponente na posição estimada e um círculo embaixo de cada TCRT5000.
    A localização no dojô fica numa camada própria. O controle manual dirige
    o robô do Grupo D ou o adversário pelas setas, W A S D ou pelos botões
    na tela.
2026-10-14 docs: README com o motor de 1000 rpm, o atrito do pneu e o resultado novo
2026-10-14 feat(estados): abertura de cada estratégia na largada
    No dojô de 77 cm, cada robô vê o outro assim que os 5 s acabam, e as três
    estratégias faziam a mesma coisa: a investida do oponente cancelava o
    flanco, e o leque só valia na busca sem pista. Com o oponente a até 60°
    da frente no fim da contagem, o Rush vai direto, o Flank sai num arco de
    75° ao lado dele por até 0,7 s, mesmo com ele vindo rápido, e o Fan out
    chega em zigue-zague (estado novo LEQUE), com ataque direto a 14 cm.
    O ângulo do arco saiu do combate com o mesmo firmware nos dois robôs, com
    o Flank largando de frente: 30 derrotas em 40 lutas com 60° e 1 s, 12 com
    75° e 0,7 s. Com 80° foram 5, mas numa luta do tes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
2026-10-14 feat(teste): placar por estratégia na bateria de combate e na página
2026-10-15 feat(estados): empurrão travado pela caixa do rastreador, com manobras que saem no config.h
    A caixa do oponente parada (25 mm e 12 graus de tolerância) por 1,2 s no ataque, com o oponente
    encostado, marca o empurrão travado. Manobras: lateral, torque, zigue, giro e pulso, escolhidas em
    ANTI_TRAVA_MANOBRA ou pelo comando trava N. ANTI_TRAVA 0 tira o módulo.
2026-10-15 feat(teste): física de Belo Horizonte, pneu de silicone na madeira pintada e choque com restituição
    Gravidade normal do GRS80 na latitude da UFMG com as correções de 830 m, arrasto do ar da sala,
    atrito do StickyMAX S20 (1,15 parado e 1,30 escorregando) e força de contato de Flores e
    coautores com restituição de 0,4.
2026-10-15 feat(teste): fator de atrito e restituição na bateria, na linha de comando e na página
2026-10-15 docs: README com a detecção do travamento e o resultado de cada manobra
2026-10-15 docs: README e textos da página com a física nova e a bateria de sensibilidade
2026-10-15 feat(doc): malhas do chassi e dos componentes eletrônicos para a montagem 3D
2026-10-15 ci: confere as páginas versionadas e publica o que está no repositório
2026-10-15 fix(antitrava): giro no eixo com tensão toda desde o primeiro instante
    O giro usava o perfil normal, com limitador de aceleração, e a manobra de 200 ms mal começava a
    girar antes de o oponente empurrar o robô para trás. Agora usa o perfil da borda (sem rampa).
2026-10-15 feat(doc): alerta de robô travado e largada do adversário na página do combate
    O alerta pisca quando o firmware marca empurrão travado, ré da DESTRAVA ou manobra da caixa parada,
    com o nome de quem está travado. O seletor de largada do adversário aceita frente, lado, costas ou
    sorteada. As notas das manobras avisam que contra o igual de 319 rpm elas perdem no simulador.
2026-10-15 feat(antitrava): LED opcional, manobra escolhida no config.h e como ajustar o perfil escuro
    PINO_LED_TRAVA (-1 desliga e tira o código do binário) acende enquanto o empurrão estiver travado
    ou a manobra de destravar rodar. O config.h ganha o bloco "O que fazer quando o empurrão travar",
    com as cinco manobras comentadas (descomentar só uma), e o "COMO AJUSTAR" dos limiares ESCURO_*,
    dizendo o que acontece ao aumentar e ao diminuir cada um.
2026-10-15 feat(config): geometria e sensores do chassi do STEP LAB3-Modelagem
    Rampa a 118 mm do eixo, base 31 mm atrás, bitola de 126,8 mm e tampa da frente a 55 mm. Cada
    VL53L0X usa o suporte de PLA do Cults3D: FE, FC e FD nas janelas da rampa, LE e LD na janela
    lateral da frente e TE e TD na janela lateral perto do eixo, retos (90 graus). Os TCRT5000 da
    frente ficam nos furos da base e os de trás atrás dos motores, para fora do chassi.
    TOF_ALCANCE_LATERAL_MM (80 mm) limita os ToF laterais: com duas janelas por lateral olhando
    para o mesmo lado, a plateia em volta do dojô aparecia nos dois e o rastreador somava as leituras
    e mirava uma pessoa por dezenas de segundos. Na bateria de 540 lutas com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
2026-10-15 feat(combate): chassi do STEP, adversário de 600 rpm e bateria refeita
    O simulador usa a geometria do STEP (ponta da rampa a 118 mm, base 31 mm atrás, bitola de
    126,8 mm) e ganha um adversário com motor intermediário que existe à venda: JGB37-520 de 12 V,
    redução de 10:1, 600 rpm e 1,1 kgf.cm (tabela da RCDrone). Travado ele empurra com 13,5 N, acima
    do que o pneu segura, então bate no mesmo limite de tração do de 319 rpm e só chega mais rápido.
    A opção -m do combate e --motores da bateria aceitam 1000, 600 e 319; a página 3D ganha o
    seletor. Os textos da física dizem que entrar com a lâmina por baixo da lâmina do outro não dá
    vantagem a quem entra: o robô levantado pas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
2026-10-15 feat(montagem): chassi do STEP, suporte dos sete VL53L0X e protoboard de 81 x 55 mm
    A página da montagem passa a usar o STEP LAB3-Modelagem (step_para_stl.py separa uma peça por
    STL; exporta_pecas.py converte para o referencial do robô). Os sete sensores de oponente usam o
    suporte Mounting Bracket for VL53L0X Module, do Cults3D. Sem placa de expansão: o ESP32 vai numa
    protoboard de 400 pontos (81 x 55 mm) na tampa da frente, a chave DIP no furo A e o botão de
    ligar no furo B da tampa de trás, com o furo C como passa-fios.
    O doc/montagem/README.md traz o espaço que sobra e o que falta no chassi, com as medidas:
    suportes do LE e do TE sobrepostos em 10 mm, rasgo e janelas na rampa, com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
2026-10-15 docs: README com o chassi do STEP, o motor de 600 rpm, a protoboard e os resultados novos
    Geometria e bitola do STEP, motor de 600 rpm na tabela da física, tabelas de resultado da bateria
    de 180 lutas (por adversário, estratégia, largada, atrito) e da tabela das manobras do empurrão
    travado, alcance dos ToF laterais com a medida de cada valor, montagem com a protoboard de 81 x 55
    mm e a lista de pendências do chassi.
2026-10-16 fix(combate): página 3D gerada de novo com o firmware do alerta de travado
    O commit da manobra no config.h mudou o firmware compilado no WebAssembly, mas o
    doc/site/combate.html continuou com o wasm anterior, e o CI do combate acusou a página
    desatualizada. Página gerada com teste/combate/compila.sh wasm e doc/gera_combate.py.
2026-10-16 refactor: separa firmware, painel, site, documentação, ferramentas e testes em pastas
    O sketch passa para firmware/sumo_esp32/, plano como a Arduino IDE exige (a pasta já tem o nome
    do .ino, então o zip do GitHub e o git clone abrem direto na IDE). O painel vai para painel/,
    as páginas do GitHub Pages para site/, os PDFs para doc/pdf/, os modelos das páginas para
    doc/combate/ e doc/montagem/, os scripts Python para ferramentas/ e os testes de unidade para
    teste/unidade/.
    Os scripts, o CI, o workflow do Pages, os compila.sh dos simuladores e o .gitignore seguem os
    caminhos novos. O painel e a página do combate gerados de novo saem idênticos; na página da
    montagem mudam só os caminh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
2026-10-16 fix(guia): gabarito do robô com o chassi do STEP e estudo de cobertura com a geometria dele
    Os guias de montagem ainda mostravam as posições de antes do chassi do STEP (FE a ±20 graus em
    x = 66 mm) e, gerados de novo, punham FE, FC e FD fora do contorno, porque o quadrado de 152 mm
    ficava centrado na origem. A página do robô passa a desenhar o corpo do chassi (CORPO_* do
    config.h, com a origem no eixo das rodas), o limite da classe centrado no corpo, as rodas na
    bitola do config.h e o texto de uso com os suportes de PLA. O estudo de cobertura de 08/10 usa a
    geometria do próprio estudo (robô de 152 mm, par a ±160 graus) e explica que no chassi do STEP o
    par fica reto, a ±90 graus. O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
2026-10-16 docs: README, CLAUDE.md e documentação da montagem com a estrutura nova
    O README ganha a instalação sem renomear pasta, a tabela de posições dos sensores no robô
    montado, o antitrava no diagrama de blocos, a estrutura de pastas nova com o papel de cada pasta
    e, na integração contínua, como ligar o GitHub Pages e como desfazer um pull request com o botão
    Revert. O CLAUDE.md resume a estrutura, os comandos que o CI roda, os arquivos gerados e as regras
    do repositório. O README da montagem e o LEIA-ME dos modelos apontam para os scripts em
    ferramentas/.
2026-10-16 feat(sensores): TE e TD a ±160° no robô montado e alcance próprio do par de trás
    O par de trás do robô montado volta a olhar para trás, a ±160°, como no estudo de 7 sensores:
    lente na face de fora da lateral (y = ±74 mm) para a borda da janela não cortar o cone. O limite
    de alcance dos laterais passa a valer só de 80° a 120° (LE e LD); o par de trás tem o próprio,
    TOF_ALCANCE_TRAS_MM (200 mm). Na bateria de 540 lutas com pessoas em volta do dojô o par a ±160°
    com o alcance inteiro mirou a plateia por até 53 s; com 200 mm o máximo foi 0,7 s, com 352
    vitórias (351 com o par reto).
2026-10-16 feat(doc): página do combate e da montagem com o par de trás a ±160°
    Wasm, bateria de 180 lutas (64 vitórias, 58 derrotas, 58 empates, nenhuma queda própria) e lista
    de interferências refeitos com a geometria nova.
2026-10-16 docs: README com o par de trás a ±160° e a pendência de largura do suporte
2026-10-16 docs: README e config.h sem os textos do par de trás reto a ±90°
2026-10-16 feat(combate): MuJoCo como segunda física do simulador de combate
    A opção -F mujoco troca só quem calcula o movimento: corpo rígido de seis graus de liberdade com as
    malhas convexas do STEP, pneus em cilindros, ponta da rampa e dojô, com o modelo de motor, bateria e
    ponte H do fisica.cpp aplicado como torque nas rodas. Firmware, sensores e regra de saída do dojô são
    os mesmos. A cena de cada luta é girada de um ângulo sorteado e a ordem dos robôs no modelo é
    sorteada, porque o desempate do MuJoCo favorecia em 84 a 16 o robô que largava em +x. Sem MUJOCO=1 o
    simulador compila como antes e a física à mão continua a padrão (e a do WebAssembly).
2026-10-16 feat(teste): empurrão frente a frente nas duas físicas e job do MuJoCo no CI
    O empurrão em malha aberta roda nas duas físicas (319 contra 319, 600 e 1000 rpm). O job do CI
    instala o MuJoCo 3.16.0 e exige que o MuJoCo decida 95% dos empurrões em 3 s, que robôs iguais
    fiquem entre 30% e 70% de vitórias e que o robô levantado perca em 85%, além de uma bateria pequena
    com o firmware sem queda própria.
2026-10-16 Cones do combate e do painel com o alcance real de cada ToF
    As páginas desenhavam todos os cones com 600 mm, mas o firmware só aceita leituras
    até TOF_ALCANCE_LATERAL_MM nos laterais (LE, LD) e TOF_ALCANCE_TRAS_MM no par de trás
    (TE, TD). Um oponente dentro do cone desenhado, mas além desse limite, não era lido e
    não ganhava a caixa do rastreador, o que parecia defeito de detecção.
    - doc/combate_src.html: alcanceSensor com os dois limites
    - doc/painel_src.html: alcSensor com os limites; debug.cpp manda os dois na linha X
    - doc/confere_site.py: confere as constantes de alcance da página do combate com o config.h
    - páginas geradas de novo e README
2026-10-16 Stub do MuJoCo sem exit() no WebAssembly
    O exit(2) do stub fazia o combate.wasm importar wasi_snapshot_preview1.proc_exit,
    que a página 3D não fornece, e o navegador não carregava o firmware. No wasm o stub
    agora não faz nada (a opção nunca é pedida lá). Página gerada de novo.
2026-10-16 Distância da plateia ao dojô no config.h e no README
    Nenhum ToF lê a plateia a mais de 48 cm do robô com a ponta da rampa na linha, 13 cm com a
    traseira na linha e 21 cm de lado. A conta sai do config.h em doc/alcance_plateia.py, com a
    tabela e as ressalvas (plano contra pessoa, localização do dojô) no README e o resumo ao lado
    dos alcances no config.h.
2026-10-16 chore: CLAUDE.md da raiz no .gitignore
    O guia local do Claude Code sai do controle de versão (git rm --cached) e entra no .gitignore;
    a árvore de pastas do README deixa de citá-lo.
2026-10-18 feat: montagem 3D no chassi de dois andares do editor v11 (#39)
    A página da montagem passa a usar o chassi de dois andares do grupo (14 STL em
    doc/montagem/modelos/chassi) e as peças do editor 3D v11, com as posições dos
    sensores, os suportes e as ligações novas.
    - exporta_pecas.py lê o HTML do editor, gera pecas.js com a cor de cada peça e
    editor.json com a pose das peças repetidas (ajuste de Kabsch, erro máximo 0,4 mm)
    - roteia_fios.py novo: caminho de cada fio no volume das peças, com folga de 1,5 mm
    - gera_montagem.py: confere o config.h contra as poses do editor (2 mm e 1 grau),
    trios S, V e G da extensora por GPIO, protoboard só para o barramento I2C,
    tabela de conec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
2026-10-20 fix: montagem sem protoboard, SDA e SCL em duas emendas soldadas (#39)
    O barramento de I2C dos sete VL53L0X se junta em duas emendas com
    termorretrátil atrás da fileira de trás da extensora, cada uma com um
    jumper curto até o pino S do GPIO 21 ou 22. A protoboard sai do modelo,
    da página, das ligações e do roteamento (78 fios, todos com caminho).
2026-10-20 feat: ganho de giro menor no ataque e varredura de parâmetros no simulador (#41)
    - config.h e estados.cpp: K_ATAQUE (2) no ATAQUE, no lugar do K_MIRA (6). Rush de frente,
    1000 lutas de 20 s: 704 vitórias com 6, 715 com 2; validação de 90 s com sementes novas:
    418 contra 424 (melhorou 7 lutas, piorou 1)
    - teste/combate/varre.py: variante do firmware contra o firmware atual congelado, lutas
    sorteadas e placar pareado
    - compila.sh: FW_A e FW_B, diretório do firmware de cada robô
    - simulador: opções -q (distância das pessoas) e -n (desvio do rumo na largada)
    - README: seção "Otimização do ataque com os motores de 319 rpm" (colocação de frente, Rush,
    parâmetros testados e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
2026-10-20 feat: página de controle dos motores pelo teclado em site/controle_motores.html
    Web Serial com os comandos mov, pwm e stop do firmware, teclas W, A, S, D e setas, e a seção do README sobre o uso da página com os sensores desligados.
2026-10-20 feat: STEP final dividido em um STL por objeto (cad/) e documentação do robô montado
    Os 25 objetos da árvore do CAD (LAB3-Modelagem_2) viram 25 STL em cad/stl/, com o ferramentas/step_por_objeto.py, o indice.json e o cad/README.md (referencial, peças de impressão, correspondência com o firmware e diferenças para o config.h). O README da raiz passa a descrever o robô montado sem protoboard, com 7 sensores, a lista de materiais completa (extensora, célula 18650 da lógica, TPS63070, chave KCD1, botão de início, chave DIP e fio 22 AWG) e a pasta cad/.
2026-10-21 feat: partida automática (AUTO_START) para o robô sem botão de início, DIP e chave
    Com AUTO_START 1, depois de AUTO_START_ESPERA_MS com os sensores de oponente
    prontos e o perfil do oponente aplicado, a ESPERA pede o start sozinha, uma
    única vez por ligada. O comando stop, o go e o botão BOOT continuam valendo.
    O padrão é 0. Teste no computador e README atualizados.
    Closes #43
2026-10-21 feat(telemetria): WiFi opcional (USAR_WIFI 0 ou 1) e painel pela rede do robô
    Com USAR_WIFI 0 (padrão) nenhuma linha do rádio é compilada e o firmware
    fica igual ao anterior. Com 1, o ESP32 cria a rede SUMO-ROBO (ou entra no
    roteador configurado) e atende /stream (Server-Sent Events), /cmd e /ping
    na porta 80, com CORS liberado e resposta ao OPTIONS. O envio nunca bloqueia
    o loop: linha de dados que não cabe na rede é descartada e linha de texto
    guarda o resto para a volta seguinte, então os quadros chegam sempre inteiros.
    WIFI_DESLIGA_SEM_PAINEL 1 desliga o rádio quando a luta começa sem painel
    conectado, e os comandos wifi e wifi off mostram e desligam a rede.
    O painel ganha a es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
2026-10-21 feat(painel): calibração da pista para o sensor de linha parar de alucinar
    Cartão "Calibração da pista" no painel (USB ou Wi-Fi): mede o preto do dojô e a faixa
    branca de 2,5 cm com pares de sensores, calcula para cada sensor o pior preto e o pior
    branco e grava um limiar com margem dos dois lados (comando bordalim, na NVS).
    Firmware: calpista on/off (linha J com mínimo, máximo e média de cada sensor por janela
    de 20 ms), bordalim NOME LIM [PRETO BRANCO], 11º campo da linha R (limiar de pista) e
    aviso de sinal digital quando o fio do sensor está no D0.
    Painel: assistente de quatro passos, tabela com margens, falso positivo e faixa perdida,
    histogramas, aviso de D0 e nível boa,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
2026-10-21 feat(painel): demonstração com alinhamento ao oponente, controle WASD e guia da configuração
    Três cartões no painel (USB ou Wi-Fi) para mostrar o robô sem botão de início, sem chave
    e sem modo autônomo:
    - Alinhar com o oponente: comando alinha on|off. Em ESPERA o robô só gira no eixo, em pulsos
    com pausas para os ToF medirem, até o oponente ficar a menos de ALINHA_TOL_DEG da frente;
    de lado ou de costas gira em pulsos de busca; não anda e não consulta a linha; termina por
    tempo, stop ou go. Linha Z do protocolo mostra a fase, o erro, o tempo e os pulsos.
    - Controle remoto WASD (teclado, setas e botões da tela), com cinemática ou PWM direto. O
    mov e o pwm ganham o 4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
2026-10-21 fix(teste): taxa de quadros do painel espera uma janela inteira de um segundo (falhava de vez em quando no CI)
2026-10-21 Opções do robô gravadas pelo painel: modo autônomo, linha de lado, 5 ou 7 ToF, contagem e Wi-Fi na luta
    O painel ganha o cartão Opções do robô, que manda "ajuste NOME VALOR" e grava
    na NVS do ESP32, sem regravar o firmware:
    - modo autônomo (AUTO_START), válido na próxima ligada;
    - sensores de linha da frente como no CAD ou colados de lado (90° anti-horário);
    - 5 ou 7 sensores de oponente (o robô reinicia em 1 s);
    - contagem de 5 s girando até alinhar, sem andar, com o BOOT reiniciando a contagem
    (também no meio da luta com o modo autônomo);
    - Wi-Fi ligado durante a luta.
    QTD_TOF e AUTO_START do config.h viram valor de fábrica, GEOMETRIA_BANCADA fica
    sempre em 0, e as tab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
2026-10-21 Wi-Fi leve: só o essencial pelo rádio para o controle remoto e os ajustes
    Pelo Wi-Fi o robô mandava a telemetria completa (D, Q e A a 50 Hz e o mapa M
    a 4 Hz, uns 13 KB/s), que disputa os buffers do lwIP e o ar com cada comando
    do /cmd; no robô, o controle remoto e os ajustes ficaram lentos.
    - opção "leve" (ajuste leve 0|1, gravada na NVS, valor de fábrica WIFI_LEVE 1):
    pelo rádio a linha D sai a cada 100 ms, a Q e a A a cada 250 ms e o mapa M
    não sai (uns 2 KB/s); textos, cabeçalho, Z do alinhamento e J da calibração
    passam como antes; a USB não muda;
    - a linha A passa a contar como dado: com a rede cheia era guardada como texto
    e travava o resto do stream;
    - ponto de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
2026-10-21 Alinhar com o oponente: o robô fica no lugar, só acompanha o que os ToF da frente veem
    Na demonstração a linha é ignorada, então o robô não pode sair do lugar. Antes, sem ver o oponente,
    ele girava em pulsos de busca de 30° pela arena toda. Agora:
    - sem oponente na frente (ou além do que os ToF alcançam) fica parado na fase 1, sem pulso nenhum;
    - depois de perder o oponente, segue a estimativa do rastreador por ALINHA_SEGUE_MS (500 ms);
    - o giro total desde o rumo em que foi colocado e ligado nunca passa de ALINHA_GIRO_MAX_DEG (90°)
    para cada lado, e o terminal avisa quando o oponente passa disso;
    - a linha Z ganha o giro desde o início e o limite, e o painel mostra "giro +12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
2026-10-21 Wi-Fi leve: o mapa de probabilidade volta, a 2 Hz
    O modo leve cortava o mapa M inteiro, mas o pedido era manter a imagem com menos taxa e throughput.
    Agora o leve manda as leituras de todos os sensores a 10 Hz (D), Q e A a 4 Hz e o mapa a cada
    WIFI_LEVE_M_MS (500 ms, 0 tira o mapa): uns 3,6 KB/s no total contra uns 13 KB/s da completa.
    O mapa é linha de dados, então continua sendo descartado antes de qualquer comando quando a rede enche.
    teste_wifi.cpp confere o mapa a 1 a 3 por segundo no rádio e menos que na USB; smoke_opcoes.mjs
    confere 4 mapas/s na completa, 2 mapas/s no leve e o mapa fresco na tela.
2026-10-21 Posição medida dos sensores de linha de lado: x 83 mm e y 93 mm
    Medidas do chassi provisório (21/10): centro do par de LEDs a 35 mm da ponta da rampa (118 - 35 = 83 mm do centro)
    e sensores saindo 16,3 mm (esquerdo) e 17,9 mm (direito) para fora do chassi de 75,5 mm de meia largura (93 mm).
    Antes eram 77 e 81 mm, estimados do módulo girado. Só a localização no dojô e o painel usam esses números;
    a fuga da borda não depende deles.
    Closes #55
2026-10-22 Alinhar com o oponente: só os três ToF da frente contam
    Na demonstração o oponente só vale se FE, FC ou FD o vê e o ângulo estimado cai no campo deles
    (ALINHA_FRENTE_MAX_DEG 35). Visto só por um lateral (LE, LD) ou por um traseiro (TE, TD), o robô
    fica parado; alinhado, se o oponente sai da frente e só o lateral o vê, deixa de valer como alinhado
    depois de ALINHA_PERDE_MS e não vai atrás. ALINHA_SO_FRENTE 0 volta a usar todos. A luta e a contagem
    de 5 s continuam com todos os sensores.
    teste_alinha.cpp: visto só pelo LE a 80 graus, só pelo TE a 170 graus e alinhado com o oponente indo
    para o lado; os três falham com ALINHA_SO_FRENTE 0.
    Closes #57
2026-10-22 Luta com o dojô vazio: vigia parada que só varre a frente
    Sem achar o oponente (ele caiu ou o dojô está vazio), a BUSCA não fica rodando e dando avanços para
    sempre. Depois de 4 s sem ver o oponente, de uma volta inteira de giro desde a última vez que ele foi
    visto e com o rastreador sem pista, o robô para no lugar e só o cone da frente varre um setor de
    +-45 graus em volta de onde ele parou: pulsos de 15 graus a 120 graus/s com 0,6 s parado entre eles,
    3 para a esquerda, 6 para a direita, 6 para a esquerda... Sai na hora em que algum sensor vê o oponente
    ou o rastreador volta a achar que ele existe; a borda continua com prioridade. VIGIA_* no config.h,
    VIGIA_DOJO_VAZIO 0 desliga,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
2026-10-22 Página do combate gerada de novo com a posição lateral medida
    A posição dos sensores de linha de lado entra no WebAssembly do combate (borda_x e borda_y), então o
    site/combate.html precisa ser regenerado.
